Glebjack/NDM-VOS_powder_hopper/ref/IMG_20230818_101742_008.jpg

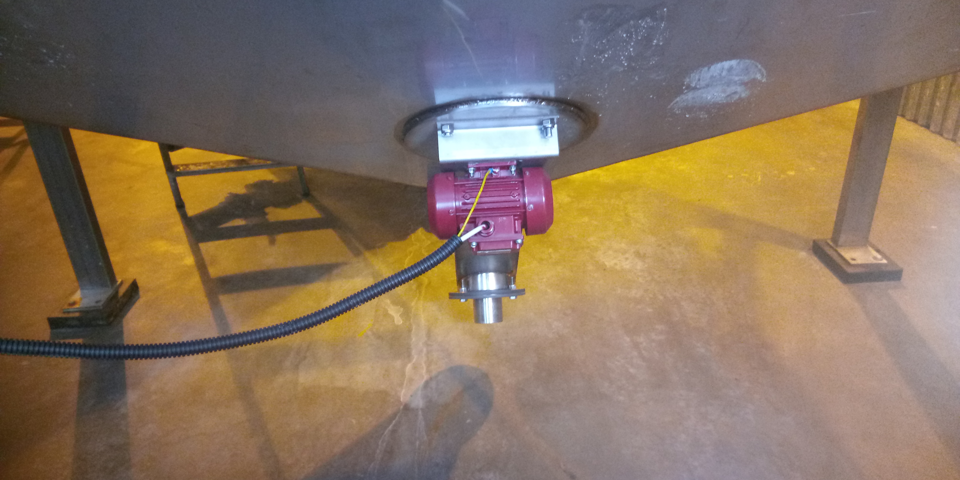
ref/IMG_20230818_101742_008.jpg
