Glebjack/NDM-VOS_powder_hopper/Доп. информация/Расчет шнекового конвейера Надым.pdf

Расчет шнекового конвейера Исходные данные
Материал - Каустическая сода
Насыпная плотность материала | ρн = 2.13 т/м³
Длина конвейера | L = 2
Угол наклона конвейера | f | 25deg =
Производительность | Q | 2 = | т/ч
Коэффициент заполнения желоба | φ = 0.25
Отношение шага винта к диаметру винта | E | 0.8 =
Частота вращения винта | n | 30 = | об/мин
Коэффициент уменьшения производительности
от наклона конвейера

Rβ = 0.5

Коэффициент абразивности | A = 45
Наибольший размер кусковматериала | amax = 0.015 | м

Определяемнеобходимый диаметр винта по формуле:
D | 0.275 | Q
En· ·φ ρн · Rβ · · | 0.275

2
0.8 30 · ·0.25·2.13·0.5 = | = | · | = 0.086 м

Проверяемчастоту вращения:

nmax

A
D

45
0.086
= | = | = 153.4 об/мин
nnmax ≤ | = 30 153.4 ≤ | = 1

Проверяемдиаметр винта:
Коэффициент для рядового груза | k | 4 =
Damax > | ·k = 0.086 0.015 4 > | · = 1
Подбираемстандартный диаметр и шаг винта из таблицы
Dст = 0.09 | м
Sст = 0.09 | м
Уточняемчастоту оборотов
nст | 0.275 | Q
EDст · | ·φ ρн · Rβ · · | 0.275

2
0.8 0.09 · | ·0.25·2.13·0.5 = | = | · | = 28.69 об/мин

Проверяемчастоту вращения

nст

A
Dст
≤ | 28.69

45
0.09
= | ≤ | = 1
Такимобразом, допустимая частота вращения винта | nст = 28.69 | об/мин

Определение мощностина валу винта Исходные данные
Горизонтальная проекция
длины конвейера
Lг1 = L cos f · () = 2 cos 25 deg · ( | ) · | = 1.81 | м
Lг | Lг1 = | = 1.81 | м
Высота подъема | H1 = L sin f · () = 2 sin 25 deg · ( | ) · | = 0.845 | м
H | H1 = | = 0.85 | м

Коэффициент сопротивления
перемещению груза

ω = 2.5

Коэффициент, учитывающий характер перемещения винта

R = 0.2

Погонная масса вращающихся частей конвейера

gk | 100 Dст = | · | = 100 0.09 · | = 9 | кг/м

Коэффициент сопротивления
движению вращающихся частей конвейера

ωв = 0.16

Осевая скорость движения груза | υ

Sст nст ·

60

0.09 28.69 ·
60 = | = | = 0.043 | м/с

Мощность на валу винта:

N0

Q
367
Lг ·( | ) ·ω + H | 0.02 R· gk · Lг · ωв + | · | 2
367 = | = | ·( | ) 1.81 2.5 · | + 0.85 + 0.02 0.2 · ·9·1.81·0.16 = 0.04 *
кВт

Определение мощностидвигателя для привода шнекового конвейера

Исходные данные
Коэффициент запаса мощности для
приводов шнеков

K = 1.25

КПДпривода | η = 0.85

Мощность двигателя:

N

KN0 ·

η

1.25 0.04 ·
0.85 = | = | = 0.059 | кВт
