Glebjack/NDM-VOS_powder_hopper/РАЗГРУЗЧИК 2.377.06.00.00 (2)/2.377.06.00.10_Бункер — копия.PDF

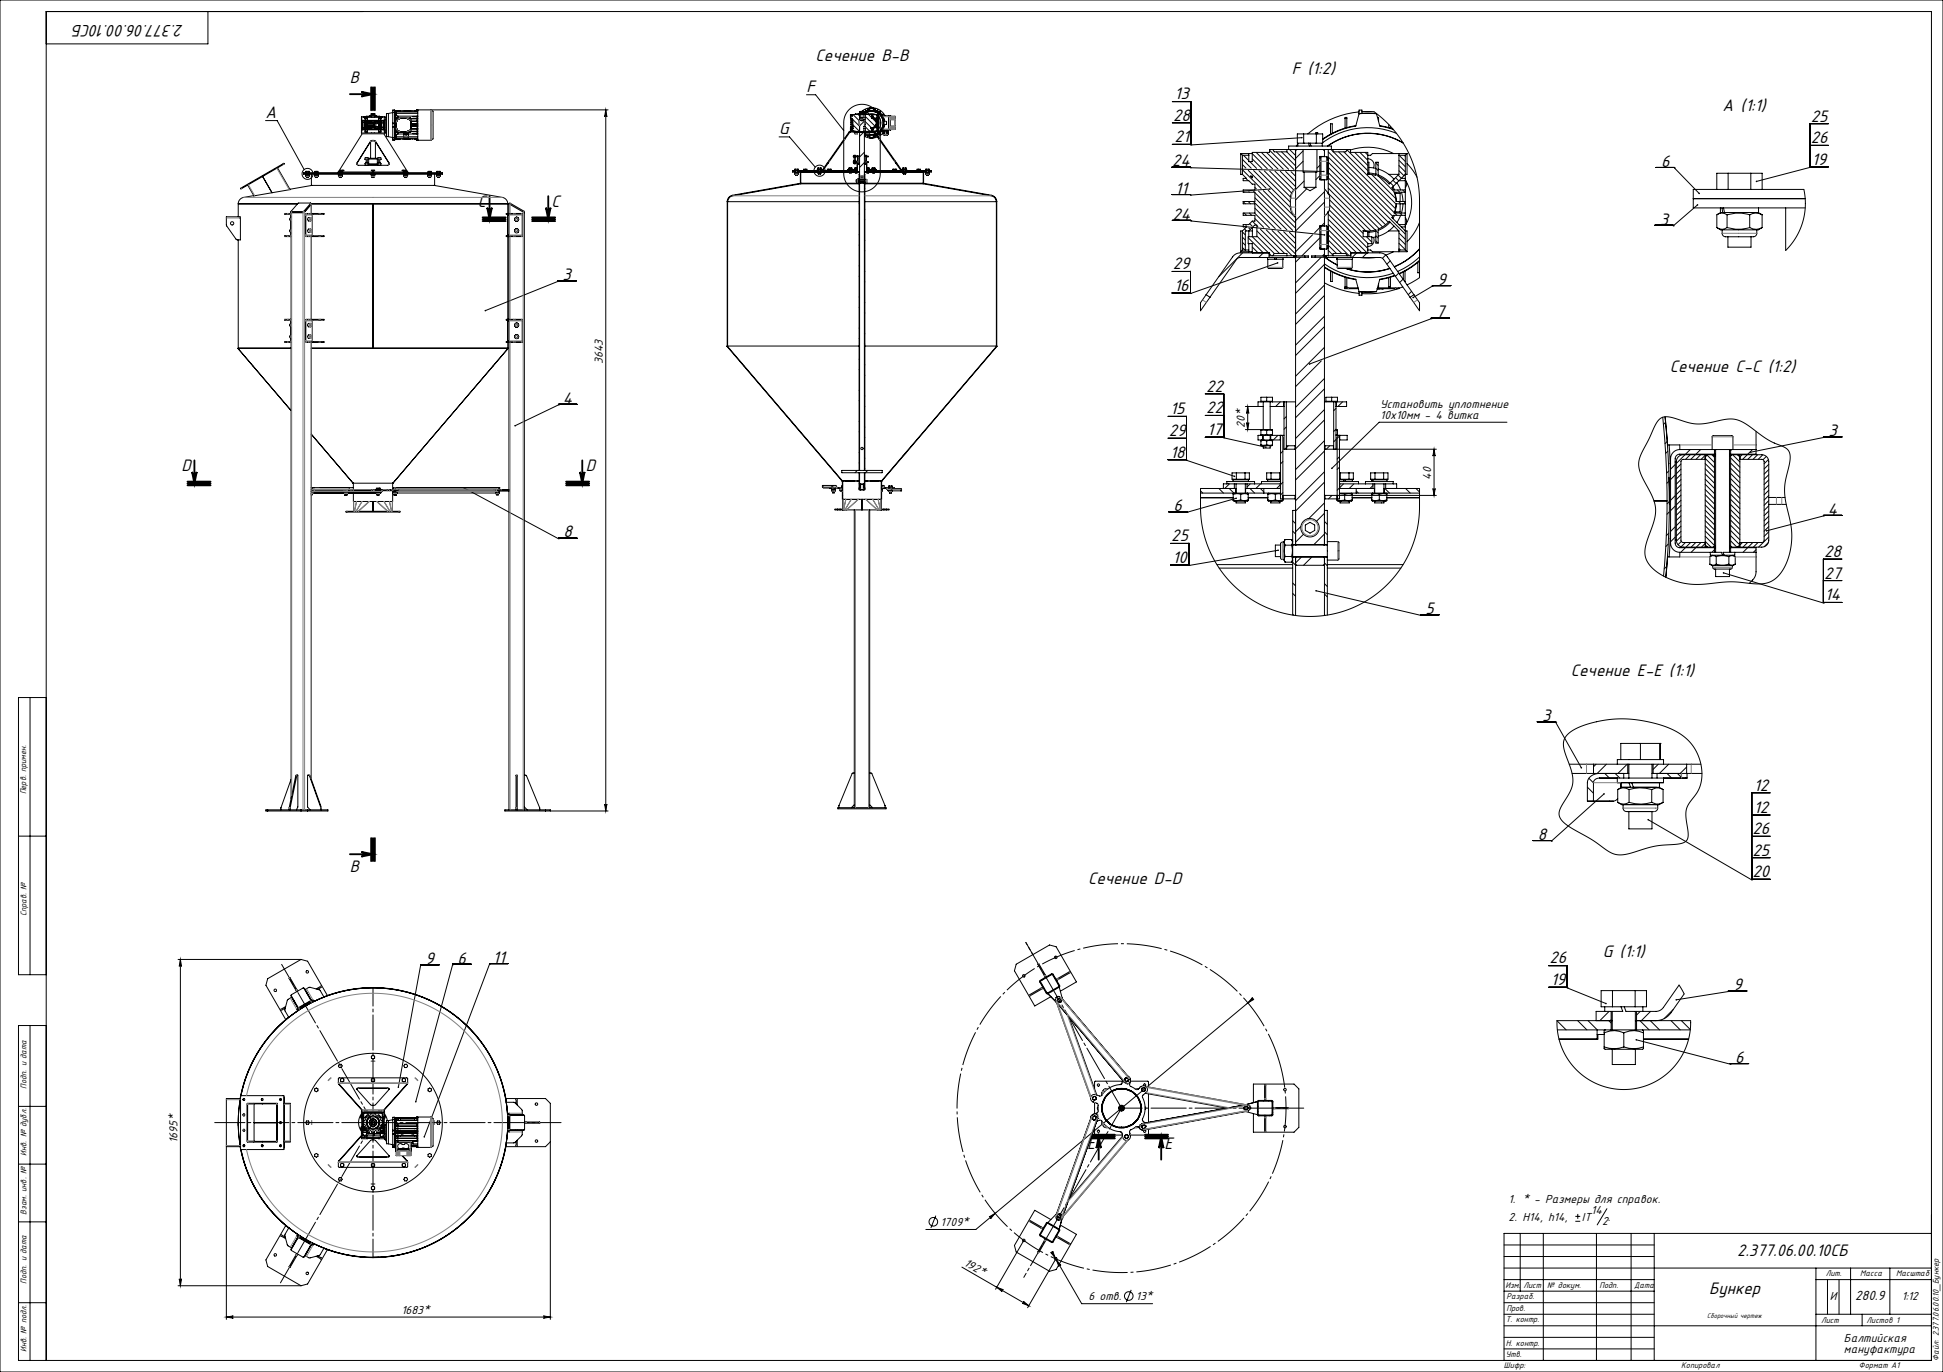
[picture p3: page 1]
Сечение B-B; Сечение C-C (1:2); 6 отв. 13*; Сечение D-D; Сечение E-E (1:1); Установить уплотнение 10х10мм - 4 витка; Инв. № подл.; Формат A1; Файл: 2.377.06.00.10_Бункер; Шифр:; Версия 3

Подп. и дата Взам. инв. № Инв. № дубл. Подп. и дата Перв. примен. Справ. №

1. * - Размеры для справок.

Бункер Сборочный чертеж | Лит. | Масса | Масштаб

Изм. Лист № докум. | Подп. | Дата | | | И | | 280.9 | 1:12
Разраб.
Пров.
Т. контр. | | | Лист | Листов 1

Балтийская мануфактура

Н. контр.
Утв.

Документация

A1 | 2.377.06.00.10СБ | Сборочный чертеж
| | Сборочные единицы
A4 | 1 | 2.377.05.03.20 | Толкатель | 1
A4 | 2 | 2.377.05.04.20 | Кронштейн | 1
A4 | 3 | 2.377.06.02.00 | Емкость | 1
A4 | 4 | 2.377.06.03.00 | Стойка | 3
A4 | 5 | 2.377.06.05.00 | Рыхлитель | 1
A4 | 6 | 2.377.06.07.00 | Крышка | 1

Детали

A3 | 7 | 2.377.06.00.03 | Вал | 1
A4 | 8 | 2.377.06.00.08 | Связь | 6
A3 | 9 | 2.377.06.00.09 | Кронштейн | 1

Стандартные изделия

10 | Болт М10х45 DIN 912 12.9 ОКС | 2
11 | Мотор-редуктор NMRV050 | 1
12 | Шайба 10 DIN125 | 18
13 | Шайба кузовная 12 DIN9021 | 1
14 | Болт М12х110 DIN 912 12.9 ОКС | 12
15 | Шайба кузовная 8 DIN9021 | 6
16 | Болт М8х16 DIN 912 | 4
| | 2.377.06.00.10

Инв. № подл. Подп. и дата Взам. инв. № Инв. № дубл. Подп. и дата Перв. примен. Справ. №

Формат А4

Копировал

Изм. Лист | № докум. | Подп. | Дата
| Разраб. | | | Бункер | Лит. | Лист | Листов
Пров. | | | | И | | 1 | 2

Н. контр.
Утв.

Файл: 2.377.06.00.10_Бункер

Формат
Зона
Поз.
Обозначение | Наименование

Кол.

Приме-чание

Инв. № подл. Подп. и дата Взам. инв. № Инв. № дубл. Подп. и дата

Лист
2
Копировал | Формат А4

2.377.06.00.10
Изм. Лист | № докум. | Подп. | Дата

Файл: 2.377.06.00.10_Бункер

| Наименование | | Приме-чание Обозначение
17 | Болт М6х40 DIN 933 | 3
18 | Болт М8х20 DIN 933 | 6
19 | Болт М10х25 DIN 933 | 18
20 | Болт М10х30 DIN 933 | 9
21 | Болт М12х25 DIN 933 | 1
22 | Гайка М6 DIN 934 | 6
23 | Стоп. кольцо 25 DIN 471 | 1
24 | Шпонка 8х7х20 DIN 6885 | 2
25 | Гайка М10 DIN985 | 23
26 | Шайба гр. М10 DIN127 | 27
27 | Гайка М12 DIN985 | 12
28 | Шайба гр. М12 DIN127 | 13
29 | Шайба гр. М8 DIN127 | 10

Кол.

Зона
Поз.

Формат
