Glebjack/NDM-VOS_powder_hopper/РАЗГРУЗЧИК 2.377.06.00.00 (2)/2.377.06.01.00_Транспортер — копия.PDF

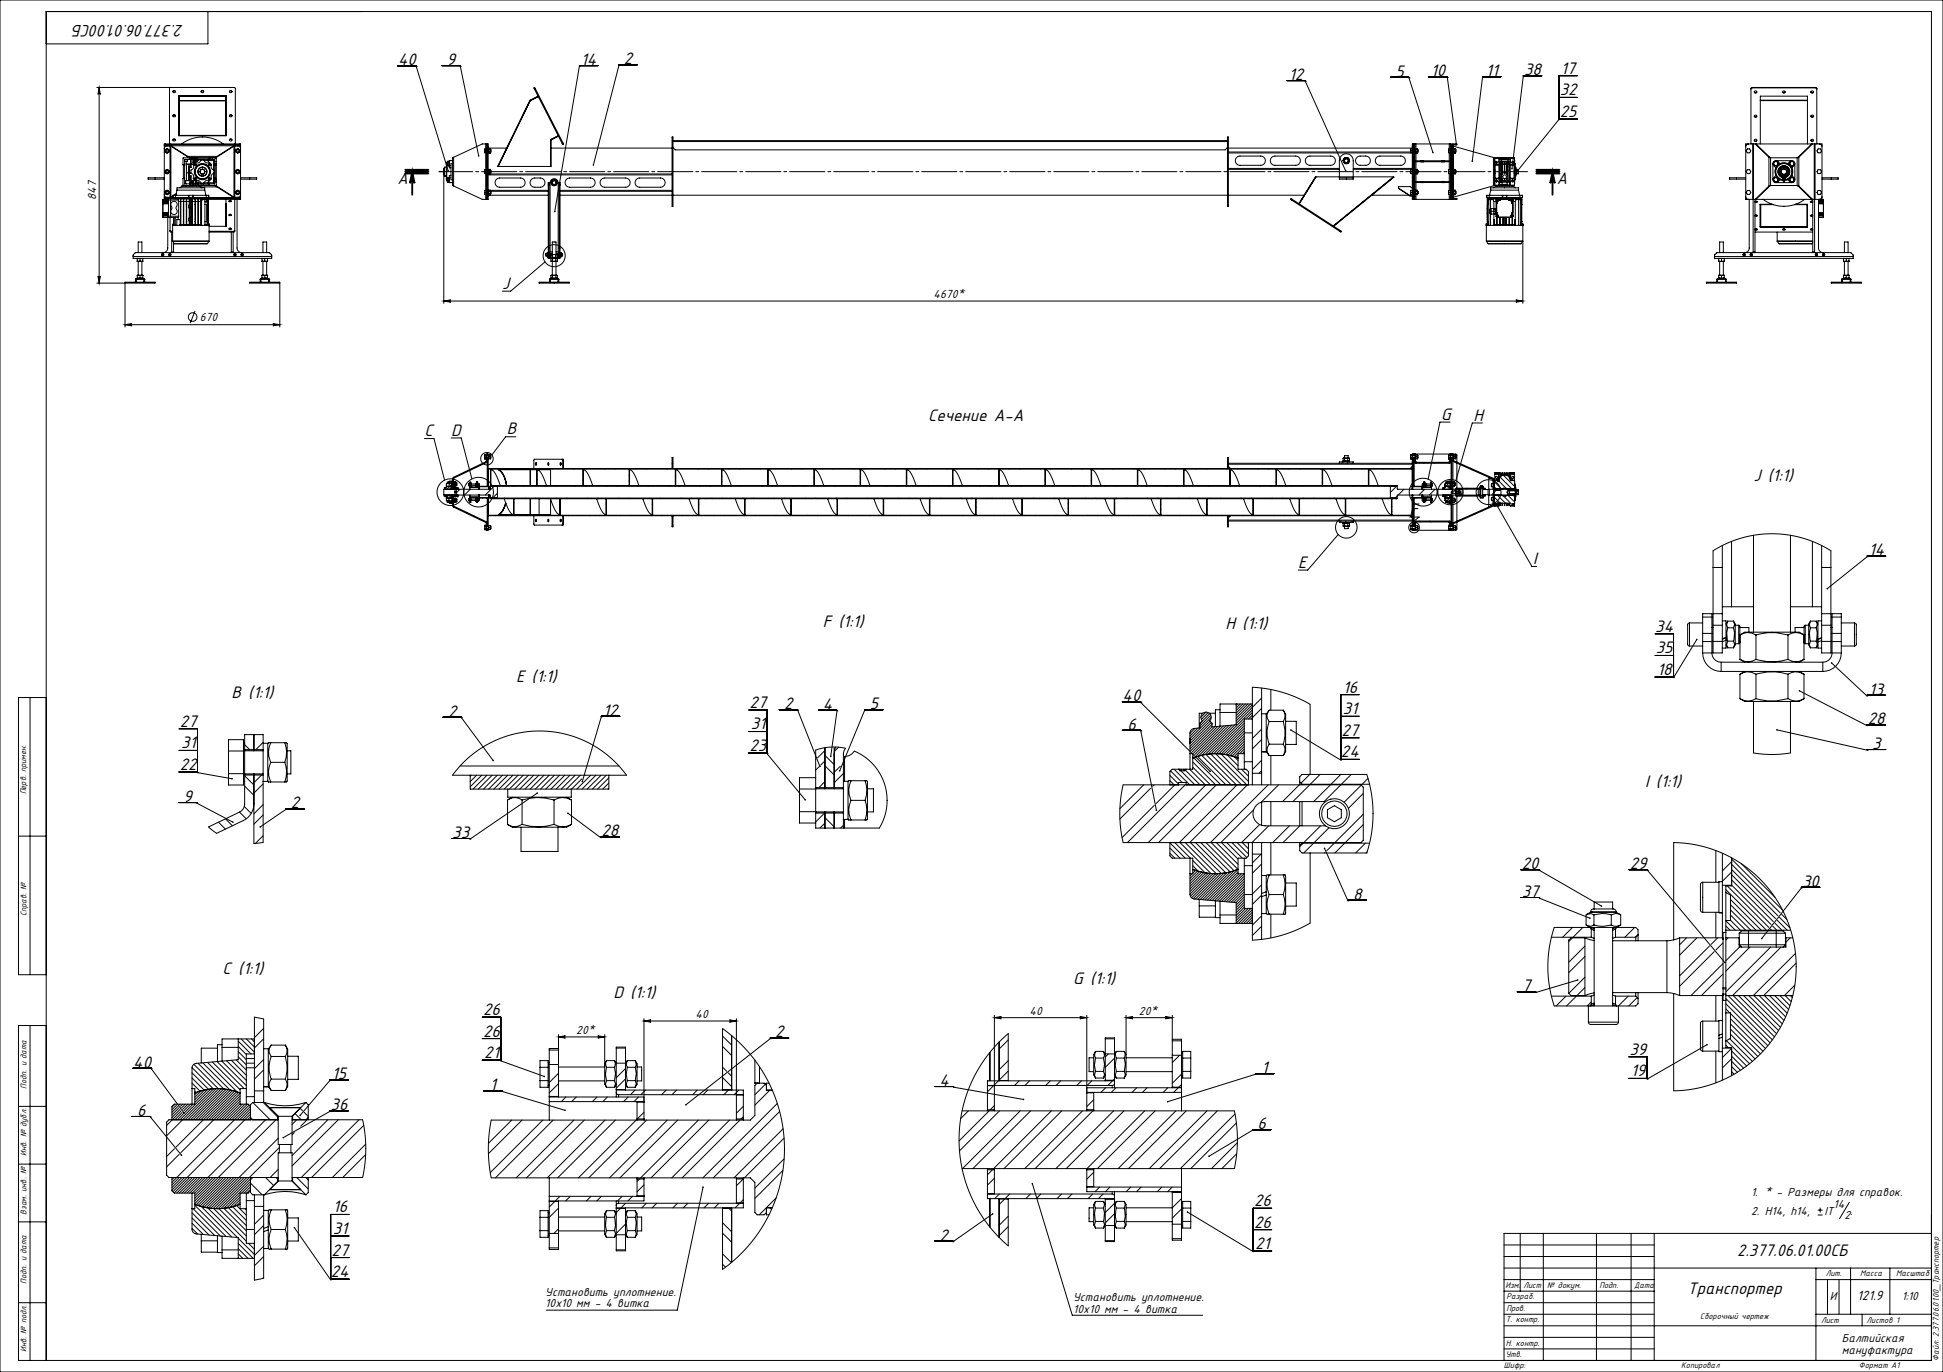
[picture p4: page 1]
Сечение A-A; Установить уплотнение. 10х10 мм - 4 витка; Инв. № подл.; Формат A1; Файл: 2.377.06.01.00_Транспортер; Шифр:; Версия 3

Подп. и дата Взам. инв. № Инв. № дубл. Подп. и дата Перв. примен. Справ. №

1. * - Размеры для справок.

Транспортер Сборочный чертеж | Лит. | Масса | Масштаб

Изм. Лист № докум. | Подп. | Дата | | | И | | 121.9 | 1:10
Разраб.
Пров.
Т. контр. | | | Лист | Листов 1

Балтийская мануфактура

Н. контр.
Утв.

Документация

A1 | 2.377.06.01.00СБ | Сборочный чертеж
| | Сборочные единицы
A4 | 1 | 2.377.05.03.20 | Толкатель | 2
A4 | 2 | 2.377.06.01.10 | Корпус | 1
A4 | 3 | 2.377.06.01.20 | Опора | 2
A4 | 4 | 2.377.06.01.30 | Фланец | 1
A4 | 5 | 2.377.06.01.40 | Проставка | 2
A4 | 6 | 2.377.06.04.00 | Шнек | 1

Детали

A3 | 7 | 2.377.06.00.01 | Вал | 1
A3 | 8 | 2.377.06.00.02 | Втулка | 1
A3 | 9 | 2.377.06.01.03 | Кронштейн | 1
A3 | 10 2.377.06.01.14 | | Пластина | 1
A3 | 11 2.377.06.01.15 | | Кронштейн | 1
A4 | 12 2.377.06.01.21 | | Уолок | 2
A3 | 13 2.377.06.01.24 | | Профиль | 1
A4 | 14 2.377.06.01.25 | | Профиль | 2
A4 | 15 2.377.06.04.03 | | Втулка | 1

Стандартные изделия

16 | Шайба 10 DIN125 | 8
| | 2.377.06.01.00

Инв. № подл. Подп. и дата Взам. инв. № Инв. № дубл. Подп. и дата Перв. примен. Справ. №

Формат А4

Копировал

Изм. Лист | № докум. | Подп. | Дата
| Разраб. | | | Транспортер | Лит. | Лист | Листов
Пров. | | | | И | | 1 | 2

Н. контр.
Утв.

Файл: 2.377.06.01.00_Транспортер

Формат
Зона
Поз.
Обозначение | Наименование

Кол.

Приме-чание

Инв. № подл. Подп. и дата Взам. инв. № Инв. № дубл. Подп. и дата

Лист
2
Копировал | Формат А4

2.377.06.01.00
Изм. Лист | № докум. | Подп. | Дата

Файл: 2.377.06.01.00_Транспортер

| Наименование | | Приме-чание Обозначение
17 | Шайба кузовная 12 DIN9021 | 1
18 | Болт М6х20 DIN 912 | 8
19 | Болт М8х16 DIN 912 | 4
20 | Болт М8х45 12.9 ОКС DIN 912 | 2
21 | Болт М6х40 DIN 933 | 6
22 | Болт М10х20 DIN 933 | 6
23 | Болт М10х25 DIN 933 | 12
24 | Болт М10х35 DIN 933 | 8
25 | Болт М12х30 DIN 933 | 1
26 | Гайка М6 DIN 934 | 12
27 | Гайка М10 DIN 934 | 26
28 | Гайка М16 DIN 934 | 8
29 | Стоп. кольцо 25 DIN 471 | 1
30 | Шпонка 8х7х20 DIN 6885 | 2
31 | Шайба гр. М10 DIN127 | 26
32 | Шайба гр. М12 DIN127 | 1
33 | Шайба гр. М16 DIN127 | 4
34 | Гайка М6 DIN985 | 8
35 | Шайба гр. М6 DIN127 | 8
36 | Винт М6х16 DIN7991 | 2
37 | Гайка М8 DIN985 | 2
38 | Мотор-редуктор NMRV050 | 1
39 | Шайба гр. М8 DIN127 | 4
40 | Подшипниковый узел UCF205 | 2

Кол.

Зона
Поз.

Формат
