Glebjack/NDM-VOS_powder_hopper/3d party/motovario-nmrv_075-1.snapshot.1/NMRV-075/NMRV_075.png

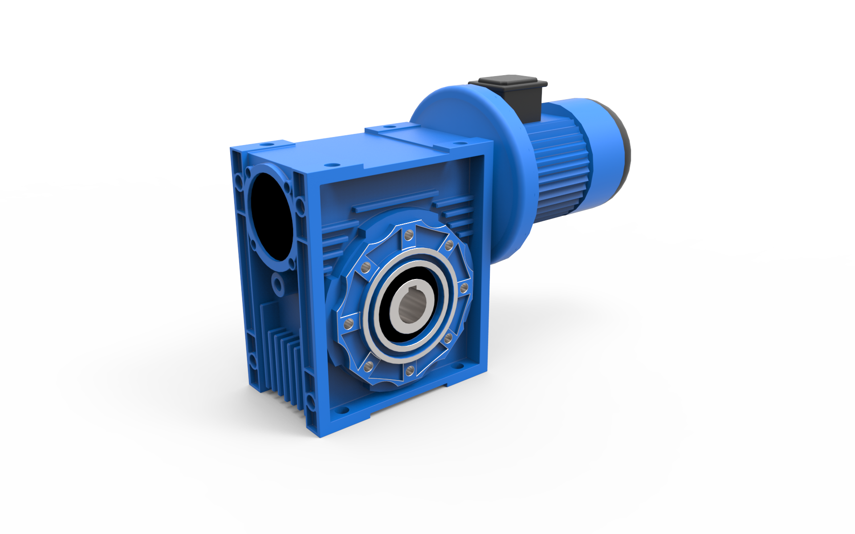
3d party/motovario-nmrv_075-1.snapshot.1/NMRV-075/NMRV_075.png
