Glebjack/NDM-VOS_powder_hopper/5IAM1zdPl06lRufuzuJ0.jpg

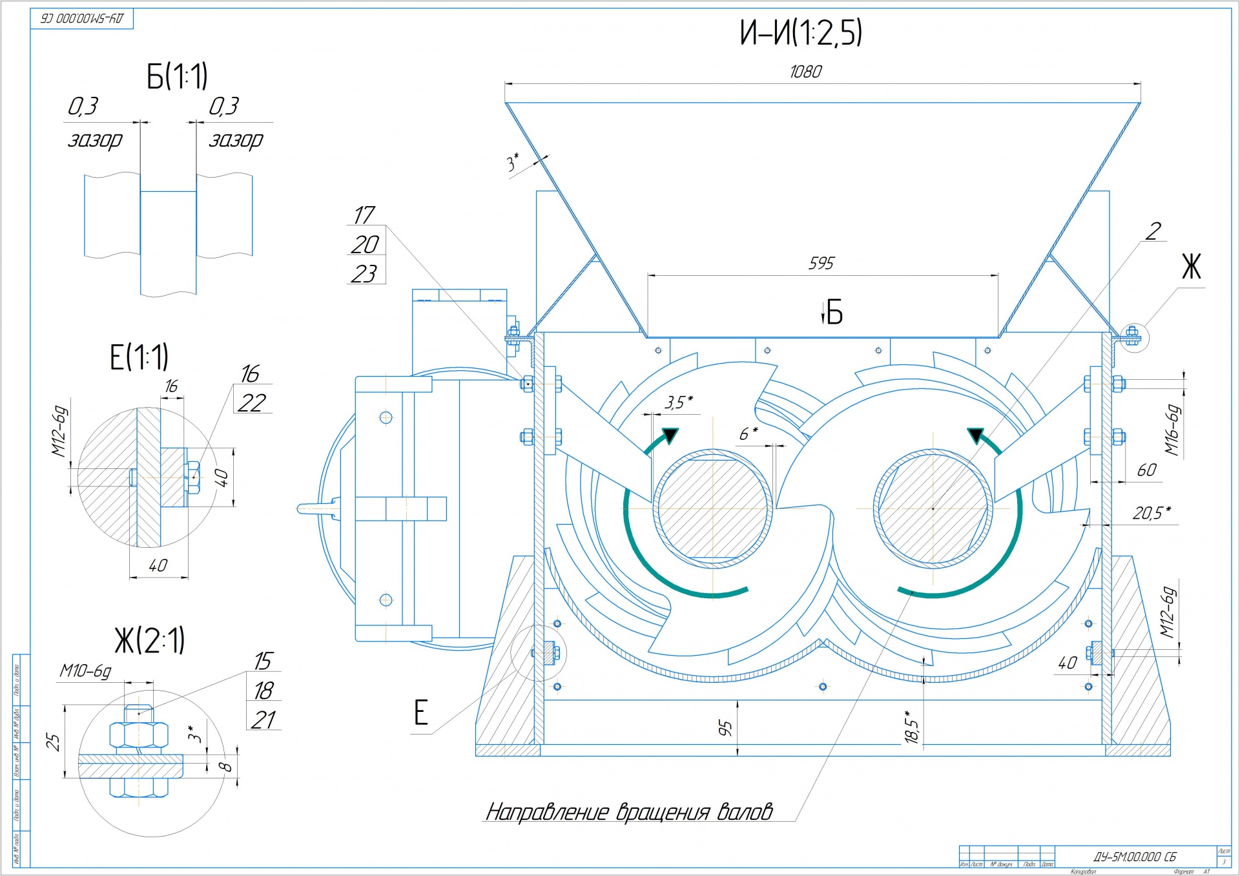
5IAM1zdPl06lRufuzuJ0.jpg
