Glebjack/NDM-VOS_powder_hopper/7G91Iu5bxzjjIsCC4TpQ.jpg

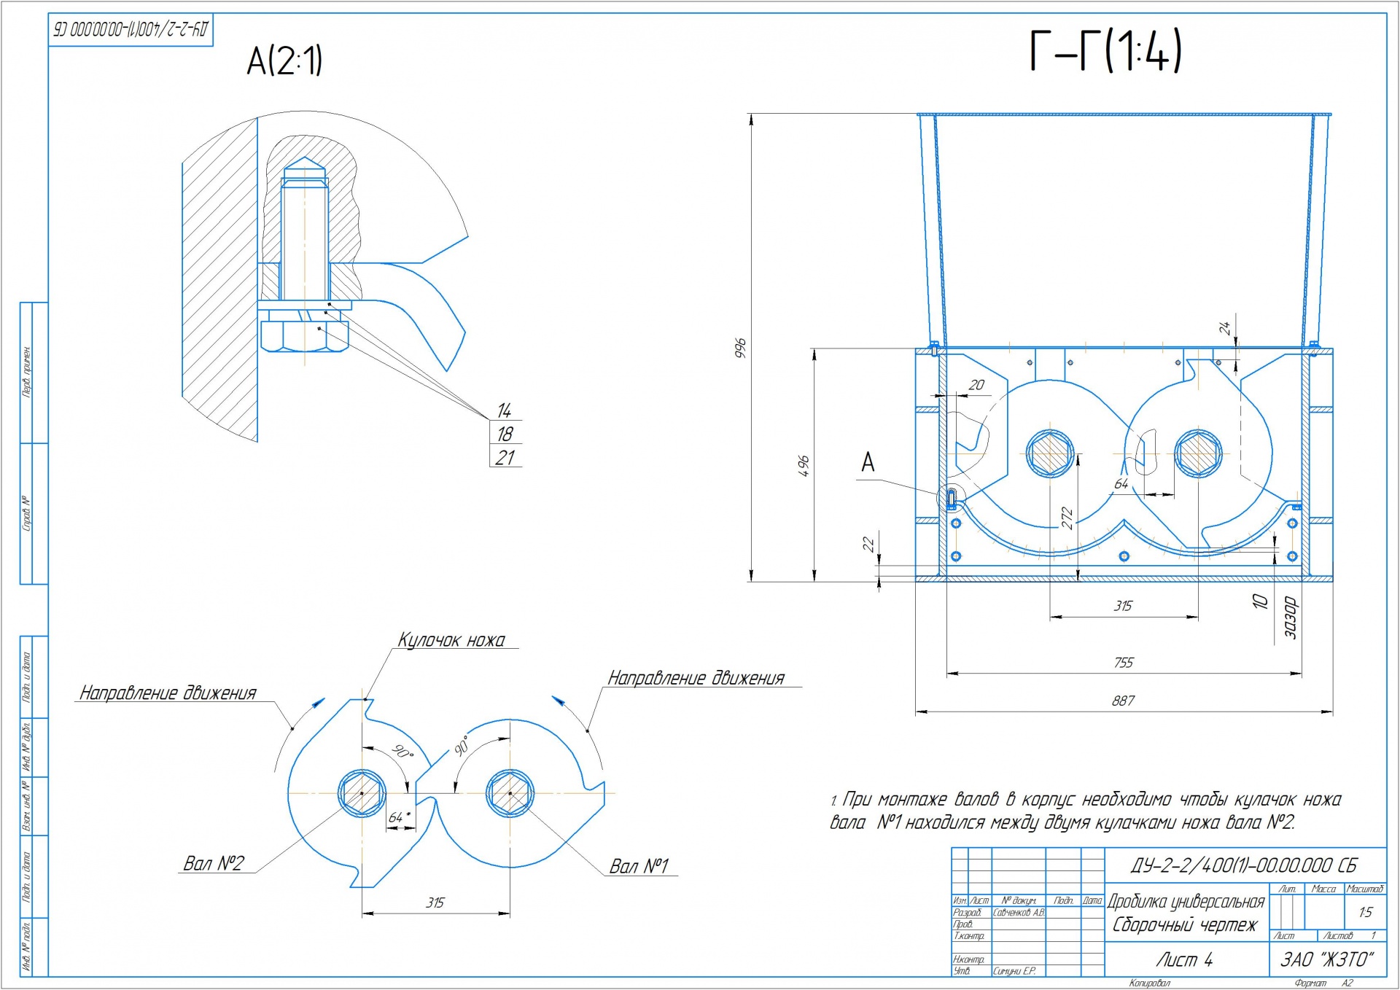
7G91Iu5bxzjjIsCC4TpQ.jpg
