Glebjack/NDM-VOS_powder_hopper/9t0ppVm1Xn2M7Ownl6md.jpg

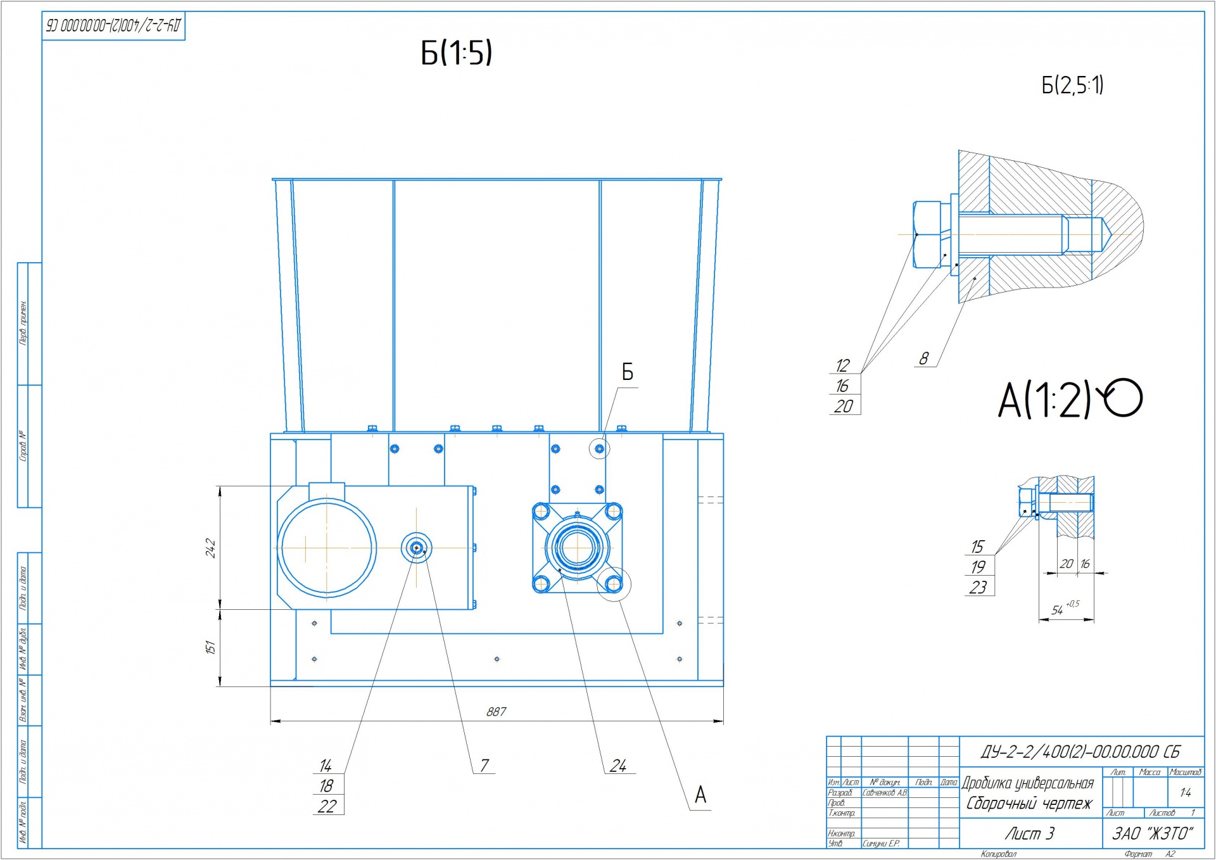
9t0ppVm1Xn2M7Ownl6md.jpg
