Glebjack/NDM-VOS_powder_hopper/15NcvYM45P90KHXVa7Lz.jpg

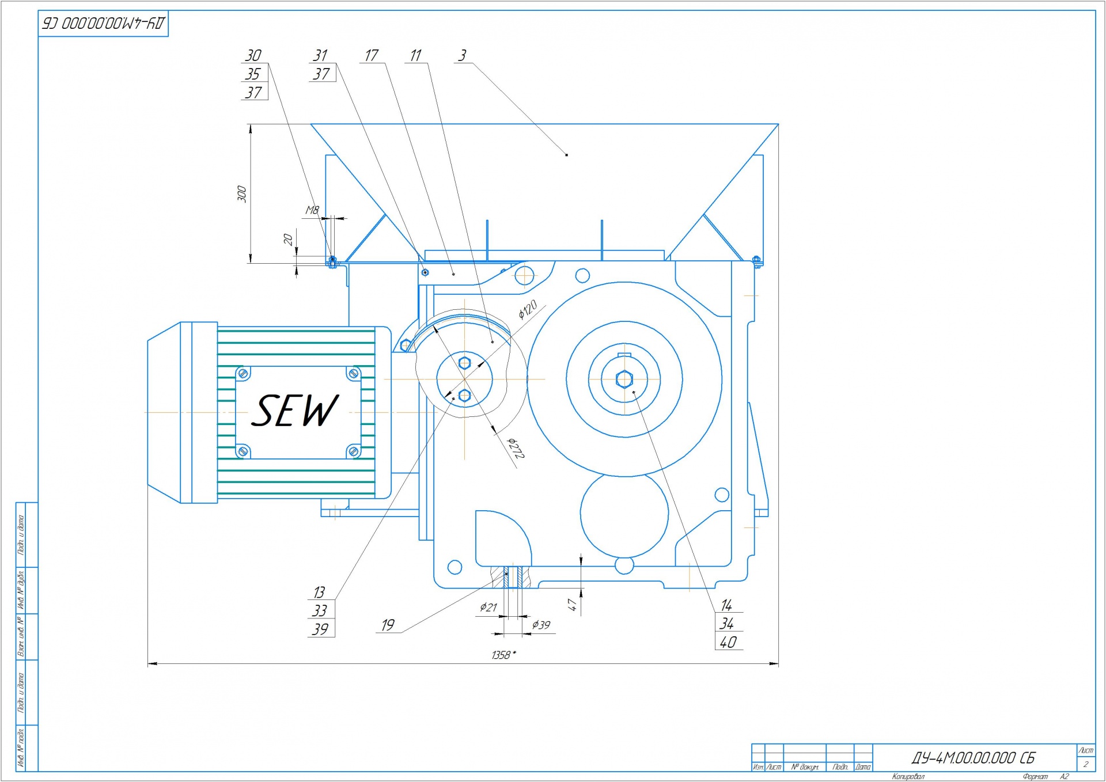
15NcvYM45P90KHXVa7Lz.jpg
