Glebjack/NDM-VOS_powder_hopper/6488771651.jpg

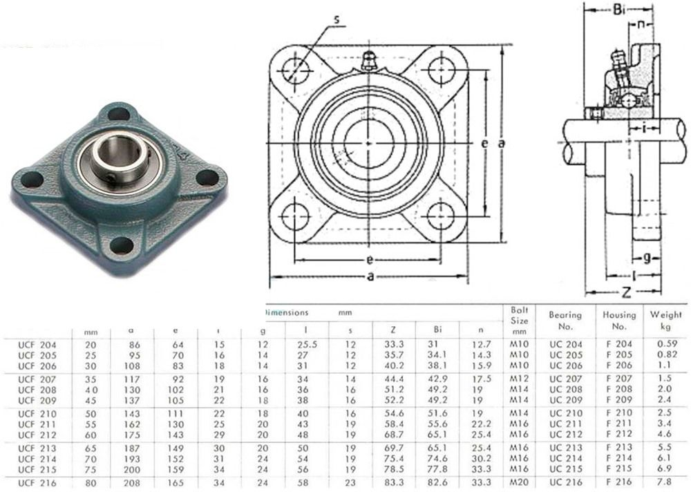
6488771651.jpg
