Glebjack/NDM-VOS_powder_hopper/BA31ilasgLpZYKsGnrt2.jpg

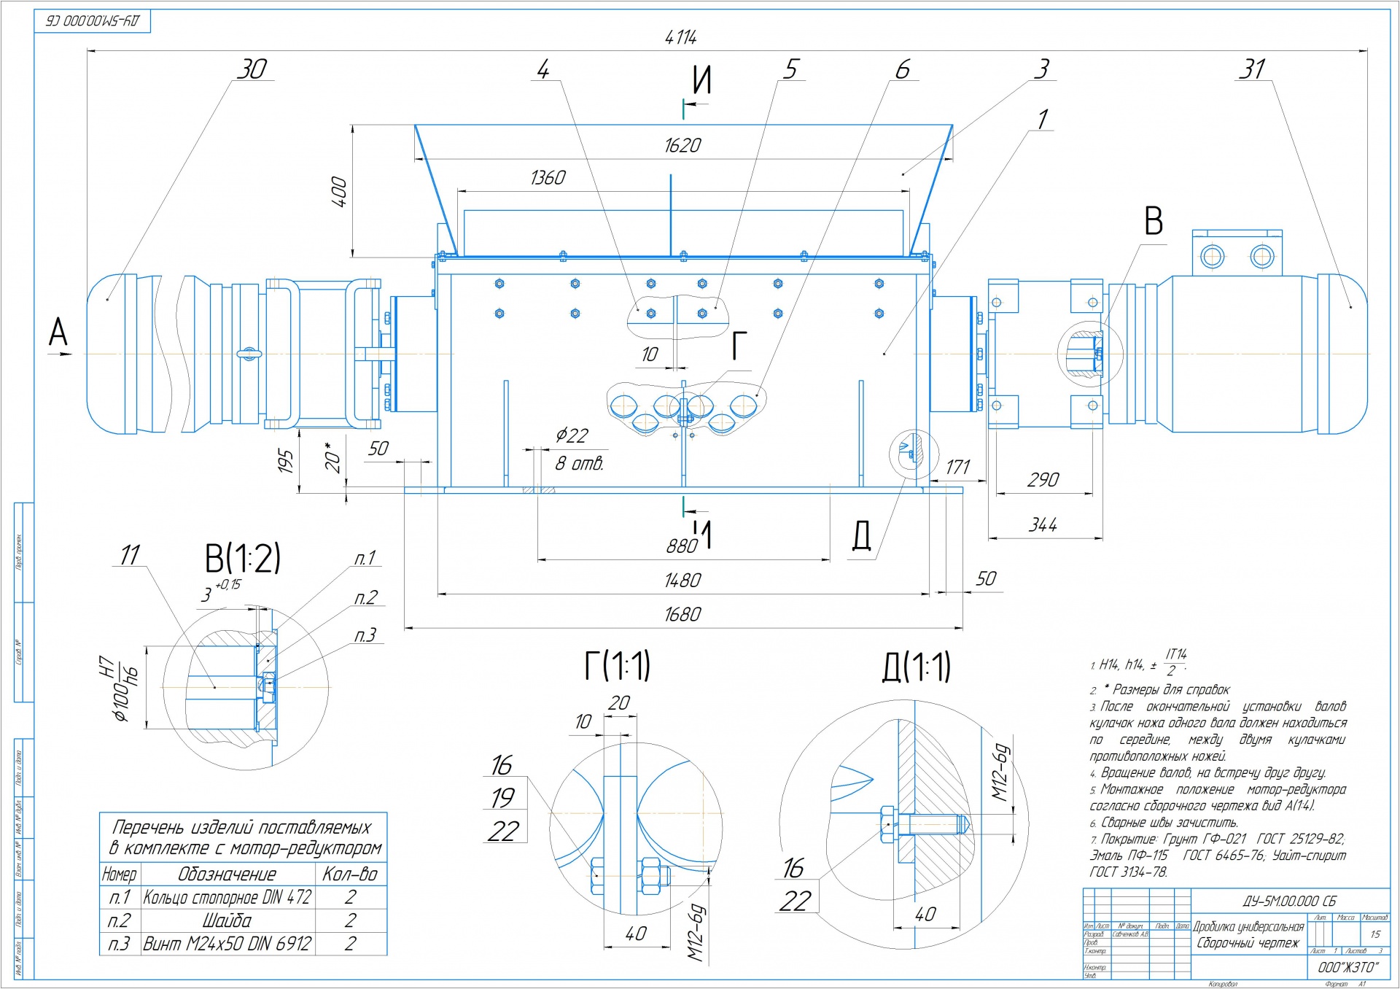
BA31ilasgLpZYKsGnrt2.jpg
