Glebjack/NDM-VOS_powder_hopper/duftldGrA66suCxcDFOZ.jpg

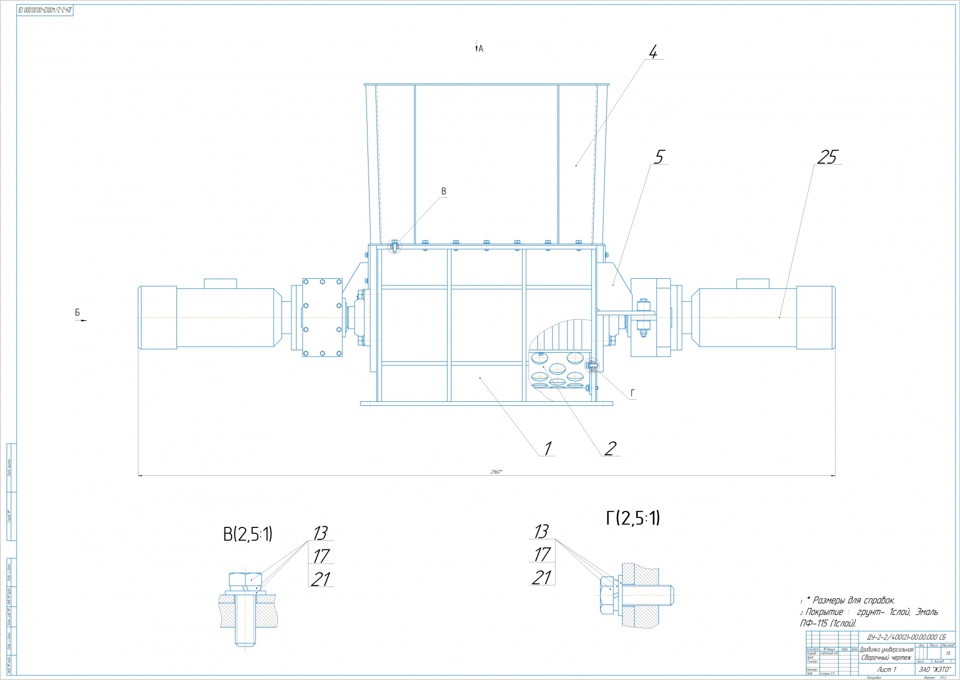
duftldGrA66suCxcDFOZ.jpg
