Glebjack/NDM-VOS_powder_hopper/LHYEUoByCzxDFlodkPbd.jpg

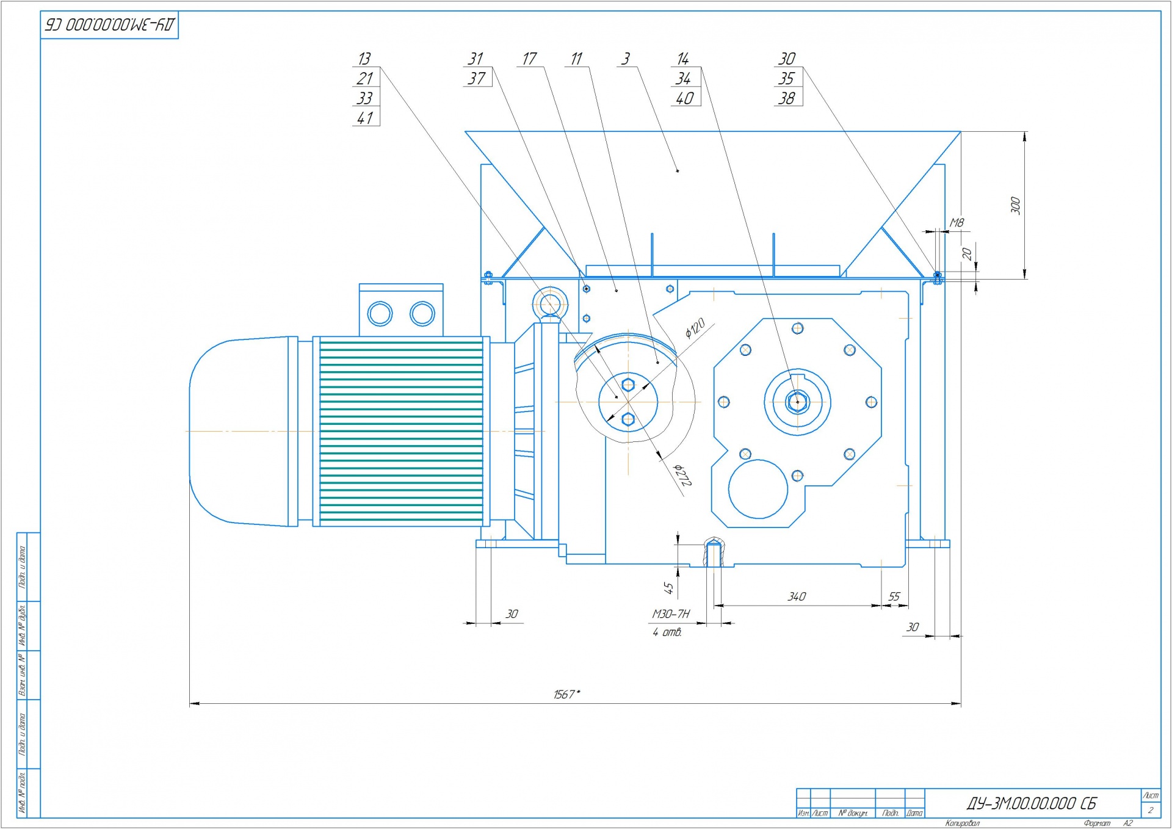
LHYEUoByCzxDFlodkPbd.jpg
