Glebjack/NDM-VOS_powder_hopper/QHXcVnzzSGTzGM04AitN.jpg

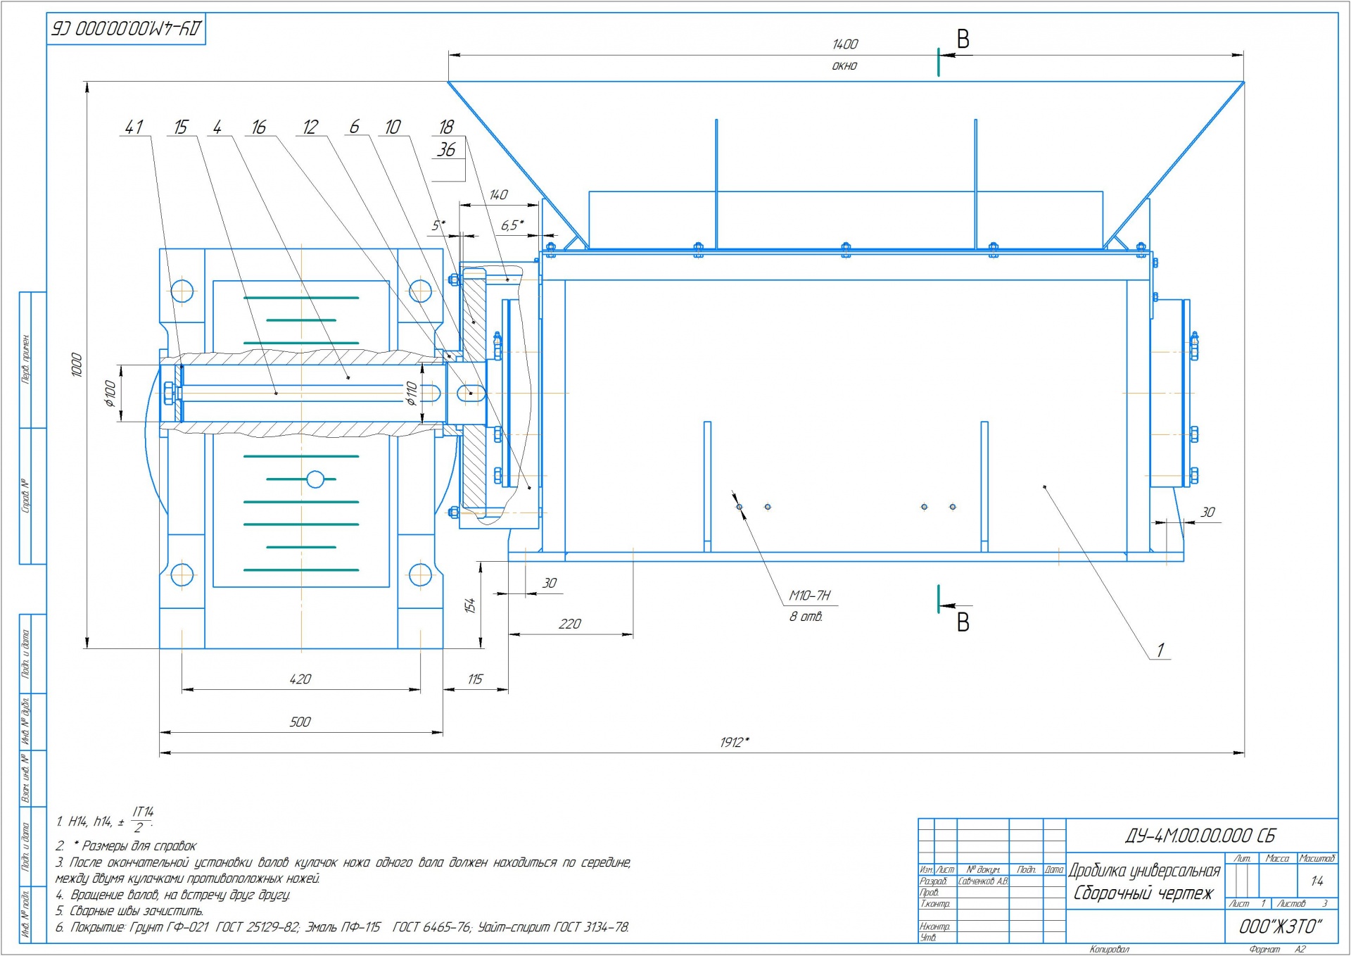
QHXcVnzzSGTzGM04AitN.jpg
