Glebjack/NDM-VOS_powder_hopper/ref/IMG_20230818_101705_347.jpg

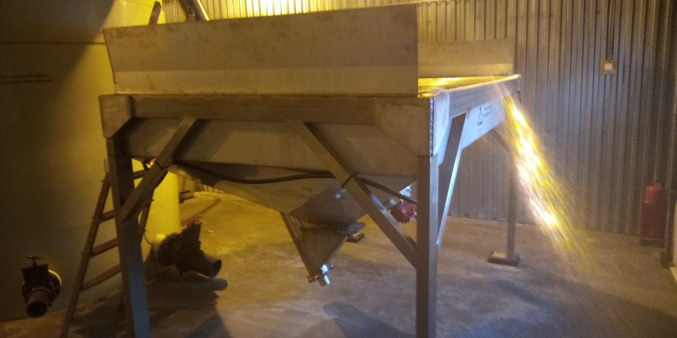
ref/IMG_20230818_101705_347.jpg
