Glebjack/NDM-VOS_powder_hopper/ref/IMG_20230818_101731_674.jpg

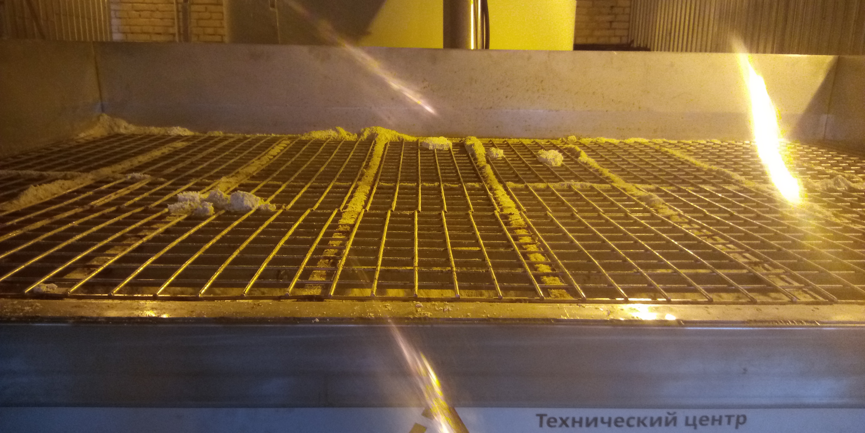
ref/IMG_20230818_101731_674.jpg
