Glebjack/NDM-VOS_powder_hopper/ref/IMG_20230818_101757_844.jpg

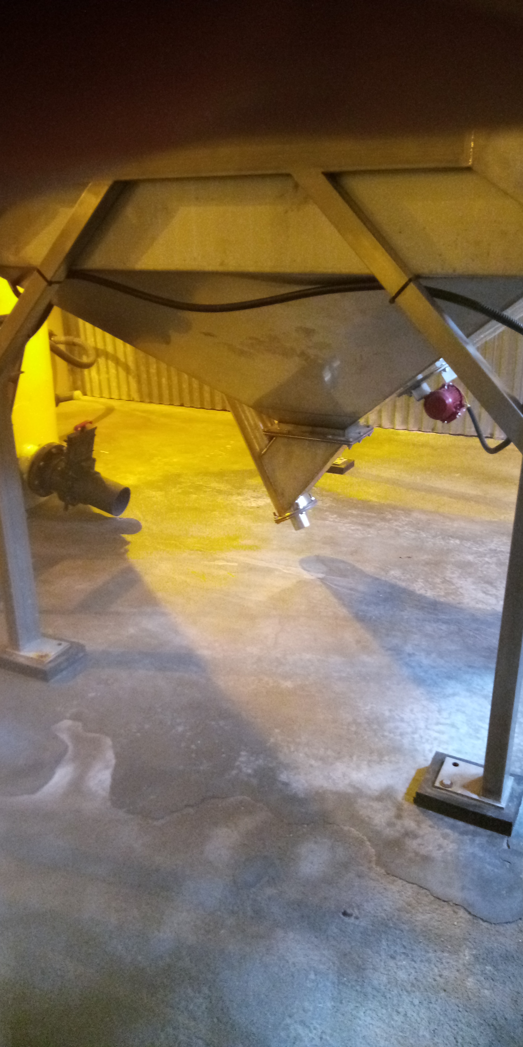
ref/IMG_20230818_101757_844.jpg
