Glebjack/NDM-VOS_powder_hopper/ref/IMG_20230818_101904_786.jpg

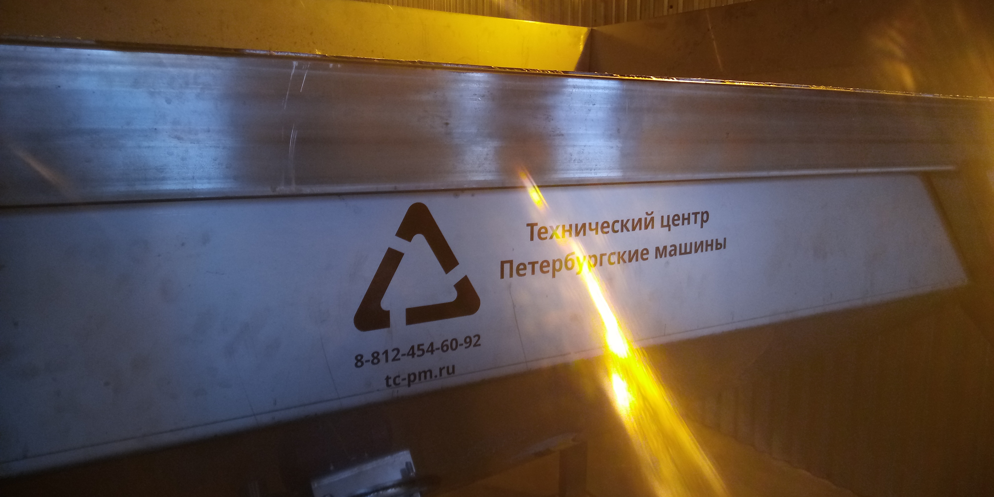
ref/IMG_20230818_101904_786.jpg
