Glebjack/NDM-VOS_powder_hopper/ref/IMG_20230818_101927_983.jpg

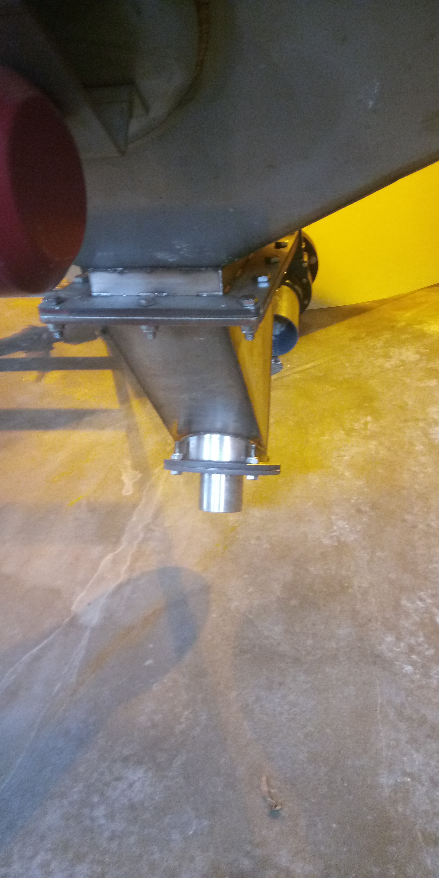
ref/IMG_20230818_101927_983.jpg
