Glebjack/NDM-VOS_powder_hopper/ref/IMG_20230818_102113_298.jpg

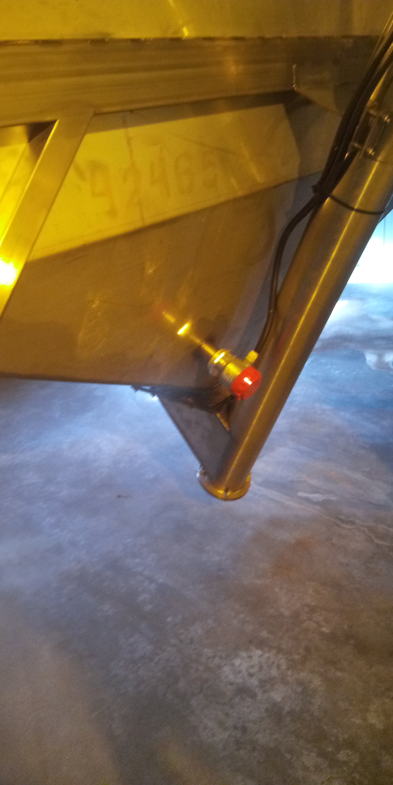
ref/IMG_20230818_102113_298.jpg
