Glebjack/NDM-VOS_powder_hopper/ref/IMG_20230818_102136_022.jpg

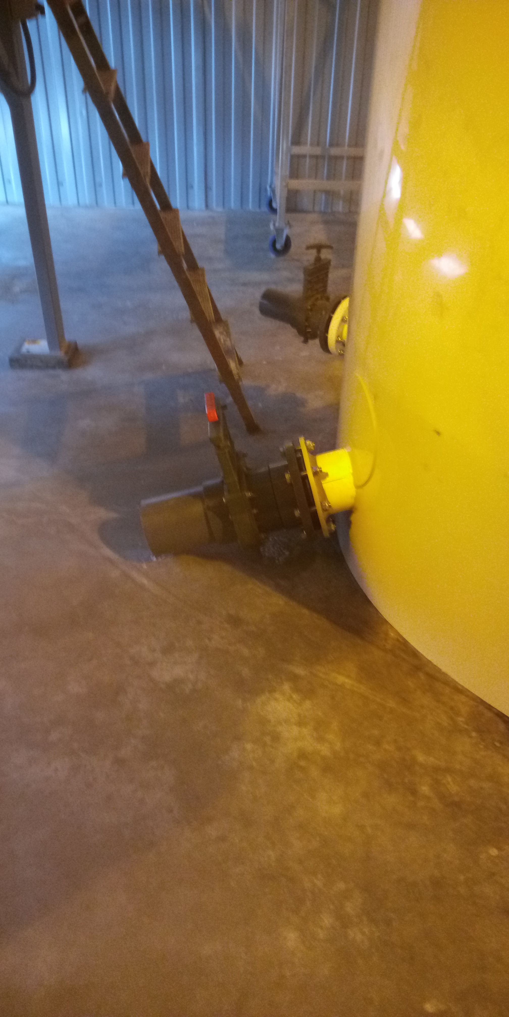
ref/IMG_20230818_102136_022.jpg
