Glebjack/NDM-VOS_powder_hopper/ref/IMG_20230818_102154_722.jpg

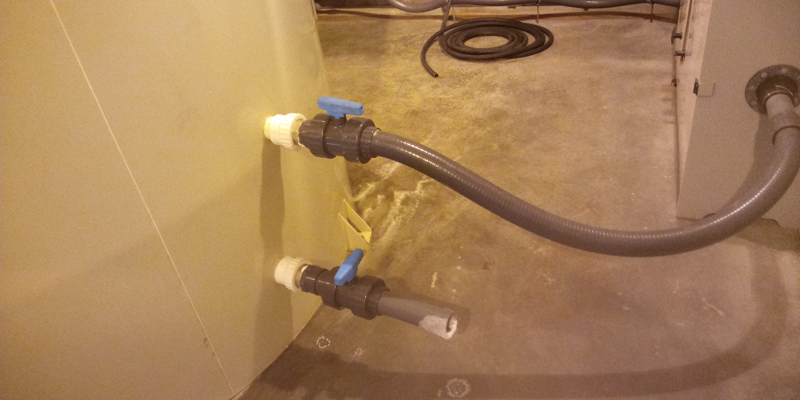
ref/IMG_20230818_102154_722.jpg
