Glebjack/NDM-VOS_powder_hopper/ref/IMG_20230818_102958_261.jpg

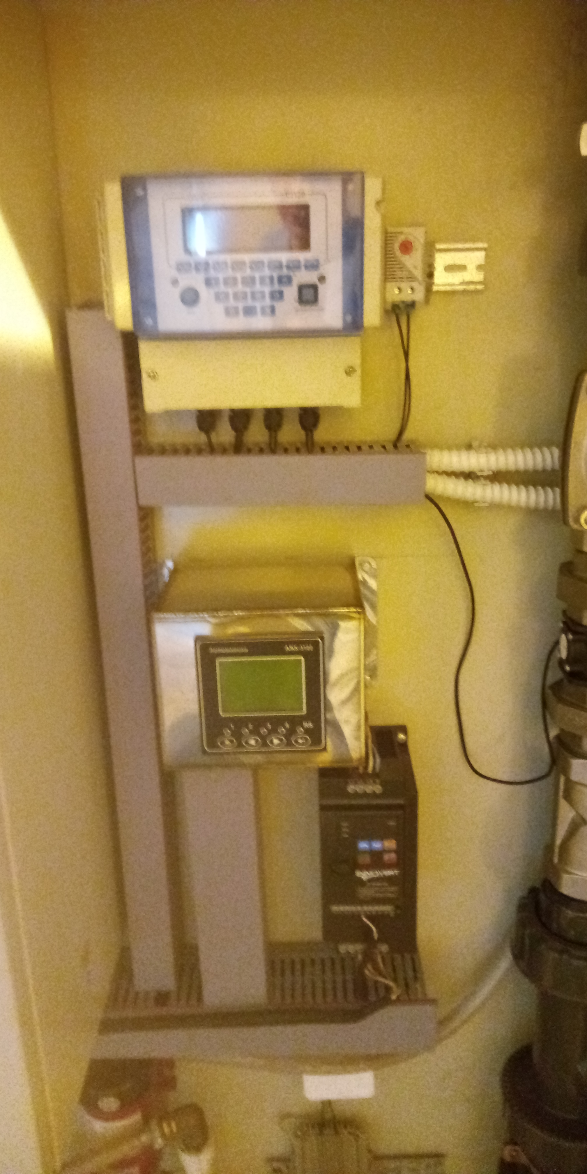
ref/IMG_20230818_102958_261.jpg
