Glebjack/NDM-VOS_powder_hopper/ref/IMG_20230818_103001_816.jpg

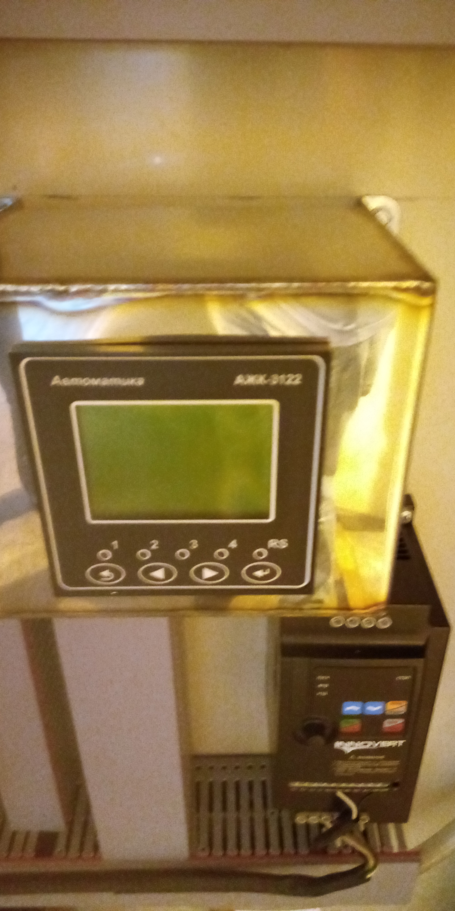
ref/IMG_20230818_103001_816.jpg
