Glebjack/NDM-VOS_powder_hopper/ref/IMG_20230818_103009_851.jpg

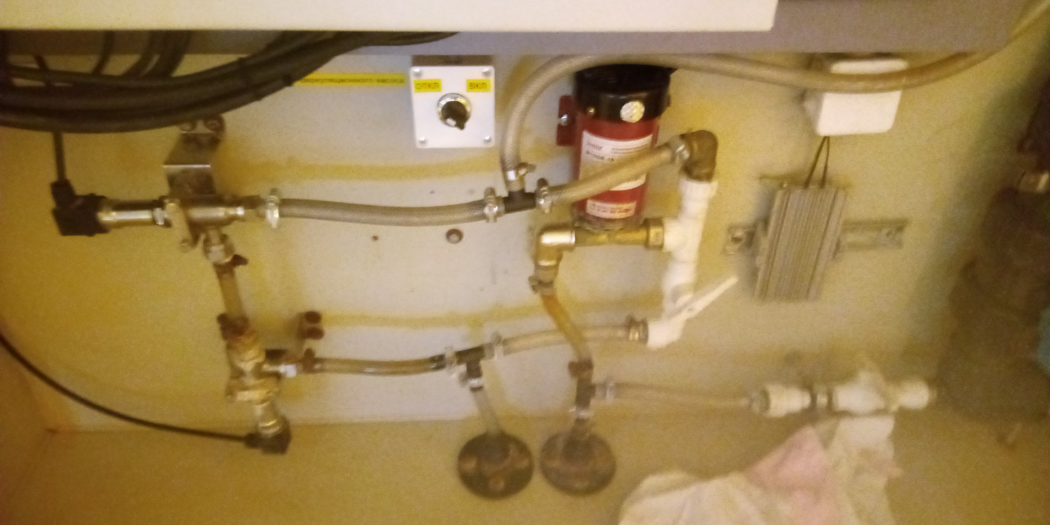
ref/IMG_20230818_103009_851.jpg
