Glebjack/NDM-VOS_powder_hopper/ref/IMG_20230818_103041_582.jpg

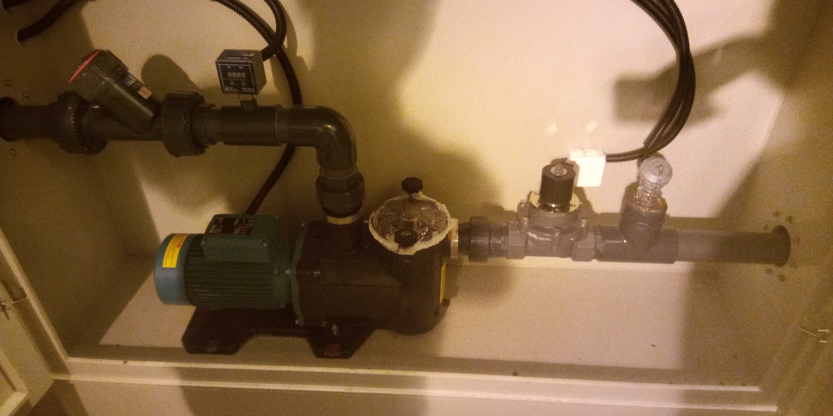
ref/IMG_20230818_103041_582.jpg
