Glebjack/NDM-VOS_powder_hopper/RhiVaKFIQ6GbwMQ6zLSp.jpg

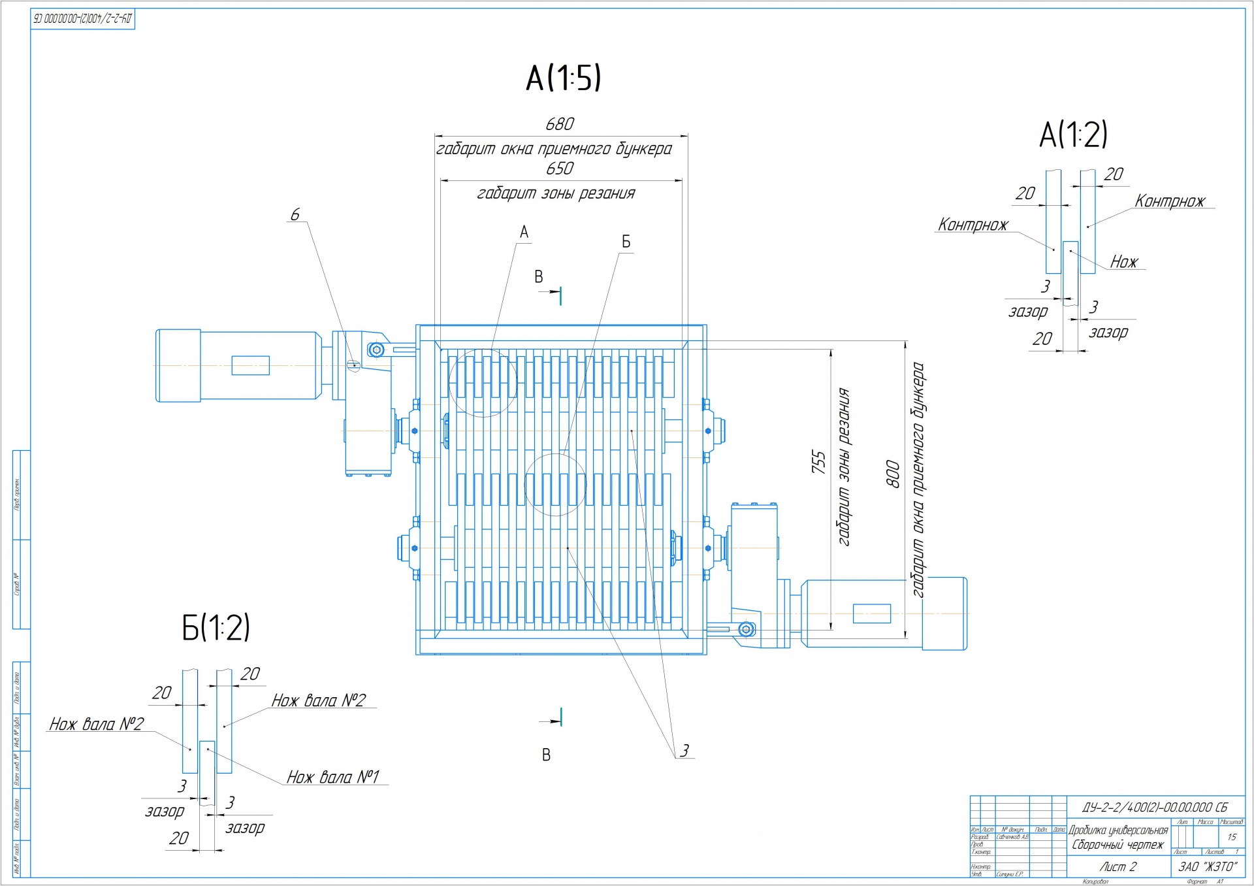
RhiVaKFIQ6GbwMQ6zLSp.jpg
