Glebjack/NDM-VOS_powder_hopper/TTQlbUlX4y6TXQCip1eD.jpg

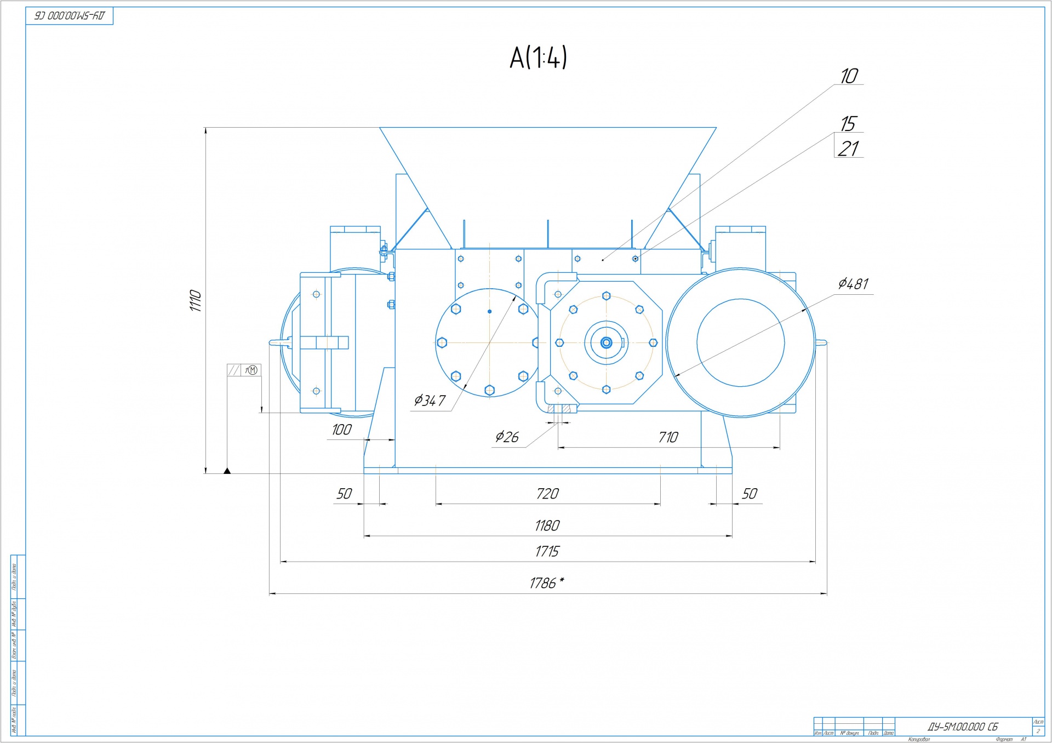
TTQlbUlX4y6TXQCip1eD.jpg
