Glebjack/NDM-VOS_powder_hopper/w9HW6cPyv9YsLJ49e3dh.jpg

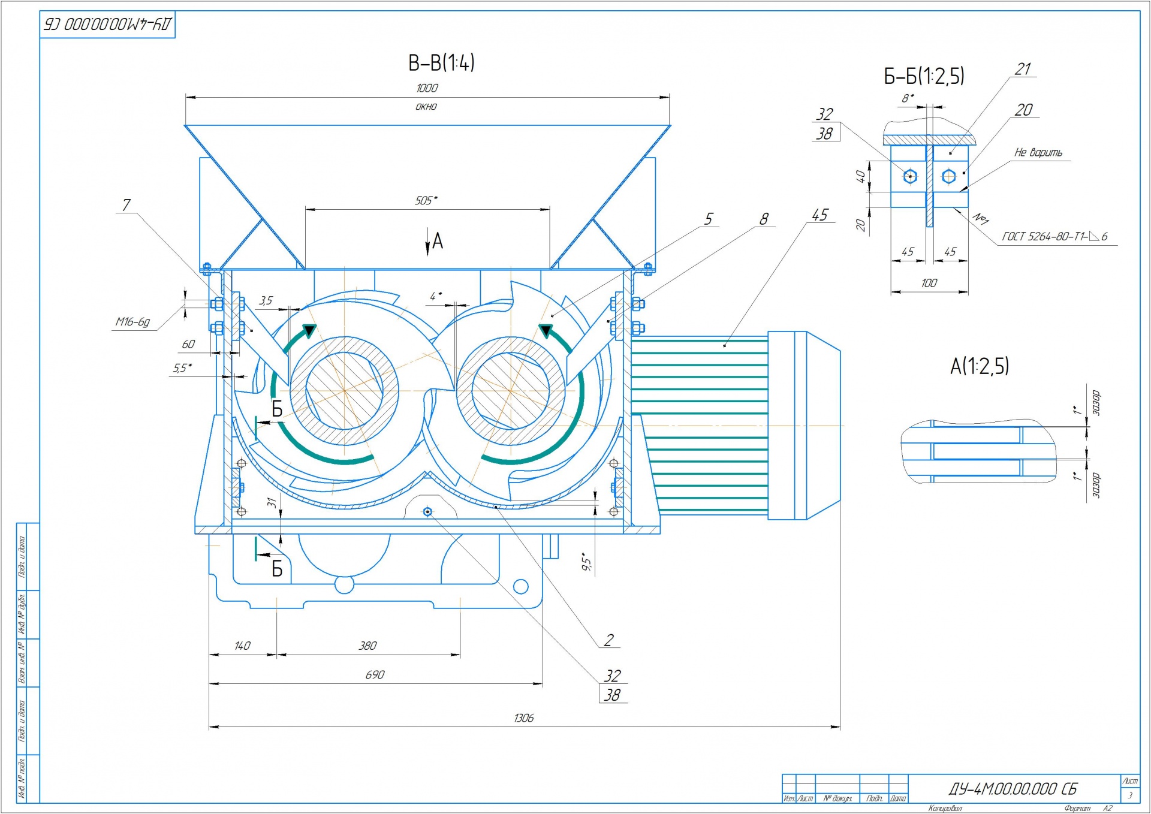
w9HW6cPyv9YsLJ49e3dh.jpg
