Glebjack/NDM-VOS_powder_hopper/Wf6CLpXgVynzGVkt4TXY.jpg

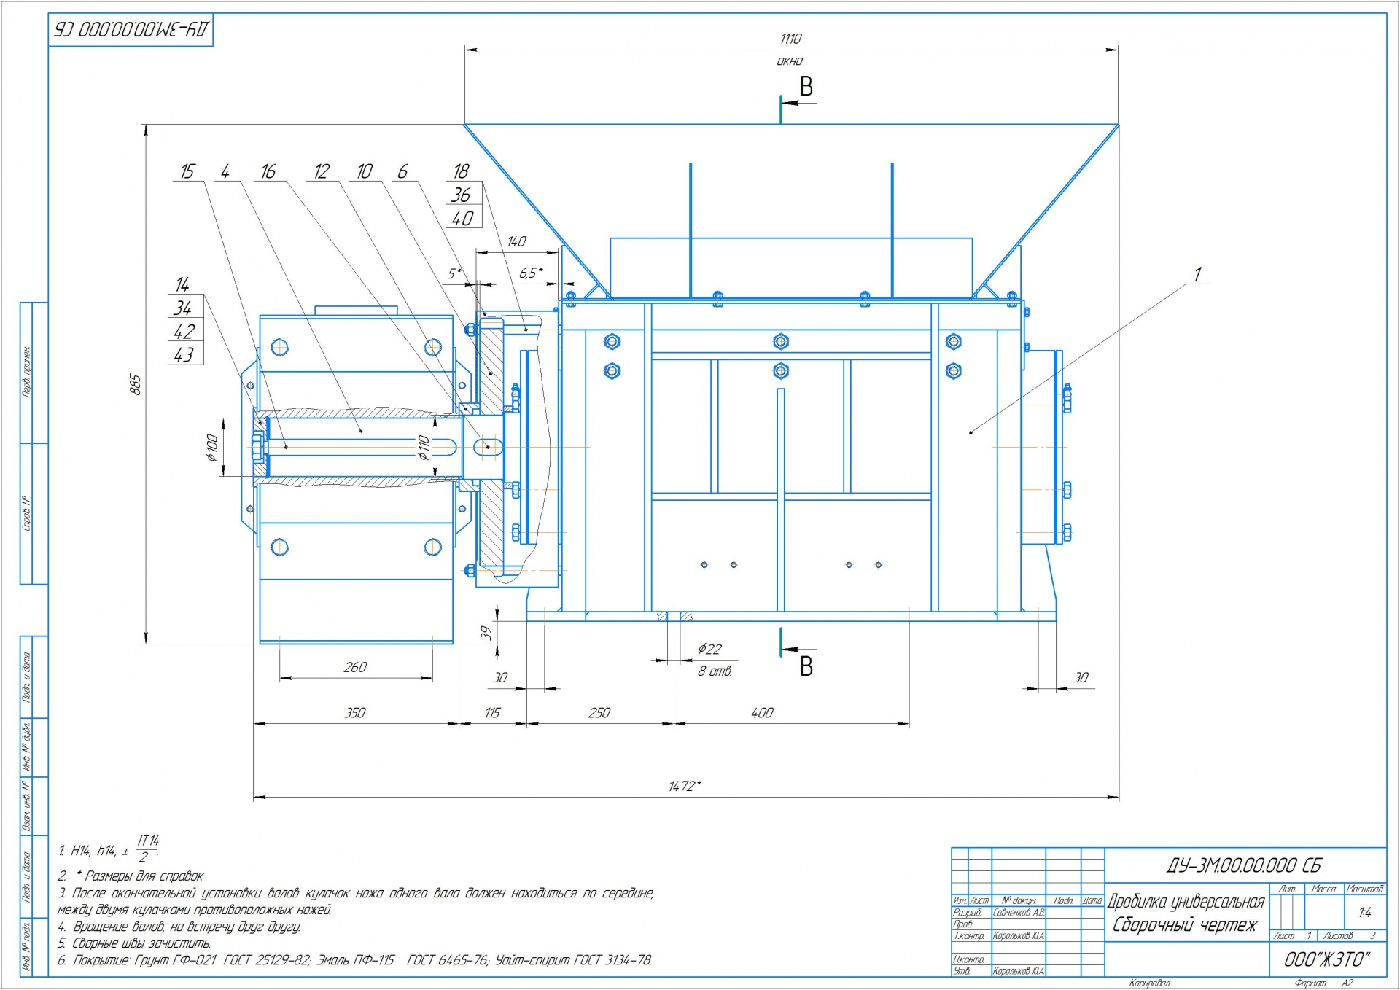
Wf6CLpXgVynzGVkt4TXY.jpg
