Glebjack/NDM-VOS_powder_hopper/РАЗГРУЗЧИК 2.377.06.00.00 (2)/ВЕДОМОСТЬ 2.377.06.00.00 РАЗГРУЗЧИК Лазер+Гибка.xlsx

№ п/п | Имя файла | Наименование | Материал | Толщина | Кол-во | Маршрут | ТИПОРАЗМЕР
1 | 2.377.06.04.05 | Спираль | AISI 304 | 2 | 1 | Навивка
2 | 2.377.06.01.21 | Уолок | 09Г2С ГОСТ 19281-2014 | 6 | 4 | Лазер+Гибка
3 | 2.377.06.01.15 | Кронштейн | AISI 304 | 4 | 1 | Лазер+Гибка+Сварка
4 | 2.377.06.01.14 | Пластина | AISI 304 | 4 | 1 | Лазер+Гибка
5 | 2.377.06.01.13 | Ребро | AISI 304 | 4 | 4 | Лазер
6 | 2.377.06.01.03 | Кронштейн | AISI 304 | 4 | 1 | Лазер+Гибка
7 | 2.377.06.01.12 | Профиль | AISI 304 | 4 | 2 | Лазер+Гибка
8 | 2.377.06.01.23 | Короб | AISI 304 | 2 | 2 | Лазер+Гибка
9 | 2.377.06.01.22 | Круг | AISI 304 | 4 | 2 | Лазер
10 | 2.377.06.01.24 | Профиль | AISI 304 | 4 | 1 | Лазер+Гибка
11 | 2.377.06.01.25 | Профиль | AISI 304 | 4 | 2 | Лазер+Гибка
12 | 2.377.06.01.26 | Косынка | AISI 304 | 2 | 2 | Лазер
13 | 2.377.06.01.27 | Фланец | AISI 304 | 4 | 1 | Лазер
14 | 2.377.06.01.08-01 | Профиль | AISI 304 | 2 | 2 | Лазер+Гибка
15 | 2.377.06.01.16 | Стенка | AISI 304 | 2 | 2 | Лазер
16 | 2.377.06.01.17 | Стенка | AISI 304 | 2 | 1 | Лазер
17 | 2.377.06.01.18 | Стенка | AISI 304 | 2 | 1 | Лазер
18 | 2.377.06.01.19 | Фланец | AISI 304 | 4 | 1 | Лазер
19 | 2.377.06.01.09 | Профиль | AISI 304 | 2 | 1 | Лазер+Гибка
20 | 2.377.06.01.11 | Кольцо | AISI 304 | 4 | 2 | Лазер
21 | 2.377.06.01.08 | Профиль | AISI 304 | 2 | 2 | Лазер+Гибка
22 | 2.377.06.01.07 | Фланец | AISI 304 | 4 | 1 | Лазер
23 | 2.377.06.01.05 | Стенка | AISI 304 | 2 | 1 | Лазер+Гибка
24 | 2.377.06.01.06 | Стенка | AISI 304 | 2 | 1 | Лазер+Гибка
25 | 2.377.05.03.05 | Фланец | AISI 304 | 4 | 3 | Лазер
26 | 2.377.05.03.06 | Кольцо | AISI 304 | 3 | 3 | Лазер
27 | 2.377.05.03.07 | Кольцо | AISI 304 | 3 | 3 | Лазер
28 | 2.377.05.03.09 | Фланец | AISI 304 | 4 | 3 | Лазер
29 | 2.377.05.04.02 | Фланец | AISI 304 | 4 | 1 | Лазер
30 | 2.377.06.01.02 | Фланец | AISI 304 | 4 | 2 | Лазер
31 | 2.377.06.01.04 | Стенка | AISI 304 | 2 | 2 | Лазер
32 | 2.377.06.07.01 | Крышка | AISI 304 | 4 | 1 | Лазер
33 | 2.377.06.00.08 | Связь | AISI 304 | 2 | 6 | Лазер+Гибка
34 | 2.377.06.03.02 | Заглушка | 09Г2С ГОСТ 19281-2014 | 6 | 3 | Лазер
35 | 2.377.06.03.03 | Пластина | 09Г2С ГОСТ 19281-2014 | 6 | 3 | Лазер
36 | 2.377.06.03.04 | Косынка | 09Г2С ГОСТ 19281-2014 | 6 | 9 | Лазер
37 | 2.377.06.03.05 | Ухо | 09Г2С ГОСТ 19281-2014 | 6 | 3 | Лазер
38 | 2.377.06.00.09 | Кронштейн | AISI 304 | 4 | 1 | Лазер+Гибка+Сварка
39 | 2.377.06.02.14 | Кронштейн | AISI 304 | 4 | 6 | Лазер+Гибка
40 | 2.377.06.02.15 | Кронштейн | AISI 304 | 2 | 1 | Лазер+Гибка
41 | 2.377.06.02.13 | Фланец | AISI 304 | 4 | 1 | Лазер
42 | 2.377.06.02.12 | Отвод | AISI 304 | 2 | 4 | Лазер+Гибка
43 | 2.377.06.02.11 | Корнштейн | AISI 304 | 4 | 1 | Лазер
44 | 2.377.06.02.07 | Обечайка | AISI 304 | 2 | 2 | Лазер+Вальцовка
45 | 2.377.06.02.08 | Обечайка | AISI 304 | 2 | 2 | Лазер+Вальцовка
46 | 2.377.06.02.06 | Фланец | AISI 304 | 4 | 1 | Лазер
47 | 2.377.06.02.02 | Профиль | AISI 304 | 2 | 1 | Лазер+Гибка
48 | 2.377.06.02.03 | Профиль | AISI 304 | 2 | 1 | Лазер+Гибка
49 | 2.377.06.02.04 | Крышка | AISI 304 | 2 | 1 | Лазер+Вальцовка
50 | 2.377.06.02.05 | Обечайка | AISI 304 | 2 | 1 | Лазер+Вальцовка
51 | 2.377.06.02.01 | Фланец | AISI 304 | 4 | 1 | Лазер
