Glebjack/NDM-VOS_powder_hopper/РАЗГРУЗЧИК 2.377.06.00.00 (2)/ВЕДОМОСТЬ 2.377.06.00.00 РАЗГРУЗЧИК.xlsx

№ п/п | Имя файла | Наименование | Материал | Толщина | Кол-во | Маршрут | ТИПОРАЗМЕР | Длина
1 | 2.377.06.00.01 | Вал | AISI 304 |  | 1 | Токарка+Фрезеровка | Круг 25мм h9 | L=180
2 | 2.377.06.00.02 | Втулка | AISI 304 |  | 1 | Токарка+Фрезеровка | Круг 40мм h9 | L=120
3 | 2.377.06.04.01 | Полуось | AISI 304 |  | 1 | Токарка+Фрезеровка | Круг 60мм | L=240
4 | 2.377.06.04.03 | Втулка | AISI 304 |  | 1 | Токарка+Фрезеровка | Круг 40мм h9 | L=50
5 | 2.377.06.04.04 | Полуось | AISI 304 |  | 1 | Токарка+Фрезеровка | Круг 60мм | L=320
6 | 2.377.06.05.02 | Втулка | AISI 304 |  | 1 | Токарка | Круг 40мм h9 | L=50
7 | 2.377.06.00.03 | Вал | AISI 304 |  | 1 | Токарка+Фрезеровка | Круг 25мм h9 | L=410
8 | 2.377.06.03.06 | Втулка | Ст3 ГОСТ 380-2005 |  | 12 | Токарка | Круг 30мм | L=100
9 | 2.377.05.03.04 | Труба | AISI 304 |  | 3 | Слесарка | Труба 51x2 | L=60
10 | 2.377.05.03.08 | Труба | AISI 304 |  | 3 | Слесарка | Труба 45x2 | L=50
11 | 2.377.06.01.01 | Труба | AISI 304 |  | 1 | Слесарка | Труба 204х2 | L=4000
12 | 2.377.06.02.09 | Труба | AISI 304 |  | 1 | Слесарка | Труба 204х2 | L=120
13 | 2.377.06.03.01 | Труба | Ст3 ГОСТ 380-2005 |  | 3 | Слесарка | Труба 80х80х4 | L=3200
14 | 2.377.06.04.02 | Труба | AISI 304 |  | 1 | Слесарка | Труба б/ш 57х3 | L=3950
15 | 2.377.06.05.01 | Труба | AISI 304 |  | 1 | Слесарка | Труба б/ш 30х2,5 | L=1600
16 | 2.377.06.05.03 | Штырь | AISI 304 |  | 1 | Слесарка | Круг 12мм 9 | L=400
17 | 2.377.06.05.04 | Штырь | AISI 304 |  | 1 | Слесарка | Круг 12мм 9 | L=210
18 | 2.377.06.04.05 | Спираль | AISI 304 | 2 | 1 | Навивка
19 | 2.377.06.01.21 | Уолок | 09Г2С ГОСТ 19281-2014 | 6 | 4 | Лазер+Гибка
20 | 2.377.06.01.15 | Кронштейн | AISI 304 | 4 | 1 | Лазер+Гибка+Сварка
21 | 2.377.06.01.14 | Пластина | AISI 304 | 4 | 1 | Лазер+Гибка
22 | 2.377.06.01.13 | Ребро | AISI 304 | 4 | 4 | Лазер
23 | 2.377.06.01.03 | Кронштейн | AISI 304 | 4 | 1 | Лазер+Гибка
24 | 2.377.06.01.12 | Профиль | AISI 304 | 4 | 2 | Лазер+Гибка
25 | 2.377.06.01.23 | Короб | AISI 304 | 2 | 2 | Лазер+Гибка
26 | 2.377.06.01.22 | Круг | AISI 304 | 4 | 2 | Лазер
27 | 2.377.06.01.24 | Профиль | AISI 304 | 4 | 1 | Лазер+Гибка
28 | 2.377.06.01.25 | Профиль | AISI 304 | 4 | 2 | Лазер+Гибка
29 | 2.377.06.01.26 | Косынка | AISI 304 | 2 | 2 | Лазер
30 | 2.377.06.01.27 | Фланец | AISI 304 | 4 | 1 | Лазер
31 | 2.377.06.01.08-01 | Профиль | AISI 304 | 2 | 2 | Лазер+Гибка
32 | 2.377.06.01.16 | Стенка | AISI 304 | 2 | 2 | Лазер
33 | 2.377.06.01.17 | Стенка | AISI 304 | 2 | 1 | Лазер
34 | 2.377.06.01.18 | Стенка | AISI 304 | 2 | 1 | Лазер
35 | 2.377.06.01.19 | Фланец | AISI 304 | 4 | 1 | Лазер
36 | 2.377.06.01.09 | Профиль | AISI 304 | 2 | 1 | Лазер+Гибка
37 | 2.377.06.01.11 | Кольцо | AISI 304 | 4 | 2 | Лазер
38 | 2.377.06.01.08 | Профиль | AISI 304 | 2 | 2 | Лазер+Гибка
39 | 2.377.06.01.07 | Фланец | AISI 304 | 4 | 1 | Лазер
40 | 2.377.06.01.05 | Стенка | AISI 304 | 2 | 1 | Лазер+Гибка
41 | 2.377.06.01.06 | Стенка | AISI 304 | 2 | 1 | Лазер+Гибка
42 | 2.377.05.03.05 | Фланец | AISI 304 | 4 | 3 | Лазер
43 | 2.377.05.03.06 | Кольцо | AISI 304 | 3 | 3 | Лазер
44 | 2.377.05.03.07 | Кольцо | AISI 304 | 3 | 3 | Лазер
45 | 2.377.05.03.09 | Фланец | AISI 304 | 4 | 3 | Лазер
46 | 2.377.05.04.02 | Фланец | AISI 304 | 4 | 1 | Лазер
47 | 2.377.06.01.02 | Фланец | AISI 304 | 4 | 2 | Лазер
48 | 2.377.06.01.04 | Стенка | AISI 304 | 2 | 2 | Лазер
49 | 2.377.06.07.01 | Крышка | AISI 304 | 4 | 1 | Лазер
50 | 2.377.06.00.08 | Связь | AISI 304 | 2 | 6 | Лазер+Гибка
51 | 2.377.06.03.02 | Заглушка | 09Г2С ГОСТ 19281-2014 | 6 | 3 | Лазер
52 | 2.377.06.03.03 | Пластина | 09Г2С ГОСТ 19281-2014 | 6 | 3 | Лазер
53 | 2.377.06.03.04 | Косынка | 09Г2С ГОСТ 19281-2014 | 6 | 9 | Лазер
54 | 2.377.06.03.05 | Ухо | 09Г2С ГОСТ 19281-2014 | 6 | 3 | Лазер
55 | 2.377.06.00.09 | Кронштейн | AISI 304 | 4 | 1 | Лазер+Гибка+Сварка
56 | 2.377.06.02.14 | Кронштейн | AISI 304 | 4 | 6 | Лазер+Гибка
57 | 2.377.06.02.15 | Кронштейн | AISI 304 | 2 | 1 | Лазер+Гибка
58 | 2.377.06.02.13 | Фланец | AISI 304 | 4 | 1 | Лазер
59 | 2.377.06.02.12 | Отвод | AISI 304 | 2 | 4 | Лазер+Гибка
60 | 2.377.06.02.11 | Корнштейн | AISI 304 | 4 | 1 | Лазер
61 | 2.377.06.02.07 | Обечайка | AISI 304 | 2 | 2 | Лазер+Вальцовка
62 | 2.377.06.02.08 | Обечайка | AISI 304 | 2 | 2 | Лазер+Вальцовка
63 | 2.377.06.02.06 | Фланец | AISI 304 | 4 | 1 | Лазер
64 | 2.377.06.02.02 | Профиль | AISI 304 | 2 | 1 | Лазер+Гибка
65 | 2.377.06.02.03 | Профиль | AISI 304 | 2 | 1 | Лазер+Гибка
66 | 2.377.06.02.04 | Крышка | AISI 304 | 2 | 1 | Лазер+Вальцовка
67 | 2.377.06.02.05 | Обечайка | AISI 304 | 2 | 1 | Лазер+Вальцовка
68 | 2.377.06.02.01 | Фланец | AISI 304 | 4 | 1 | Лазер
69 |  | Подшипниковый узел UCF205 |  |  | 2
70 |  | Болт М6х20 DIN 912 |  |  | 8
71 |  | Болт М6х40 DIN 933 |  |  | 9
72 |  | Болт М8х16 DIN 912 |  |  | 8
73 |  | Болт М8х20 DIN 933 |  |  | 6
74 |  | Болт М8х45 12.9 ОКС DIN 912 |  |  | 2
75 |  | Болт М10х20 DIN 933 |  |  | 6
76 |  | Болт М10х25 DIN 933 |  |  | 39
77 |  | Болт М10х30 DIN 933 |  |  | 9
78 |  | Болт М10х35 DIN 933 |  |  | 8
79 |  | Болт М10х45 DIN 912 12.9 ОКС |  |  | 2
80 |  | Болт М12х25 DIN 933 |  |  | 1
81 |  | Болт М12х30 DIN 933 |  |  | 1
82 |  | Болт М12х110 DIN 912 12.9 ОКС |  |  | 12
83 |  | Болт М16х35 DIN 933 |  |  | 1
84 |  | Болт М16х35 DIN 933 НЕРЖ |  |  | 4
85 |  | Болт М16х160 DIN 933 |  |  | 2
86 |  | Винт М6х16 DIN7991 |  |  | 2
87 |  | Гайка М6 DIN 934 |  |  | 18
88 |  | Гайка М6 DIN985 |  |  | 8
89 |  | Гайка М8 DIN 934 НЕРЖ |  |  | 6
90 |  | Гайка М8 DIN985 |  |  | 2
91 |  | Гайка М10 DIN 934 |  |  | 35
92 |  | Гайка М10 DIN 934 НЕРЖ |  |  | 6
93 |  | Гайка М10 DIN985 |  |  | 23
94 |  | Гайка М12 DIN985 |  |  | 12
95 |  | Гайка М16 DIN 934 |  |  | 20
96 |  | Мотор-редуктор NMRV050 |  |  | 2
97 |  | Стоп. кольцо 25 DIN 471 |  |  | 2
98 |  | Шайба 10 DIN125 |  |  | 26
99 |  | Шайба гр. М6 DIN127 |  |  | 8
100 |  | Шайба гр. М8 DIN127 |  |  | 14
101 |  | Шайба гр. М10 DIN127 |  |  | 62
102 |  | Шайба гр. М12 DIN127 |  |  | 14
103 |  | Шайба гр. М16 DIN127 |  |  | 13
104 |  | Шайба кузовная 8 DIN9021 |  |  | 6
105 |  | Шайба кузовная 12 DIN9021 |  |  | 2
106 |  | Шпонка 8х7х20 DIN 6885 |  |  | 4
107 |  | Штанга М16х400 DIN975 |  |  | 2
