Glebjack/NDM-VOS_powder_hopper/3d party/motovario-nmrv_075-1.snapshot.1/NMRV-075/MNRV-075.SLDASM

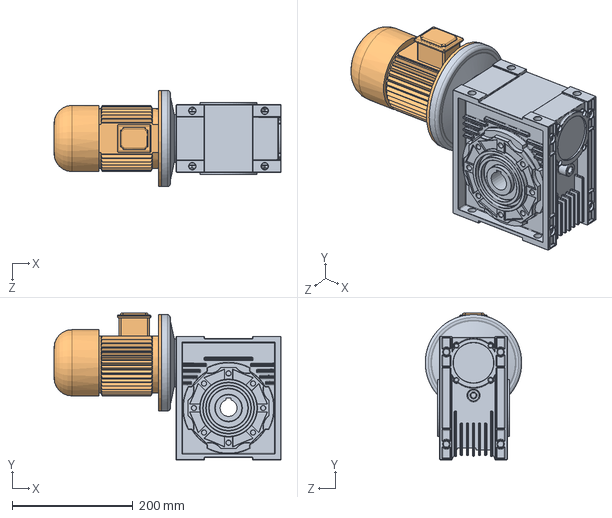
[picture p31: CAD file, 2024-12-05]
3d party/motovario-nmrv_075-1.snapshot.1/NMRV-075/MNRV-075.SLDASM
376.5 x 243.4 x 160.0 mm
NMRV075
Двигатель на NMRV-075
