Glebjack/NDM-VOS_powder_hopper/фрезер/mm=10_ NVPH-305 main flange__x2.dxf

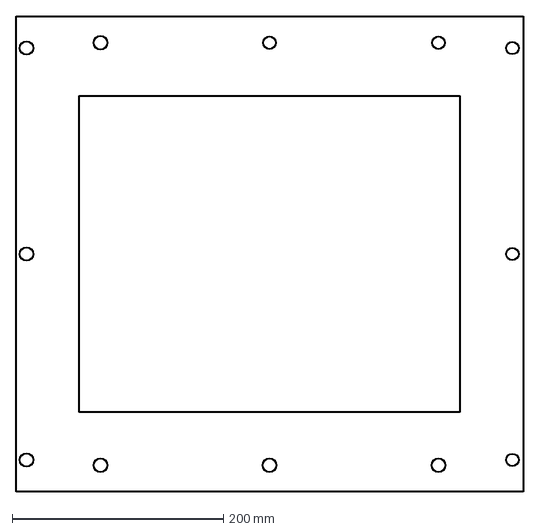
[picture p32: CAD file, 2025-01-17]
фрезер/mm=10_ NVPH-305 main flange__x2.dxf
480.0 x 450.0 mm
