Glebjack/NDM-VOS_powder_hopper/РАЗГРУЗЧИК 2.377.06.00.00 (2)/2.377.06.01.40_Проставка.SLDASM

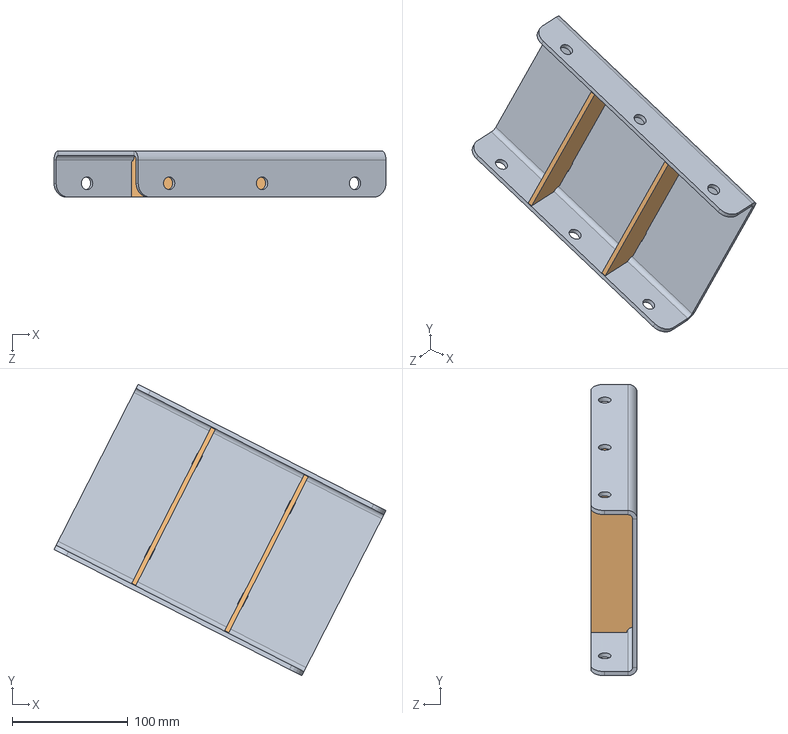
[picture p33: CAD file, 2024-10-05]
РАЗГРУЗЧИК 2.377.06.00.00 (2)/2.377.06.01.40_Проставка.SLDASM
286.5 x 251.5 x 40.0 mm
2.377.06.01.12_Профиль
2.377.06.01.13_Ребро x 2
