Glebjack/NDM-VOS_powder_hopper/РАЗГРУЗЧИК 2.377.06.00.00 (2)/ВСПФ/Собираемость ШН+ЕМК ЗАГР.SLDASM

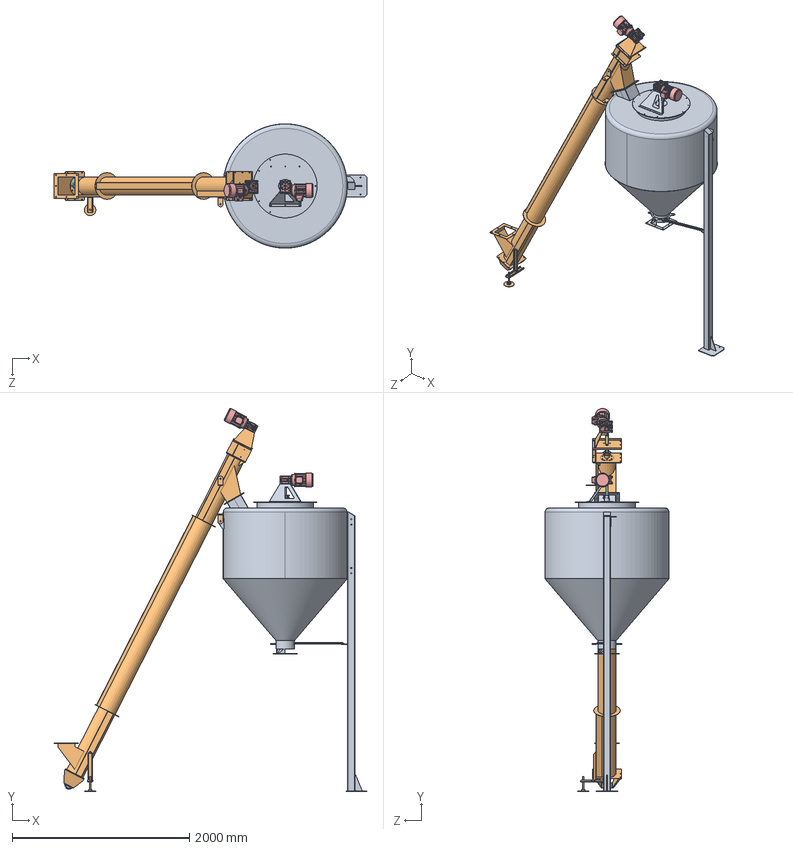
[picture p34: CAD file, 2024-10-05]
РАЗГРУЗЧИК 2.377.06.00.00 (2)/ВСПФ/Собираемость ШН+ЕМК ЗАГР.SLDASM
3530.0 x 4325.5 x 1403.0 mm
Емкость Разгр СВД
Шнек Шнек РАЗГ СВД
UCF205
Спираль РАЗГ СВД
Редуктор x 2
2.377.06.00.01_Вал
2.377.06.00.02_Втулка
2.377.06.00.03_Вал
Сальник ДЕТ
2.377.06.00.04_Труба
2.377.06.00.05_Втулка
2.377.06.00.06_Штырь
2.377.06.00.07_Штырь
Винт М6х16 DIN7991
