Glebjack/NDM-VOS_powder_hopper/РАЗГРУЗЧИК 2.377.06.00.00 (2)/2.377.06.01.00_Транспортер.SLDASM

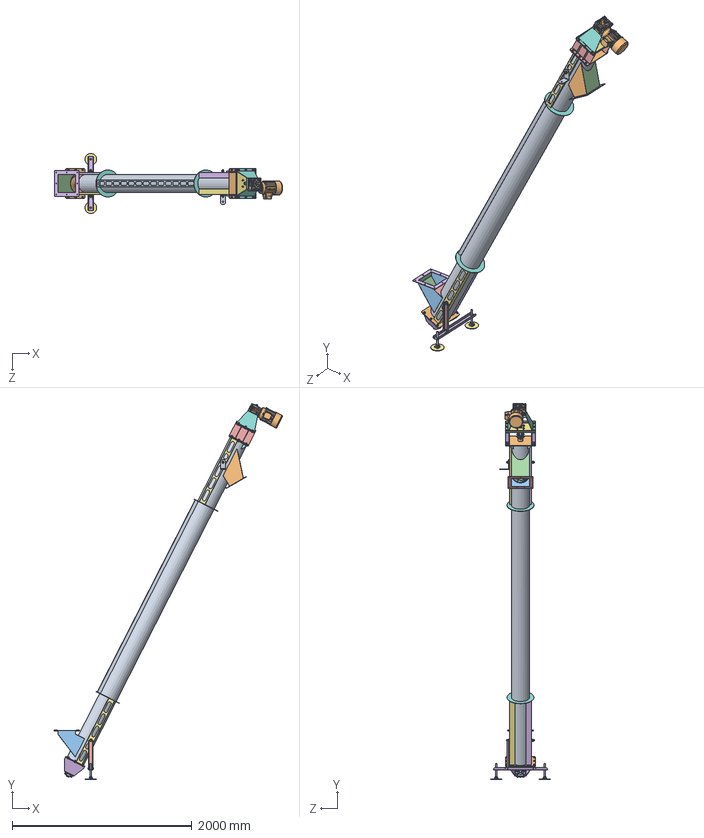
[picture p36: CAD file, 2024-10-05]
РАЗГРУЗЧИК 2.377.06.00.00 (2)/2.377.06.01.00_Транспортер.SLDASM
2541.1 x 4187.2 x 670.0 mm
2.377.06.01.01_Труба
2.377.06.01.02_Фланец x 2
2.377.06.01.04_Стенка x 2
2.377.06.01.05_Стенка
2.377.06.01.06_Стенка
2.377.06.01.07_Фланец
2.377.06.01.08_Профиль x 2
2.377.06.01.11_Кольцо x 2
2.377.06.01.09_Профиль
2.377.06.01.16_Стенка x 2
2.377.06.01.17_Стенка
2.377.06.01.18_Стенка
2.377.06.01.19_Фланец
2.377.06.01.08-01_Профиль x 2
Болт М16х35 DIN 933 НЕРЖ x 4
2.377.06.01.26_Косынка x 2
2.377.06.01.27_Фланец
2.377.05.03.04_Труба x 2
2.377.05.03.05_Фланец x 2
2.377.05.03.06_Кольцо x 2
2.377.06.01.25_Профиль x 2
2.377.06.01.24_Профиль
2.377.06.01.22_Круг x 2
2.377.06.01.23_Короб x 2
Болт М16х160 DIN 933 x 2
Гайка М16 DIN 934 x 10
2.377.05.03.07_Кольцо x 2
2.377.05.03.08_Труба x 2
2.377.05.03.09_Фланец x 2
2.377.06.01.03_Кронштейн
2.377.06.04.01_Полуось
2.377.06.04.02_Труба
2.377.06.04.04_Полуось
2.377.06.04.05_Спираль
2.377.06.04.03_Втулка
UCF205 x 2
2.377.06.01.12_Профиль x 2
2.377.06.01.13_Ребро x 4
2.377.06.01.14_Пластина
2.377.06.01.15_Кронштейн
2.377.06.00.01_Вал
2.377.06.00.02_Втулка
Винт М6х16 DIN7991 x 2
Шайба гр. М10 DIN127 x 26
Гайка М10 DIN 934 x 26
Шайба 10 DIN125 x 8
Болт М10х35 DIN 933 x 8
Болт М6х40 DIN 933 x 6
Гайка М6 DIN 934 x 12
Болт М10х20 DIN 933 x 6
Шайба гр. М6 DIN127 x 8
Гайка М6 DIN985 x 8
Болт М6х20 DIN 912 x 8
Шайба гр. М16 DIN127 x 4
Болт М10х25 DIN 933 x 12
Болт М8х45 12.9 ОКС DIN 912 x 2
Гайка М8 DIN985 x 2
Шайба гр. М8 DIN127 x 4
Болт М8х16 DIN 912 x 4
Стоп. кольцо 25 DIN 471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
