Glebjack/NDM-VOS_powder_hopper/РАЗГРУЗЧИК 2.377.06.00.00 (2)/2.377.06.02.00_Емкость.SLDASM

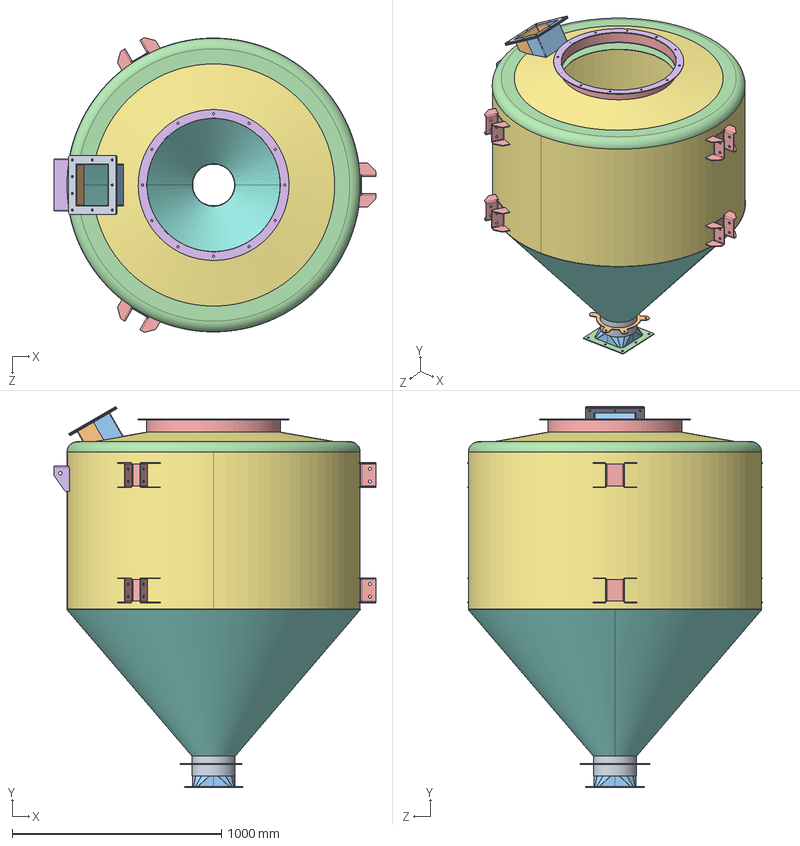
[picture p37: CAD file, 2024-10-05]
РАЗГРУЗЧИК 2.377.06.00.00 (2)/2.377.06.02.00_Емкость.SLDASM
1536.7 x 1819.0 x 1406.3 mm
2.377.06.02.05_Обечайка
2.377.06.02.06_Фланец
2.377.06.02.07_Обечайка x 2
2.377.06.02.08_Обечайка x 2
2.377.06.02.09_Труба
2.377.06.02.11_Корнштейн
2.377.06.02.12_Отвод x 4
2.377.06.02.13_Фланец
2.377.06.02.14_Кронштейн x 6
2.377.06.02.15_Кронштейн
2.377.06.02.04-1_Крышка
2.377.06.02.01_Фланец
2.377.06.02.03_Профиль
2.377.06.02.02_Профиль
