Glebjack/NDM-VOS_powder_hopper/РАЗГРУЗЧИК 2.377.06.00.00 (2)/2.377.06.07.00_Крышка.SLDASM

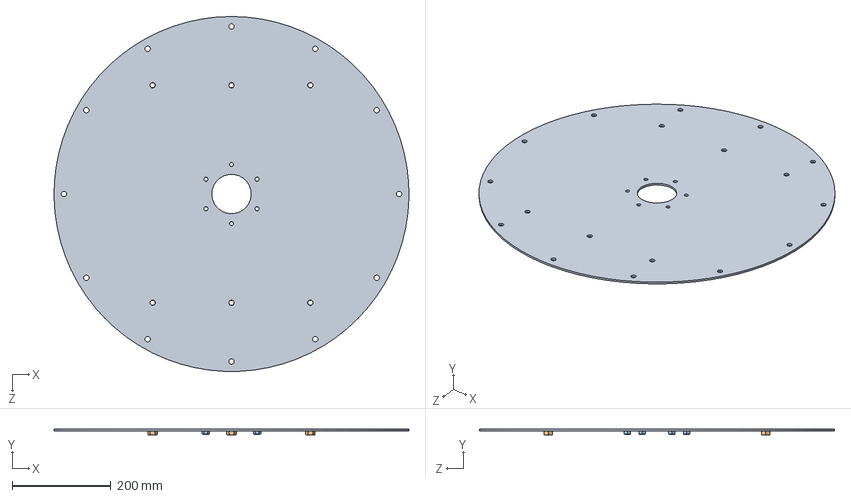
[picture p38: CAD file, 2024-10-05]
РАЗГРУЗЧИК 2.377.06.00.00 (2)/2.377.06.07.00_Крышка.SLDASM
719.8 x 12.4 x 720.0 mm
2.377.06.07.01_Крышка
Гайка М10 DIN 934 НЕРЖ x 6
Гайка М8 DIN 934 НЕРЖ x 6
