Glebjack/NDM-VOS_powder_hopper/РАЗГРУЗЧИК 2.377.06.00.00 (2)/2.377.06.01.30_Фланец.SLDASM

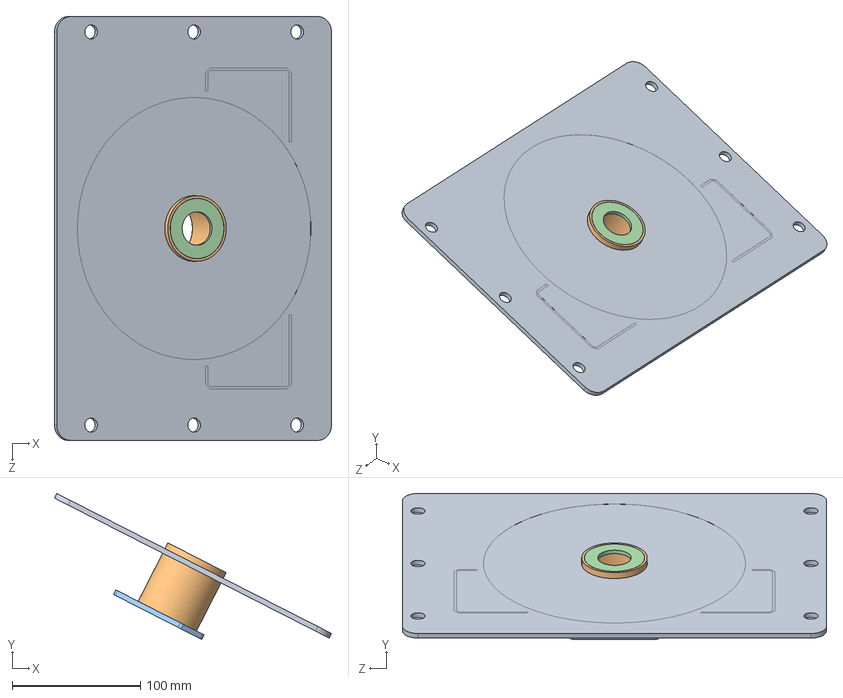
[picture p39: CAD file, 2024-10-05]
РАЗГРУЗЧИК 2.377.06.00.00 (2)/2.377.06.01.30_Фланец.SLDASM
215.7 x 113.6 x 330.0 mm
2.377.06.01.02_Фланец
2.377.05.03.04_Труба
2.377.05.03.05_Фланец
2.377.05.03.06_Кольцо
