Glebjack/NDM-VOS_powder_hopper/РАЗГРУЗЧИК 2.377.06.00.00 (2)/2.377.06.05.00_Рыхлитель.SLDASM

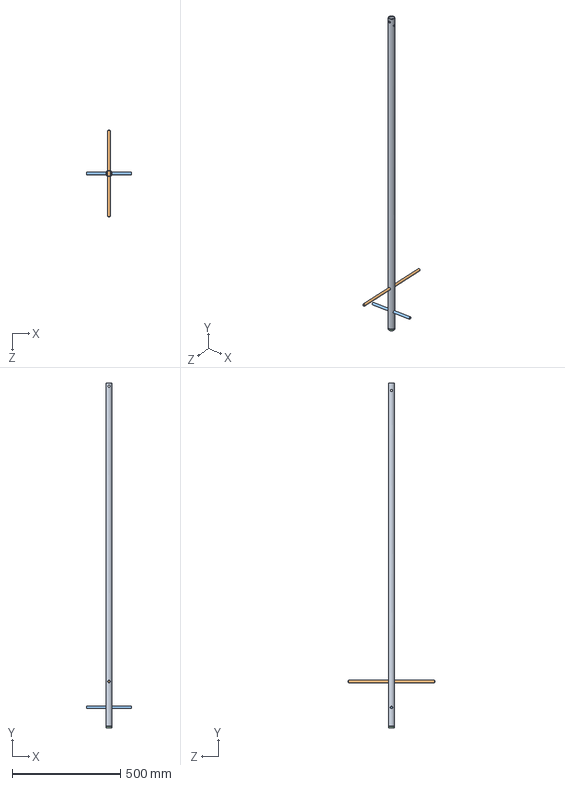
[picture p40: CAD file, 2024-10-05]
РАЗГРУЗЧИК 2.377.06.00.00 (2)/2.377.06.05.00_Рыхлитель.SLDASM
210.0 x 1595.0 x 400.0 mm
2.377.06.05.01_Труба
2.377.06.05.03_Штырь
2.377.06.05.04_Штырь
2.377.06.05.02_Втулка
