Glebjack/NDM-VOS_powder_hopper/РАЗГРУЗЧИК 2.377.06.00.00 (2)/2.377.06.01.20_Опора.SLDASM

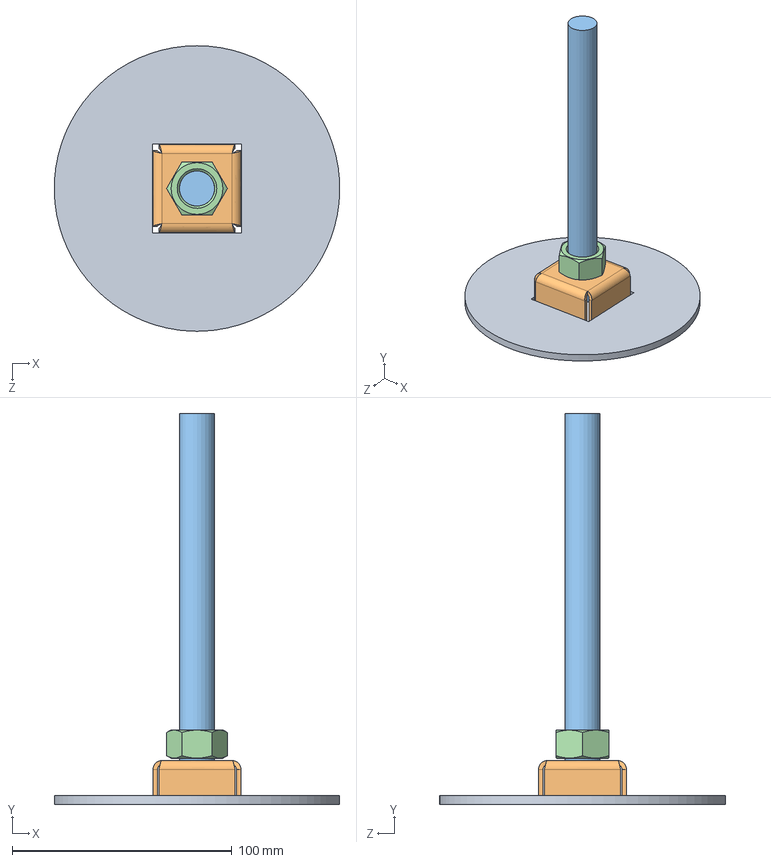
[picture p41: CAD file, 2024-10-05]
РАЗГРУЗЧИК 2.377.06.00.00 (2)/2.377.06.01.20_Опора.SLDASM
130.0 x 178.0 x 130.0 mm
2.377.06.01.22_Круг
2.377.06.01.23_Короб
Болт М16х160 DIN 933
Гайка М16 DIN 934
