Glebjack/NDM-VOS_powder_hopper/РАЗГРУЗЧИК 2.377.06.00.00 (2)/2.377.06.04.00_Шнек.SLDASM

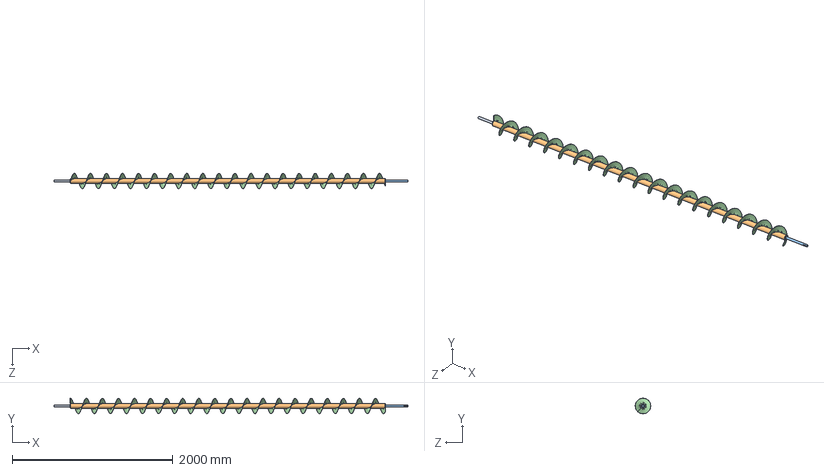
[picture p42: CAD file, 2024-10-05]
РАЗГРУЗЧИК 2.377.06.00.00 (2)/2.377.06.04.00_Шнек.SLDASM
4408.0 x 194.0 x 194.0 mm
2.377.06.04.01_Полуось
2.377.06.04.02_Труба
2.377.06.04.04_Полуось
2.377.06.04.05_Спираль
