Glebjack/NDM-VOS_powder_hopper/РАЗГРУЗЧИК 2.377.06.00.00 (2)/2.377.06.00.10_Бункер.SLDASM

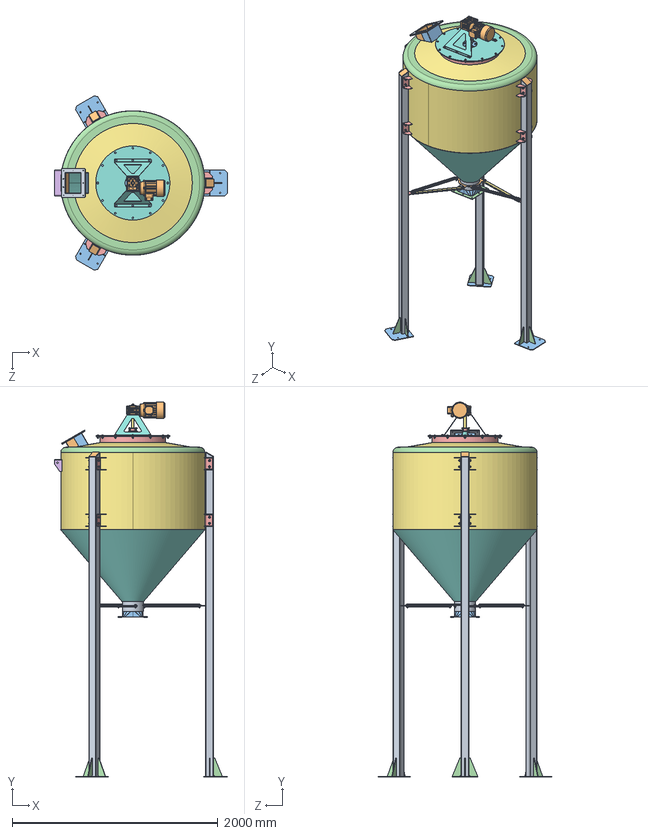
[picture p43: CAD file, 2024-10-05]
РАЗГРУЗЧИК 2.377.06.00.00 (2)/2.377.06.00.10_Бункер.SLDASM
1682.7 x 3643.7 x 1695.2 mm
2.377.06.02.05_Обечайка
2.377.06.02.06_Фланец
2.377.06.02.07_Обечайка x 2
2.377.06.02.08_Обечайка x 2
2.377.06.02.09_Труба
2.377.06.02.11_Корнштейн
2.377.06.02.12_Отвод x 4
2.377.06.02.13_Фланец
2.377.06.02.14_Кронштейн x 6
2.377.06.02.15_Кронштейн
2.377.06.02.04-1_Крышка
2.377.06.02.01_Фланец
2.377.06.02.03_Профиль
2.377.06.02.02_Профиль
2.377.06.00.09_Кронштейн
2.377.06.03.01_Труба x 3
2.377.06.03.02_Заглушка x 3
2.377.06.03.03_Пластина x 3
2.377.06.03.04_Косынка x 9
2.377.06.03.05_Ухо x 3
2.377.06.03.06_Втулка x 12
2.377.06.00.08_Связь x 6
2.377.05.03.04_Труба
2.377.05.03.05_Фланец
2.377.05.03.06_Кольцо
2.377.05.04.02_Фланец
2.377.05.03.07_Кольцо
2.377.05.03.08_Труба
2.377.05.03.09_Фланец
2.377.06.00.03_Вал
2.377.06.05.01_Труба
2.377.06.05.03_Штырь
2.377.06.05.04_Штырь
2.377.06.05.02_Втулка
Шпонка 8х7х20 DIN 6885 x 2
Стоп. кольцо 25 DIN 471
Болт М10х45 DIN 912 12.9 ОКС x 2
Гайка М10 DIN985 x 23
Шайба кузовная 12 DIN9021
Шайба гр. М12 DIN127 x 13
Болт М12х25 DIN 933
Шайба гр. М8 DIN127 x 10
Болт М8х16 DIN 912 x 4
Болт М6х40 DIN 933 x 3
Гайка М6 DIN 934 x 6
Шайба гр. М10 DIN127 x 27
2.377.06.07.01_Крышка
Гайка М10 DIN 934 НЕРЖ x 6
Гайка М8 DIN 934 НЕРЖ x 6
Болт М10х25 DIN 933 x 18
Шайба кузовная 8 DIN9021 x 6
Болт М8х20 DIN 933 x 6
Болт М12х110 DIN 912 12.9 ОКС x 12
Гайка М12 DIN985 x 12
Шайба 10 DIN125 x 18
Болт М10х30 DIN 933 x 9
Мотор-редуктор NMRV050
