Glebjack/NDM-VOS_powder_hopper/РАЗГРУЗЧИК 2.377.06.00.00 (2)/2.377.06.03.00_Стойка.SLDASM

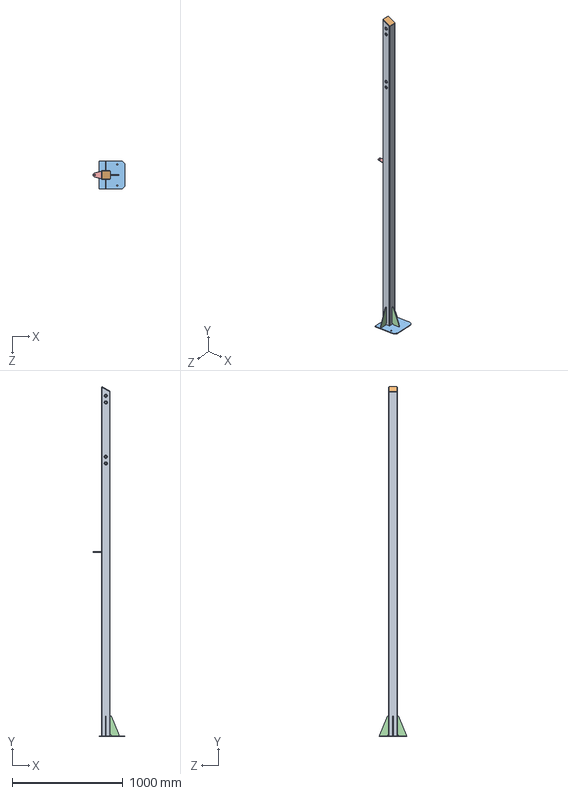
[picture p44: CAD file, 2024-10-05]
РАЗГРУЗЧИК 2.377.06.00.00 (2)/2.377.06.03.00_Стойка.SLDASM
292.5 x 3158.5 x 250.0 mm
2.377.06.03.01_Труба
2.377.06.03.02_Заглушка
2.377.06.03.03_Пластина
2.377.06.03.04_Косынка x 3
2.377.06.03.05_Ухо
2.377.06.03.06_Втулка x 4
