Glebjack/NDM-VOS_powder_hopper/РАЗГРУЗЧИК 2.377.06.00.00 (2)/2.377.06.01.10_Корпус.SLDASM

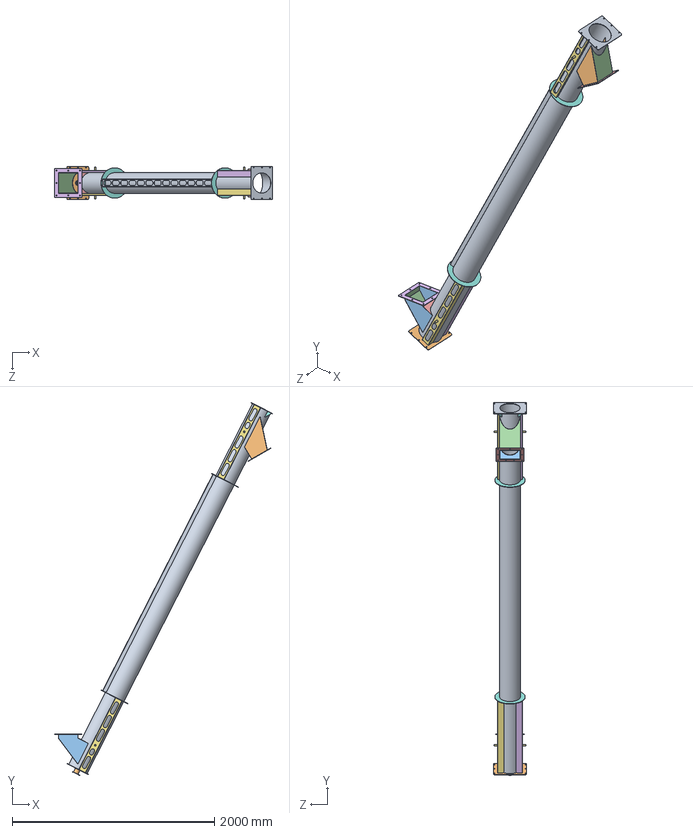
[picture p45: CAD file, 2024-10-05]
РАЗГРУЗЧИК 2.377.06.00.00 (2)/2.377.06.01.10_Корпус.SLDASM
2158.0 x 3687.0 x 330.0 mm
2.377.06.01.01_Труба
2.377.06.01.02_Фланец
2.377.06.01.04_Стенка x 2
2.377.06.01.05_Стенка
2.377.06.01.06_Стенка
2.377.06.01.07_Фланец
2.377.06.01.08_Профиль x 2
2.377.06.01.11_Кольцо x 2
2.377.06.01.09_Профиль
2.377.06.01.16_Стенка x 2
2.377.06.01.17_Стенка
2.377.06.01.18_Стенка
2.377.06.01.19_Фланец
2.377.06.01.08-01_Профиль x 2
Болт М16х35 DIN 933 НЕРЖ x 4
2.377.06.01.26_Косынка x 2
2.377.06.01.27_Фланец
2.377.05.03.04_Труба
2.377.05.03.05_Фланец
2.377.05.03.06_Кольцо
