Glebjack/NDM-VOS_powder_hopper/3d party/motovario-nmrv_075-1.snapshot.1/NMRV-075/NMRV-075.SLDPRT

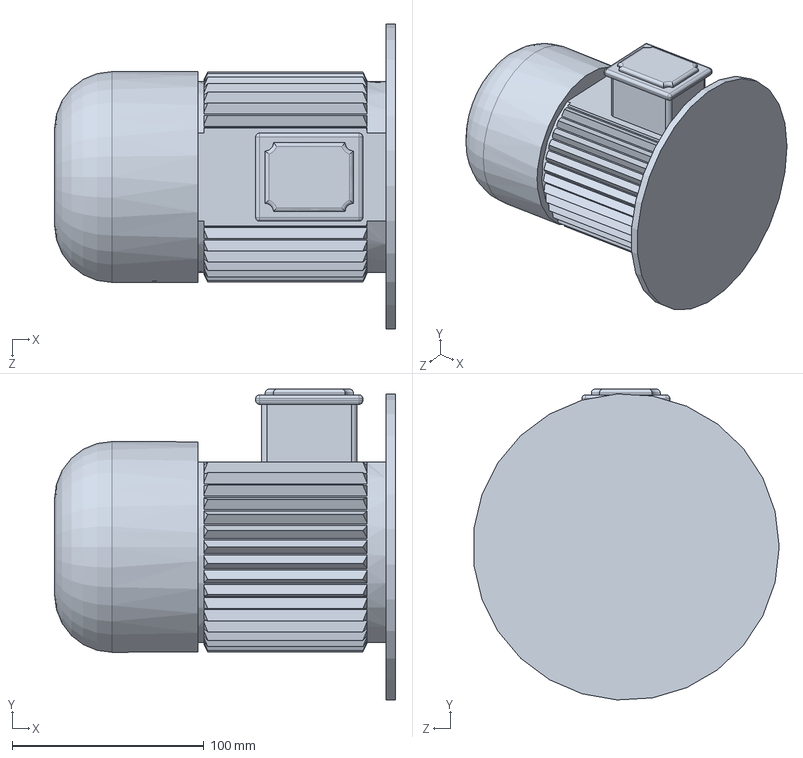
[picture p46: CAD file, 2024-12-05]
3d party/motovario-nmrv_075-1.snapshot.1/NMRV-075/NMRV-075.SLDPRT
178.0 x 162.3 x 159.5 mm
