Glebjack/NDM-VOS_powder_hopper/3d party/PCRV071-063SHFA_MS71B5.stp

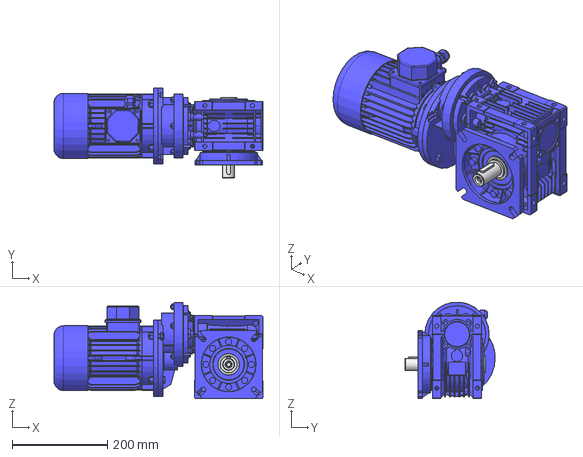
[picture p47: CAD file, 2025-01-16]
3d party/PCRV071-063SHFA_MS71B5.stp
438.0 x 189.5 x 202.1 mm
