Glebjack/NDM-VOS_powder_hopper/AQUA 3mm MSC 815 wall inner joint _x10.dxf

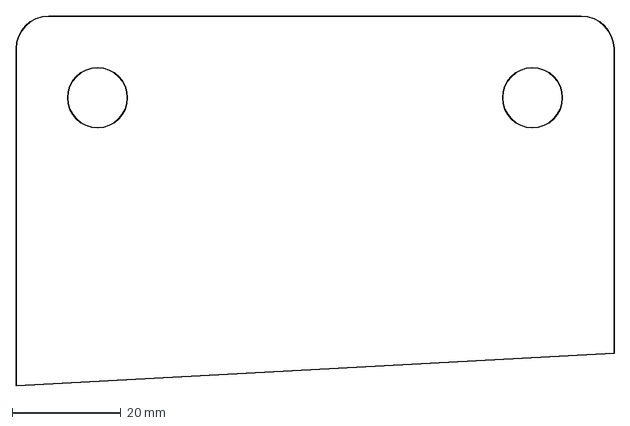
[picture p48: CAD file, 2025-01-14]
AQUA 3mm MSC 815 wall inner joint _x10.dxf
110.0 x 68.0 mm
