Glebjack/NDM-VOS_powder_hopper/LASER/Stainless Steel/3/mat-Stainless Steel_mm=3_ NDM-VOS 778 engine plate__x3.dxf

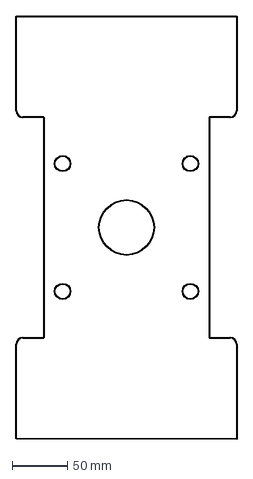
[picture p49: CAD file, 2025-01-17]
LASER/Stainless Steel/3/mat-Stainless Steel_mm=3_ NDM-VOS 778 engine plate__x3.dxf
200.0 x 383.9 mm
