Glebjack/NDM-VOS_powder_hopper/LASER/Steel/10/mat-Steel_mm=10_ NVPH-202 shredder cutter blade__x24.dxf

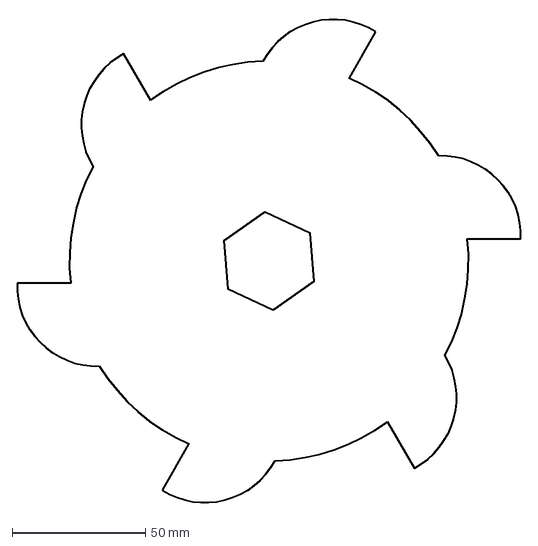
[picture p50: CAD file, 2025-01-17]
LASER/Steel/10/mat-Steel_mm=10_ NVPH-202 shredder cutter blade__x24.dxf
189.9 x 183.7 mm
