Glebjack/NDM-VOS_powder_hopper/LASER/Steel/5/mat-Steel_mm=5_ NDM-VOS 112 sredder wall 2__x6.dxf

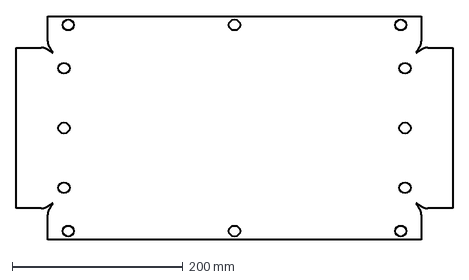
[picture p51: CAD file, 2025-01-17]
LASER/Steel/5/mat-Steel_mm=5_ NDM-VOS 112 sredder wall 2__x6.dxf
511.8 x 261.8 mm
