Glebjack/NDM-VOS_powder_hopper/РАЗГРУЗЧИК 2.377.06.00.00 (2)/2.377.06.00.02_Втулка.SLDPRT

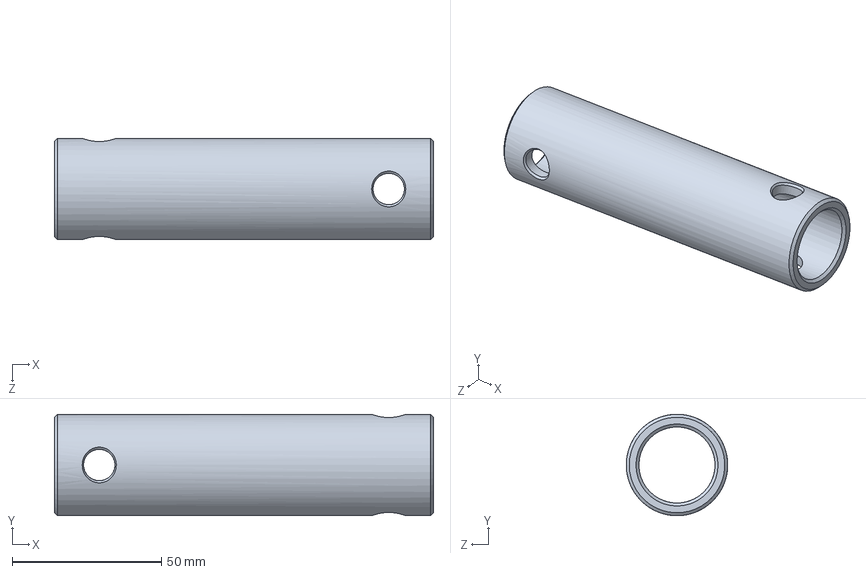
[picture p52: CAD file, 2024-10-05]
РАЗГРУЗЧИК 2.377.06.00.00 (2)/2.377.06.00.02_Втулка.SLDPRT
127.0 x 34.0 x 34.0 mm
