Glebjack/NDM-VOS_powder_hopper/РАЗГРУЗЧИК 2.377.06.00.00 (2)/ВСПФ/Сальник ДЕТ.SLDPRT

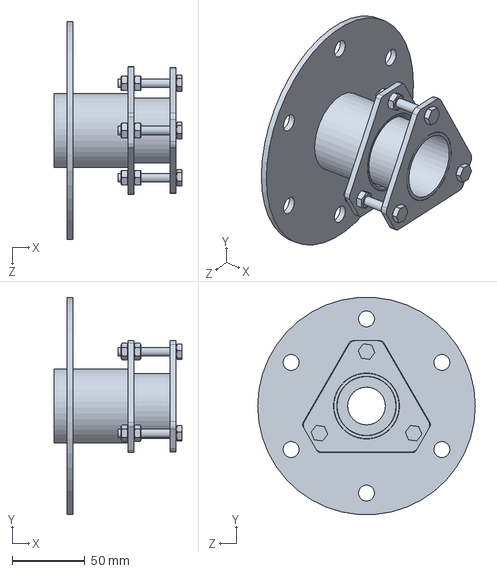
[picture p53: CAD file, 2024-10-05]
РАЗГРУЗЧИК 2.377.06.00.00 (2)/ВСПФ/Сальник ДЕТ.SLDPRT
88.0 x 149.6 x 150.0 mm
