Glebjack/NDM-VOS_powder_hopper/РАЗГРУЗЧИК 2.377.06.00.00 (2)/РАЗГРУЗЧИК DXF/2.377.06.01.15_Кронштейн.DXF

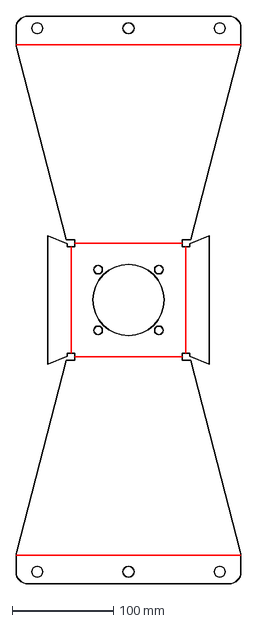
[picture p54: CAD file, 2024-10-05]
РАЗГРУЗЧИК 2.377.06.00.00 (2)/РАЗГРУЗЧИК DXF/2.377.06.01.15_Кронштейн.DXF
222.0 x 560.4 mm
