Glebjack/NDM-VOS_powder_hopper/фрезер/mm=10_ NVPH-345 feeder hose 2__x2.dxf

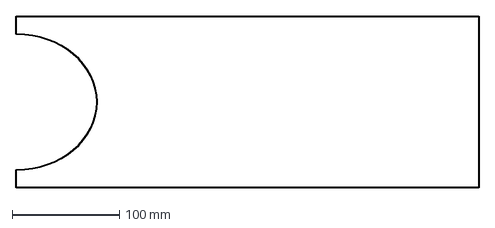
[picture p55: CAD file, 2025-01-17]
фрезер/mm=10_ NVPH-345 feeder hose 2__x2.dxf
430.0 x 160.0 mm
