Glebjack/NDM-VOS_powder_hopper/3d party/PCRV080-075SHFA_MS80B5.stp

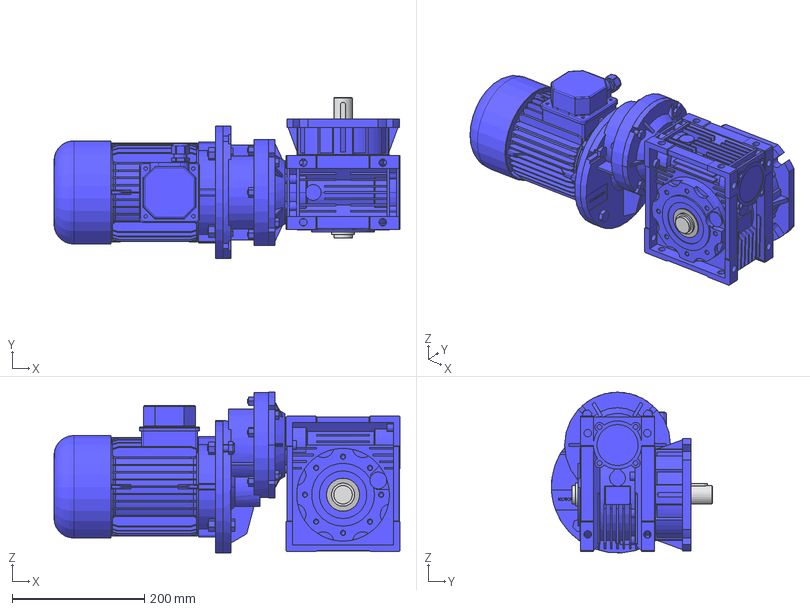
[picture p56: CAD file, 2024-12-20]
3d party/PCRV080-075SHFA_MS80B5.stp
522.5 x 243.4 x 242.9 mm
