Glebjack/NDM-VOS_powder_hopper/AQUA 3mm NVPH-413 revision steel circle _x6.dxf

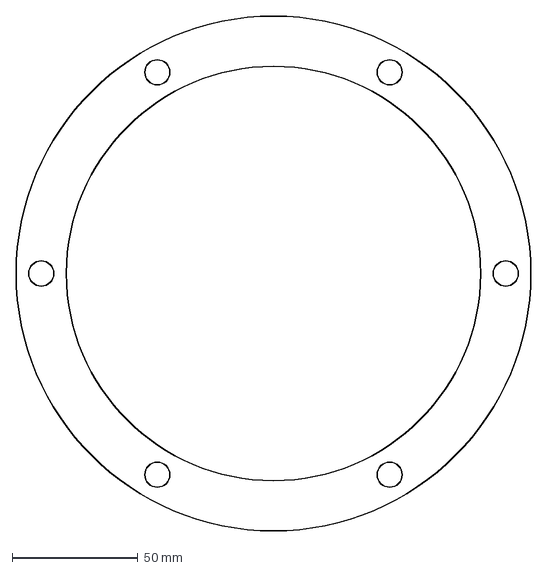
[picture p57: CAD file, 2025-01-14]
AQUA 3mm NVPH-413 revision steel circle _x6.dxf
205.0 x 205.0 mm
