Glebjack/NDM-VOS_powder_hopper/LASER/Stainless Steel/3/mat-Stainless Steel_mm=3_ MSC 115 CONE IN BOW__x6.dxf

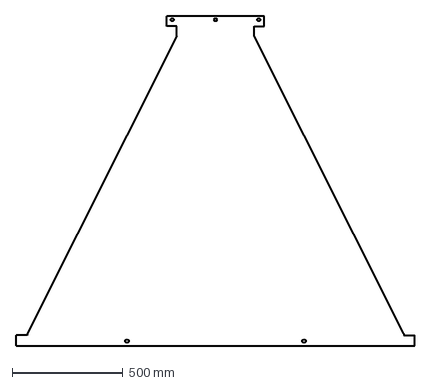
[picture p58: CAD file, 2025-01-17]
LASER/Stainless Steel/3/mat-Stainless Steel_mm=3_ MSC 115 CONE IN BOW__x6.dxf
1800.0 x 1486.7 mm
