Glebjack/NDM-VOS_powder_hopper/LASER/Steel/10/mat-Steel_mm=10_ NVPH-203 shredder cutter blade 3__x24.dxf

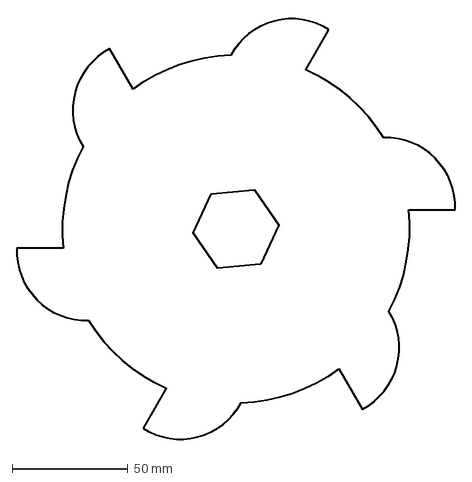
[picture p59: CAD file, 2025-01-17]
LASER/Steel/10/mat-Steel_mm=10_ NVPH-203 shredder cutter blade 3__x24.dxf
189.9 x 183.7 mm
