Glebjack/NDM-VOS_powder_hopper/LASER/Steel/5/mat-Steel_mm=5_ NDM-VOS 116 engine plate__x6.dxf

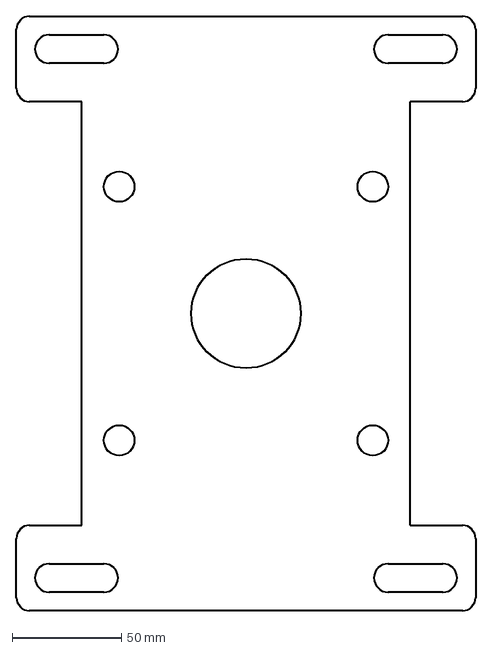
[picture p60: CAD file, 2025-01-17]
LASER/Steel/5/mat-Steel_mm=5_ NDM-VOS 116 engine plate__x6.dxf
210.0 x 271.8 mm
