Glebjack/NDM-VOS_powder_hopper/РАЗГРУЗЧИК 2.377.06.00.00 (2)/2.377.06.00.08_Связь.SLDPRT

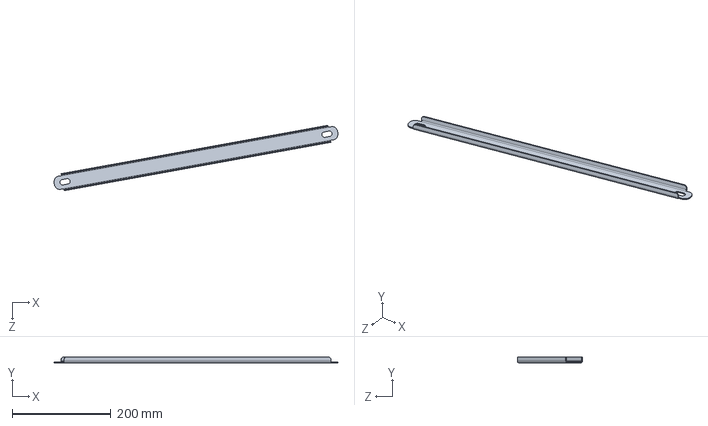
[picture p61: CAD file, 2024-10-05]
РАЗГРУЗЧИК 2.377.06.00.00 (2)/2.377.06.00.08_Связь.SLDPRT
575.9 x 12.0 x 132.6 mm
