Glebjack/NDM-VOS_powder_hopper/РАЗГРУЗЧИК 2.377.06.00.00 (2)/ВСПФ/Мотор-редуктор NMRV050.SLDPRT

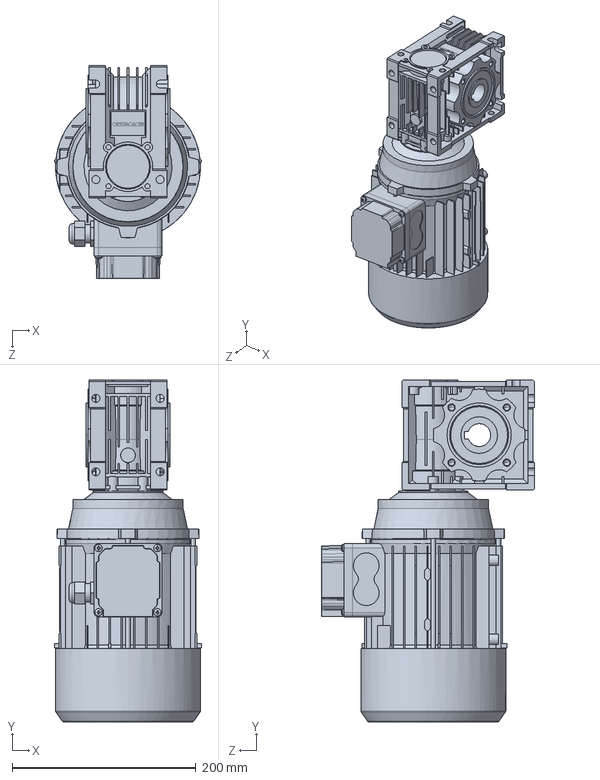
[picture p62: CAD file, 2024-10-05]
РАЗГРУЗЧИК 2.377.06.00.00 (2)/ВСПФ/Мотор-редуктор NMRV050.SLDPRT
160.3 x 372.5 x 231.5 mm
