Glebjack/NDM-VOS_powder_hopper/РАЗГРУЗЧИК 2.377.06.00.00 (2)/РАЗГРУЗЧИК DXF/2.377.06.02.05_Обечайка.DXF

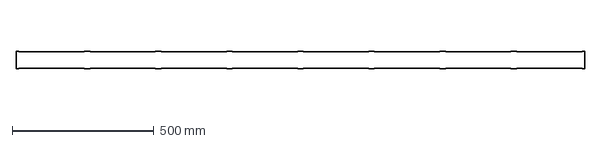
[picture p63: CAD file, 2024-10-05]
РАЗГРУЗЧИК 2.377.06.00.00 (2)/РАЗГРУЗЧИК DXF/2.377.06.02.05_Обечайка.DXF
2003.8 x 62.0 mm
