Glebjack/NDM-VOS_powder_hopper/фрезер/mm=10_  NVPH-322 joint HDPE ring__x4.dxf

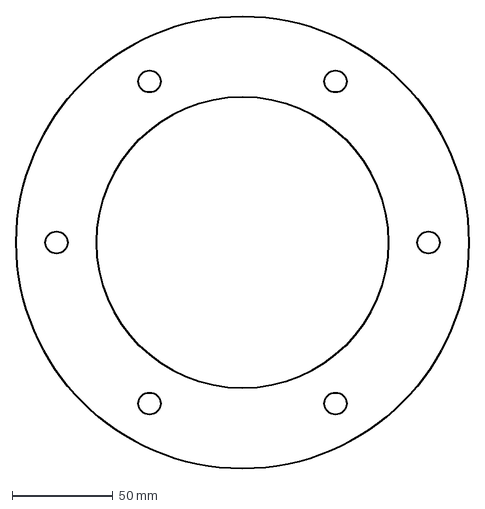
[picture p64: CAD file, 2025-01-17]
фрезер/mm=10_ NVPH-322 joint HDPE ring__x4.dxf
225.0 x 225.0 mm
