Glebjack/NDM-VOS_powder_hopper/AQUA 3mm MSC 923 step  _x.dxf

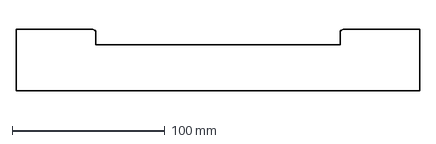
[picture p65: CAD file, 2025-01-14]
AQUA 3mm MSC 923 step _x.dxf
263.9 x 40.0 mm
