Glebjack/NDM-VOS_powder_hopper/LASER/Stainless Steel/3/mat-Stainless Steel_mm=3_ MSC 206 GRID_CPY__x6.dxf

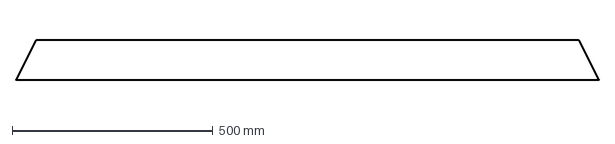
[picture p66: CAD file, 2025-01-17]
LASER/Stainless Steel/3/mat-Stainless Steel_mm=3_ MSC 206 GRID_CPY__x6.dxf
1450.7 x 100.0 mm
