Glebjack/NDM-VOS_powder_hopper/LASER/Steel/5/mat-Steel_mm=5_ NDM-VOS 111 sredder wall 1__x6.dxf

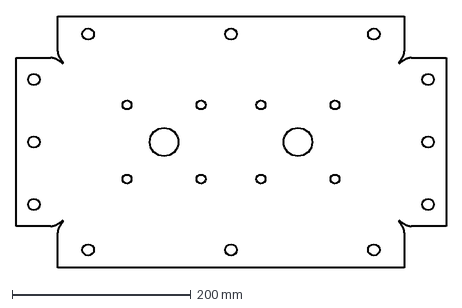
[picture p67: CAD file, 2025-01-17]
LASER/Steel/5/mat-Steel_mm=5_ NDM-VOS 111 sredder wall 1__x6.dxf
481.8 x 281.8 mm
