Glebjack/NDM-VOS_powder_hopper/РАЗГРУЗЧИК 2.377.06.00.00 (2)/2.377.06.01.08_Профиль.SLDPRT

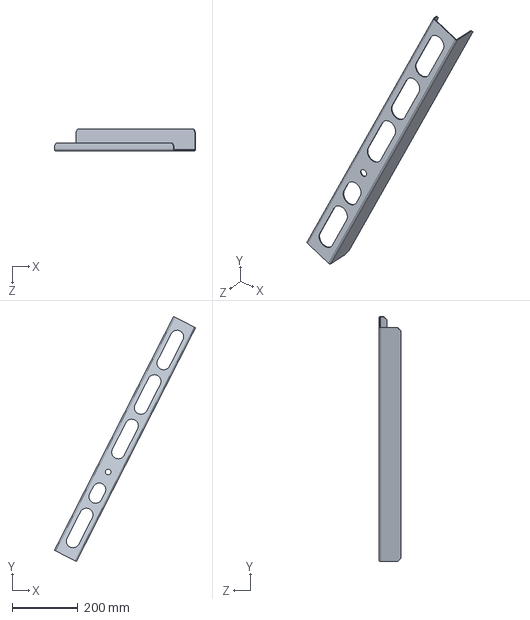
[picture p68: CAD file, 2024-10-05]
РАЗГРУЗЧИК 2.377.06.00.00 (2)/2.377.06.01.08_Профиль.SLDPRT
428.2 x 743.3 x 65.7 mm
