Glebjack/NDM-VOS_powder_hopper/РАЗГРУЗЧИК 2.377.06.00.00 (2)/ВСПФ/NMRV050.SLDPRT

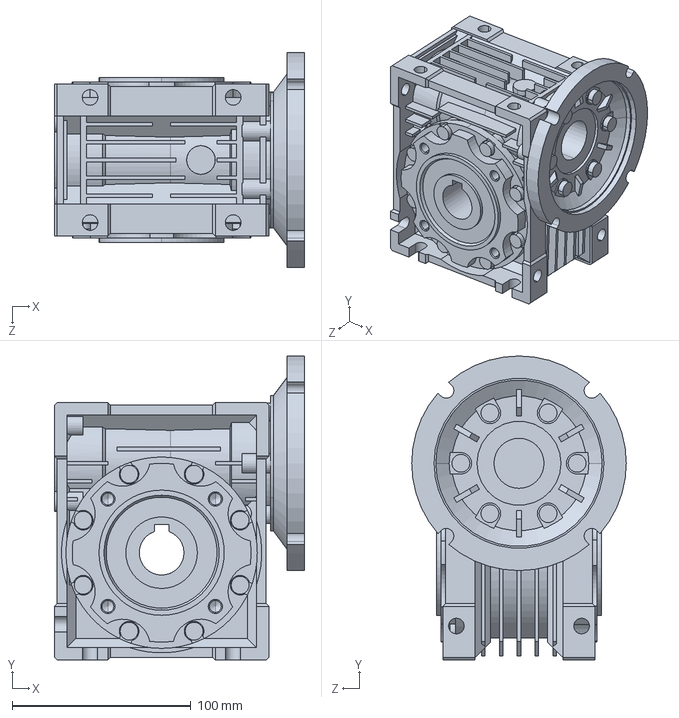
[picture p69: CAD file, 2024-10-05]
РАЗГРУЗЧИК 2.377.06.00.00 (2)/ВСПФ/NMRV050.SLDPRT
140.0 x 170.0 x 120.0 mm
