Glebjack/NDM-VOS_powder_hopper/РАЗГРУЗЧИК 2.377.06.00.00 (2)/РАЗГРУЗЧИК DXF/2.377.06.01.03_Кронштейн.DXF

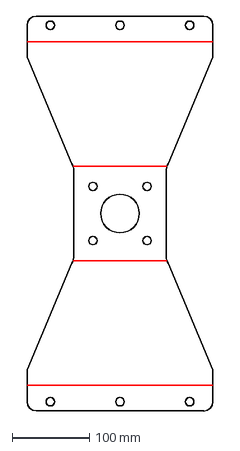
[picture p70: CAD file, 2024-10-05]
РАЗГРУЗЧИК 2.377.06.00.00 (2)/РАЗГРУЗЧИК DXF/2.377.06.01.03_Кронштейн.DXF
240.0 x 510.6 mm
