Glebjack/NDM-VOS_powder_hopper/фрезер/mm=10_ NVPH-301 back side__x2.dxf

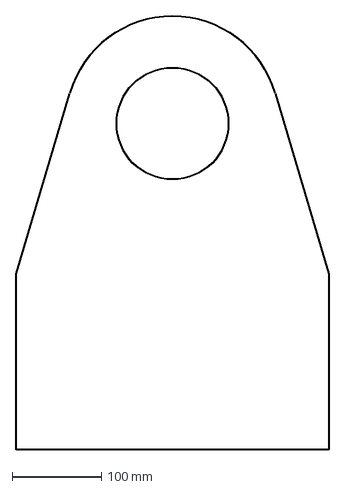
[picture p71: CAD file, 2025-01-17]
фрезер/mm=10_ NVPH-301 back side__x2.dxf
350.0 x 485.0 mm
