Glebjack/NDM-VOS_powder_hopper/LASER/Stainless Steel/3/mat-Stainless Steel_mm=3_ MSC 204 GRID__x6.dxf

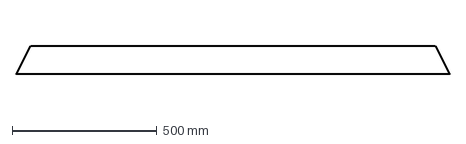
[picture p72: CAD file, 2025-01-17]
LASER/Stainless Steel/3/mat-Stainless Steel_mm=3_ MSC 204 GRID__x6.dxf
1496.7 x 100.0 mm
