Glebjack/NDM-VOS_powder_hopper/РАЗГРУЗЧИК 2.377.06.00.00 (2)/2.377.06.01.22_Круг.SLDPRT

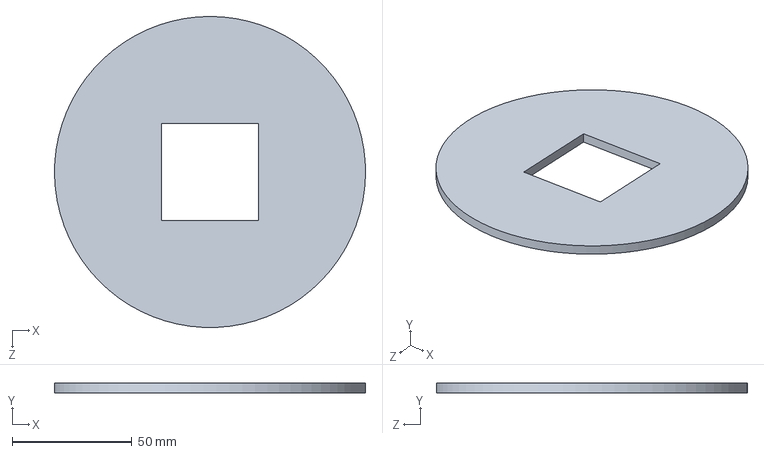
[picture p73: CAD file, 2024-10-05]
РАЗГРУЗЧИК 2.377.06.00.00 (2)/2.377.06.01.22_Круг.SLDPRT
130.0 x 4.00 x 130.0 mm
