Glebjack/NDM-VOS_powder_hopper/РАЗГРУЗЧИК 2.377.06.00.00 (2)/ВСПФ/Емкость разгр ДЕТ.SLDPRT

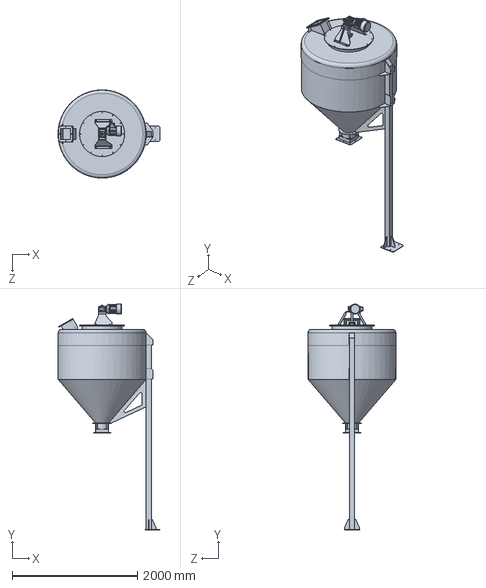
[picture p74: CAD file, 2024-10-05]
РАЗГРУЗЧИК 2.377.06.00.00 (2)/ВСПФ/Емкость разгр ДЕТ.SLDPRT
1623.6 x 3604.2 x 1408.0 mm
