Glebjack/NDM-VOS_powder_hopper/РАЗГРУЗЧИК 2.377.06.00.00 (2)/РАЗГРУЗЧИК DXF/2.377.06.01.07_Фланец.DXF

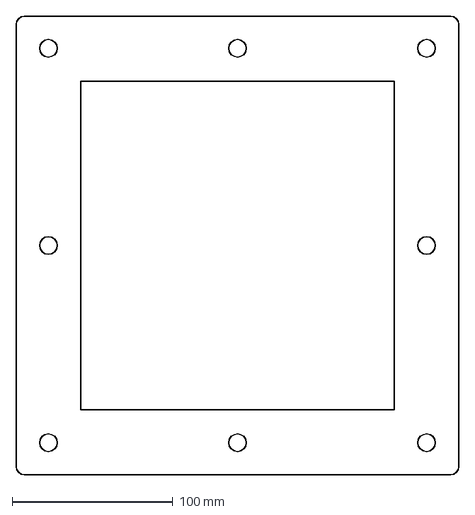
[picture p75: CAD file, 2024-10-05]
РАЗГРУЗЧИК 2.377.06.00.00 (2)/РАЗГРУЗЧИК DXF/2.377.06.01.07_Фланец.DXF
275.0 x 285.0 mm
