Glebjack/NDM-VOS_powder_hopper/LASER/Stainless Steel/3/mat-Stainless Steel_mm=3_ MSC 912 flange slipway__x92.dxf

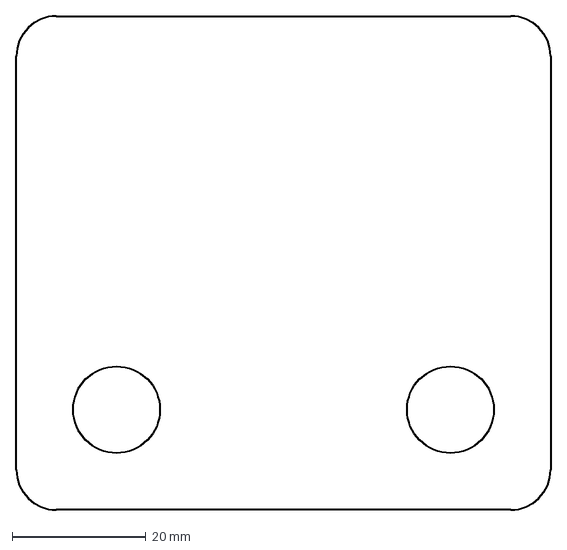
[picture p76: CAD file, 2025-01-17]
LASER/Stainless Steel/3/mat-Stainless Steel_mm=3_ MSC 912 flange slipway__x92.dxf
80.0 x 73.9 mm
