Glebjack/NDM-VOS_powder_hopper/РАЗГРУЗЧИК 2.377.06.00.00 (2)/2.377.06.04.05_Спираль.SLDPRT

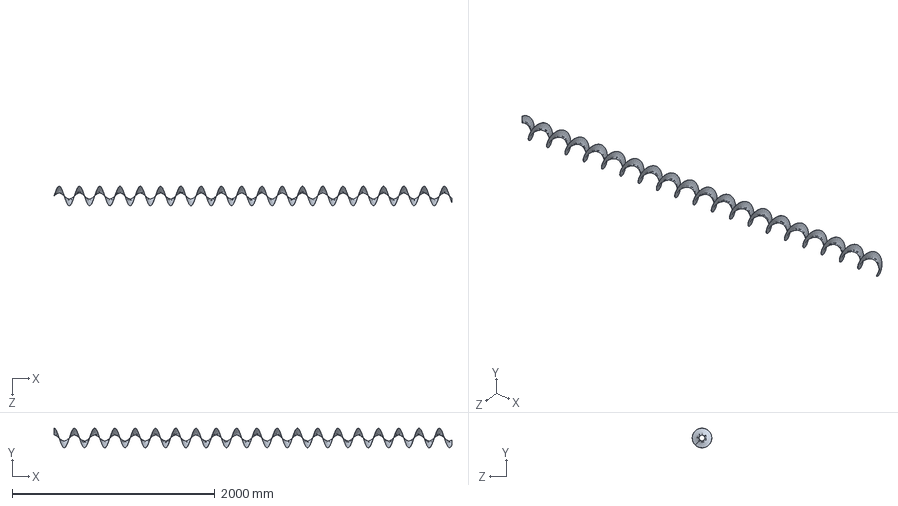
[picture p77: CAD file, 2024-10-05]
РАЗГРУЗЧИК 2.377.06.00.00 (2)/2.377.06.04.05_Спираль.SLDPRT
3926.0 x 194.0 x 194.0 mm
