Glebjack/NDM-VOS_powder_hopper/РАЗГРУЗЧИК 2.377.06.00.00 (2)/ВСПФ/Шнек РАЗГ ДЕТ.SLDPRT

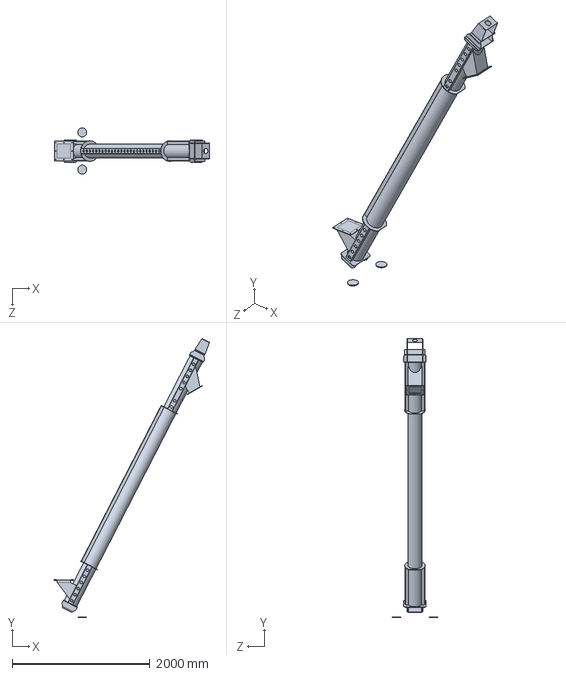
[picture p78: CAD file, 2024-10-05]
РАЗГРУЗЧИК 2.377.06.00.00 (2)/ВСПФ/Шнек РАЗГ ДЕТ.SLDPRT
2253.6 x 4055.7 x 669.6 mm
