Glebjack/NDM-VOS_powder_hopper/РАЗГРУЗЧИК 2.377.06.00.00 (2)/РАЗГРУЗЧИК DXF/2.377.06.01.14_Пластина.DXF

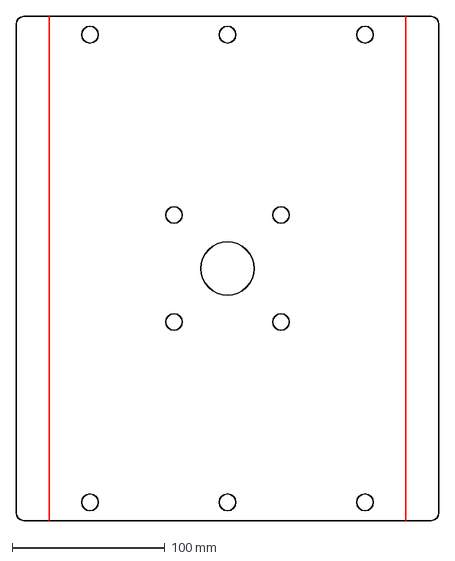
[picture p79: CAD file, 2024-10-05]
РАЗГРУЗЧИК 2.377.06.00.00 (2)/РАЗГРУЗЧИК DXF/2.377.06.01.14_Пластина.DXF
276.8 x 330.0 mm
