Glebjack/NDM-VOS_powder_hopper/фрезер/mm=10_ NVPH-343 cup head flange__x3.dxf

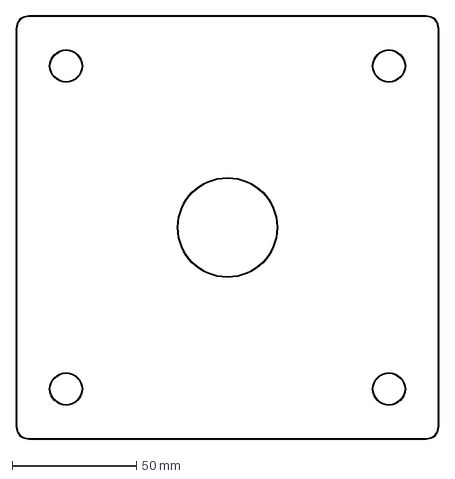
[picture p80: CAD file, 2025-01-17]
фрезер/mm=10_ NVPH-343 cup head flange__x3.dxf
170.0 x 170.0 mm
