Glebjack/NDM-VOS_powder_hopper/фрезер/mm=10_ NVPH-346 feeder hose 3__x4.dxf

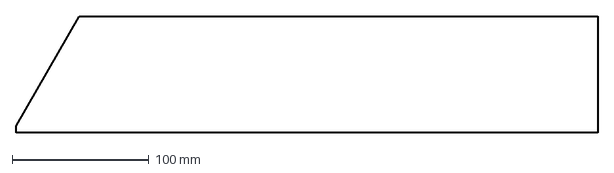
[picture p83: CAD file, 2025-01-17]
фрезер/mm=10_ NVPH-346 feeder hose 3__x4.dxf
426.0 x 85.0 mm
