Glebjack/NDM-VOS_powder_hopper/LASER/Stainless Steel/3/mat-Stainless Steel_mm=3_ MSC 114 CONE IN RIGHT BOARD__x3.dxf

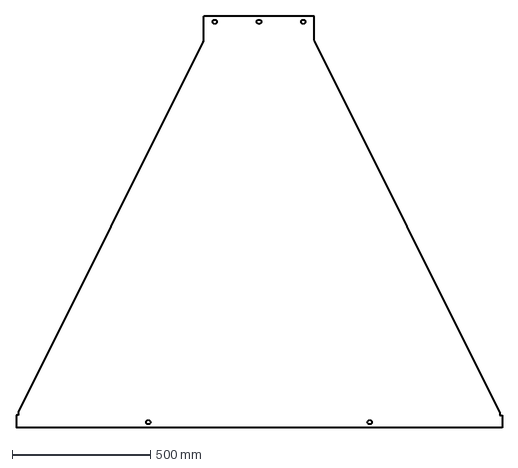
[picture p84: CAD file, 2025-01-17]
LASER/Stainless Steel/3/mat-Stainless Steel_mm=3_ MSC 114 CONE IN RIGHT BOARD__x3.dxf
1756.0 x 1486.3 mm
