Glebjack/NDM-VOS_powder_hopper/РАЗГРУЗЧИК 2.377.06.00.00 (2)/2.377.06.02.07_Обечайка.SLDPRT

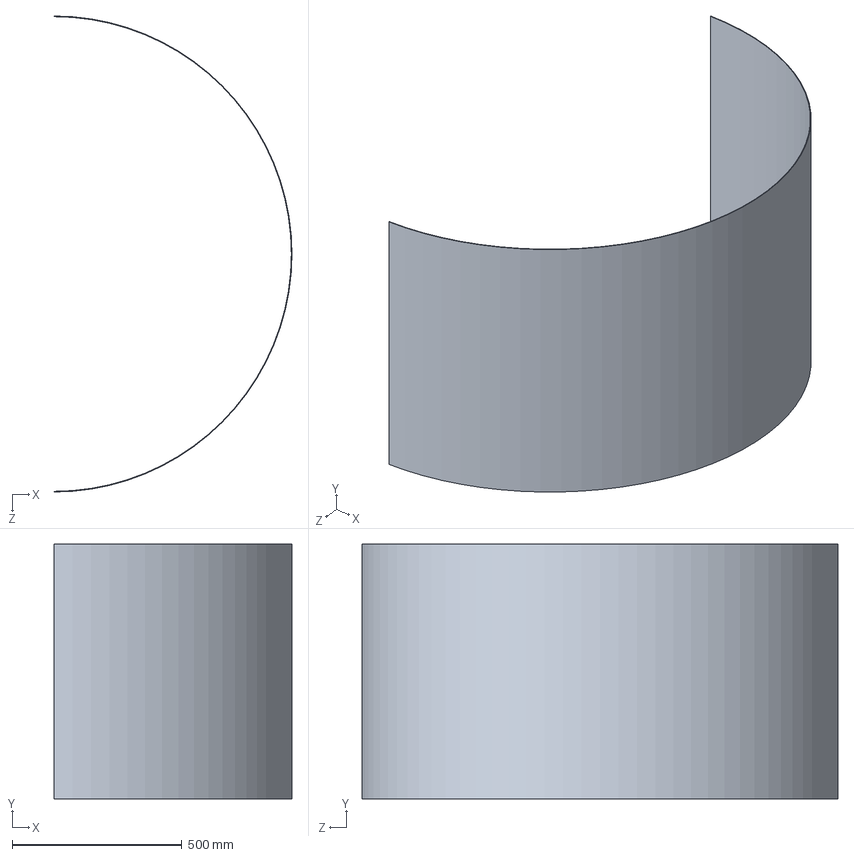
[picture p85: CAD file, 2024-10-05]
РАЗГРУЗЧИК 2.377.06.00.00 (2)/2.377.06.02.07_Обечайка.SLDPRT
700.0 x 750.0 x 1400.0 mm
