Glebjack/NDM-VOS_powder_hopper/РАЗГРУЗЧИК 2.377.06.00.00 (2)/ВСПФ/2.377.06.02.04_Крышка.SLDPRT

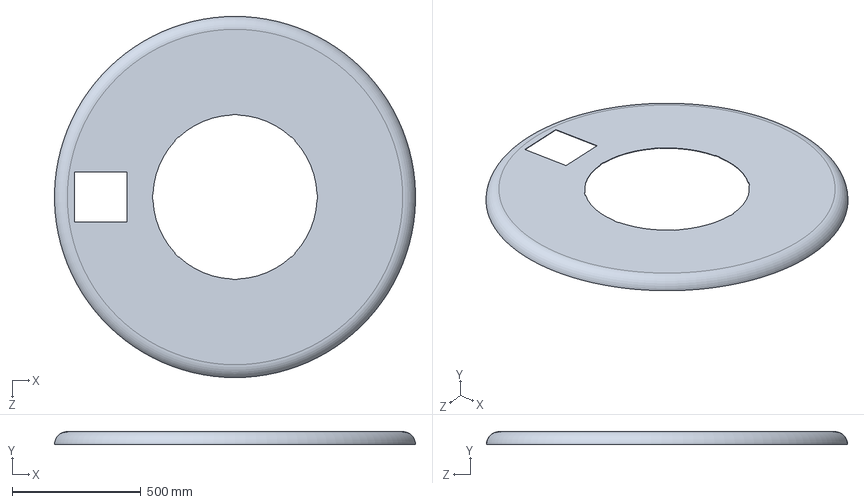
[picture p86: CAD file, 2024-10-05]
РАЗГРУЗЧИК 2.377.06.00.00 (2)/ВСПФ/2.377.06.02.04_Крышка.SLDPRT
1399.4 x 50.0 x 1400.0 mm
