Glebjack/NDM-VOS_powder_hopper/фрезер/mm=10_ NVPH-304 right side__x2.dxf

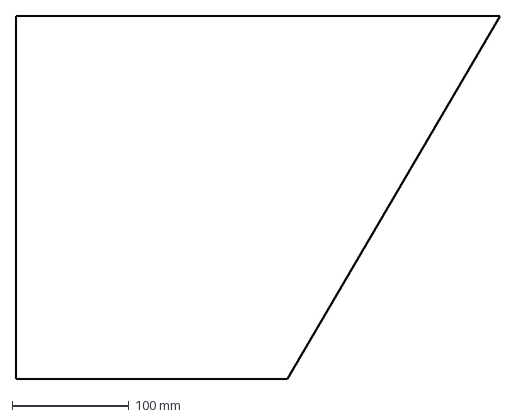
[picture p88: CAD file, 2025-01-17]
фрезер/mm=10_ NVPH-304 right side__x2.dxf
414.0 x 310.0 mm
