Glebjack/NDM-VOS_powder_hopper/LASER/Stainless Steel/3/mat-Stainless Steel_mm=3_ MSC 207 CONE BLADE__x3.dxf

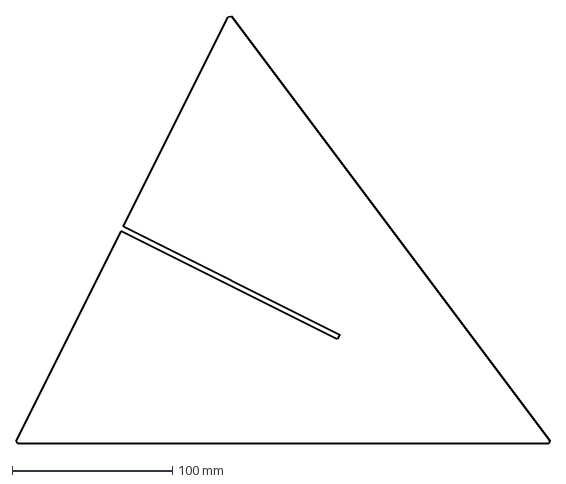
[picture p89: CAD file, 2025-01-17]
LASER/Stainless Steel/3/mat-Stainless Steel_mm=3_ MSC 207 CONE BLADE__x3.dxf
333.3 x 266.7 mm
