Glebjack/NDM-VOS_powder_hopper/РАЗГРУЗЧИК 2.377.06.00.00 (2)/2.377.06.02.08_Обечайка.SLDPRT

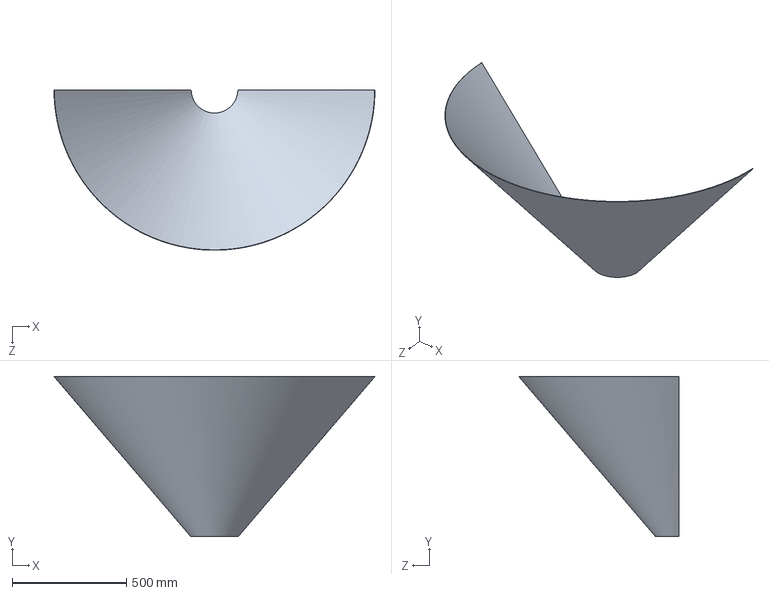
[picture p90: CAD file, 2024-10-05]
РАЗГРУЗЧИК 2.377.06.00.00 (2)/2.377.06.02.08_Обечайка.SLDPRT
1403.0 x 701.3 x 701.4 mm
