Glebjack/NDM-VOS_powder_hopper/РАЗГРУЗЧИК 2.377.06.00.00 (2)/ВСПФ/Шнек Шнек РАЗГ СВД.SLDPRT

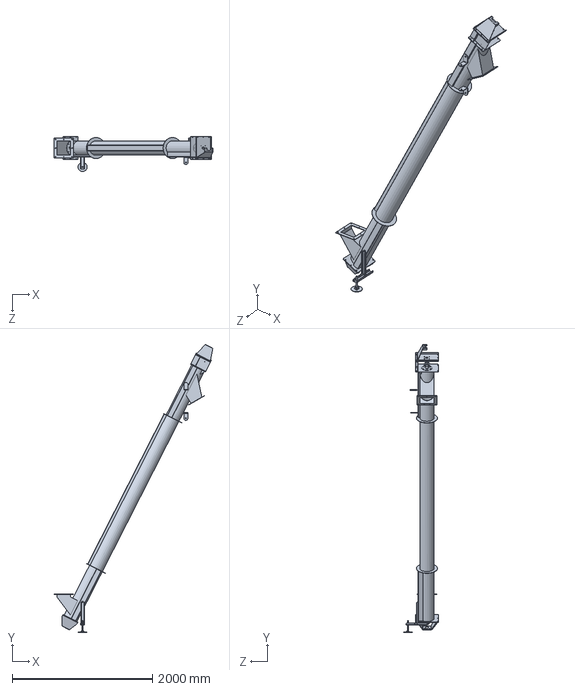
[picture p91: CAD file, 2024-10-05]
РАЗГРУЗЧИК 2.377.06.00.00 (2)/ВСПФ/Шнек Шнек РАЗГ СВД.SLDPRT
2261.6 x 4104.6 x 500.0 mm
