Glebjack/NDM-VOS_powder_hopper/фрезер/mm=10_ NVPH-302 front side__x2.dxf

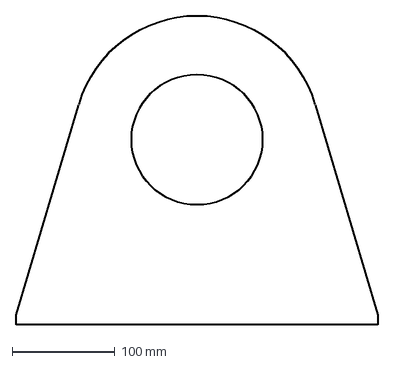
[picture p93: CAD file, 2025-01-17]
фрезер/mm=10_ NVPH-302 front side__x2.dxf
351.0 x 300.0 mm
