Glebjack/NDM-VOS_powder_hopper/LASER/Stainless Steel/3/mat-Stainless Steel_mm=3_ MSC 110 STRINGER CONE__x24.dxf

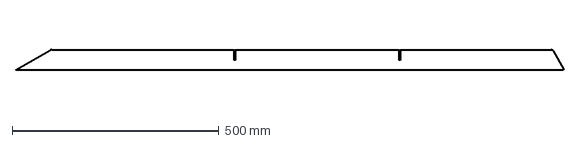
[picture p94: CAD file, 2025-01-17]
LASER/Stainless Steel/3/mat-Stainless Steel_mm=3_ MSC 110 STRINGER CONE__x24.dxf
1325.9 x 50.0 mm
