Glebjack/NDM-VOS_powder_hopper/фрезер/mm=10_ NVPH-332 tube flange 1__x6.dxf

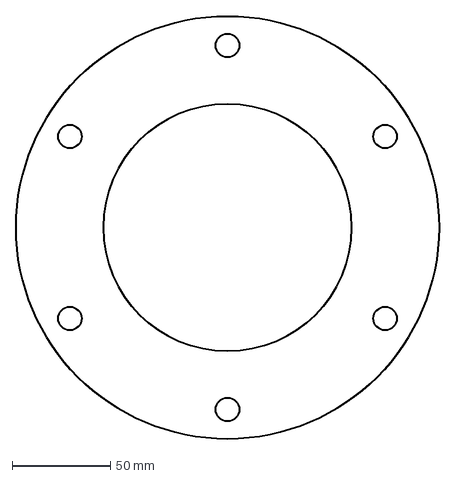
[picture p96: CAD file, 2025-01-17]
фрезер/mm=10_ NVPH-332 tube flange 1__x6.dxf
215.0 x 215.0 mm
