Glebjack/NDM-VOS_powder_hopper/фрезер/mm=10_ NVPH-344 feeder hose 1__x2.dxf

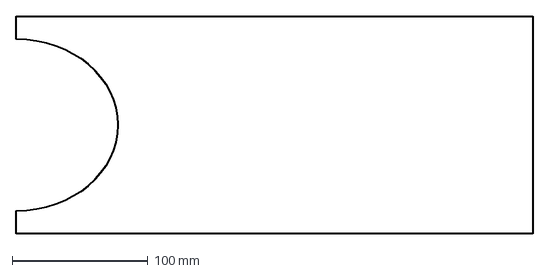
[picture p99: CAD file, 2025-01-17]
фрезер/mm=10_ NVPH-344 feeder hose 1__x2.dxf
380.0 x 160.0 mm
