Glebjack/NDM-VOS_powder_hopper/LASER/Stainless Steel/3/mat-Stainless Steel_mm=3_ FL3.6.2  Motor pillar__x3.dxf

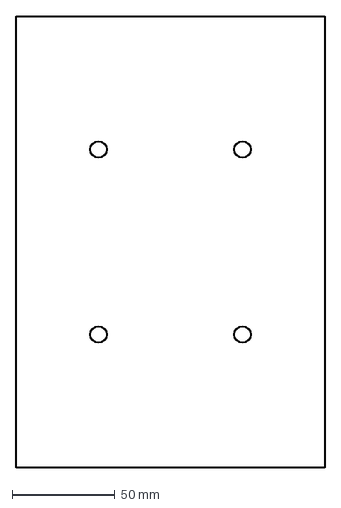
[picture p100: CAD file, 2025-01-17]
LASER/Stainless Steel/3/mat-Stainless Steel_mm=3_ FL3.6.2 Motor pillar__x3.dxf
150.0 x 219.6 mm
