Glebjack/NDM-VOS_powder_hopper/РАЗГРУЗЧИК 2.377.06.00.00 (2)/2.377.06.01.07_Фланец.SLDPRT

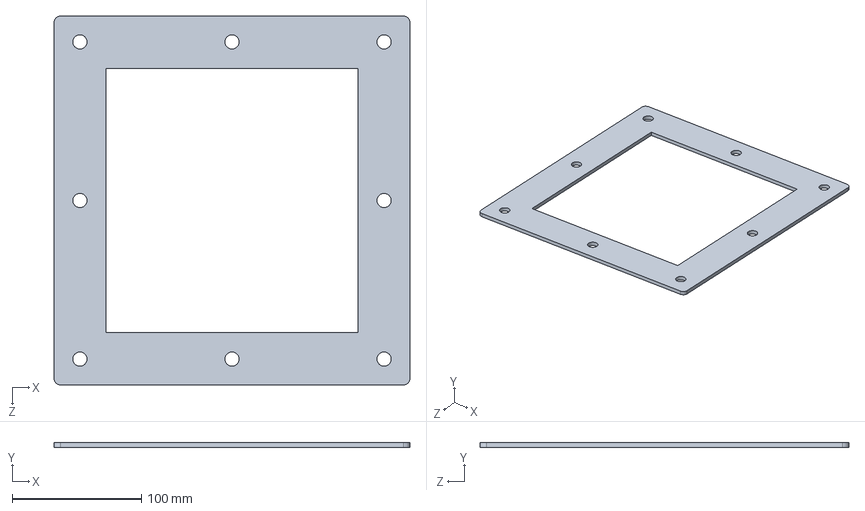
[picture p101: CAD file, 2024-10-05]
РАЗГРУЗЧИК 2.377.06.00.00 (2)/2.377.06.01.07_Фланец.SLDPRT
275.0 x 4.00 x 285.0 mm
