Glebjack/NDM-VOS_powder_hopper/фрезер/mm=10_ NVPH-306 revision cup__x2.dxf

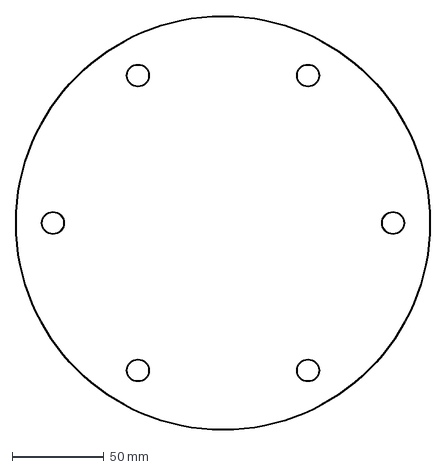
[picture p103: CAD file, 2025-01-17]
фрезер/mm=10_ NVPH-306 revision cup__x2.dxf
225.0 x 225.0 mm
