Glebjack/NDM-VOS_powder_hopper/LASER/Stainless Steel/3/mat-Stainless Steel_mm=3_ MSC 113 CONE IN LEFT BOARD__x3.dxf

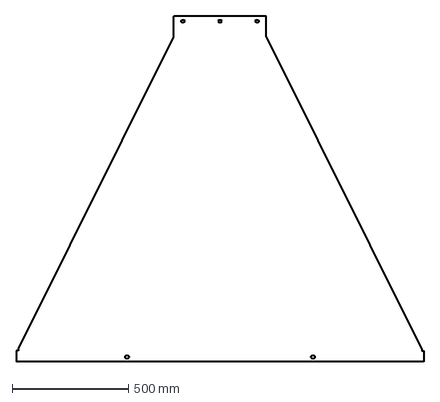
[picture p104: CAD file, 2025-01-17]
LASER/Stainless Steel/3/mat-Stainless Steel_mm=3_ MSC 113 CONE IN LEFT BOARD__x3.dxf
1756.0 x 1486.3 mm
