Glebjack/NDM-VOS_powder_hopper/РАЗГРУЗЧИК 2.377.06.00.00 (2)/2.377.06.04.02_Труба.SLDPRT

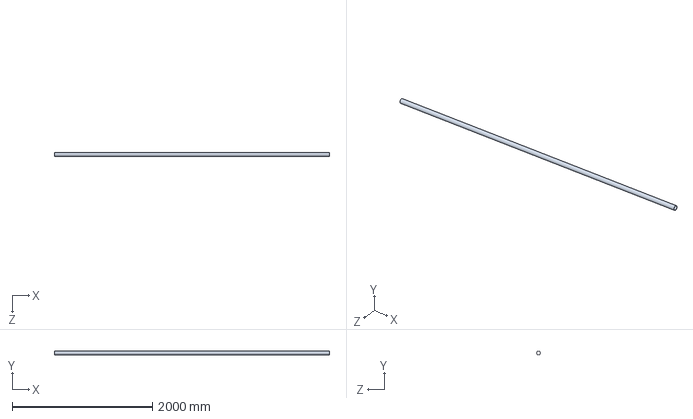
[picture p105: CAD file, 2024-10-05]
РАЗГРУЗЧИК 2.377.06.00.00 (2)/2.377.06.04.02_Труба.SLDPRT
3915.0 x 57.0 x 57.0 mm
