Glebjack/NDM-VOS_powder_hopper/LASER/Stainless Steel/3/mat-Stainless Steel_mm=3_ MSC 901 BASE PLATE__x12.dxf

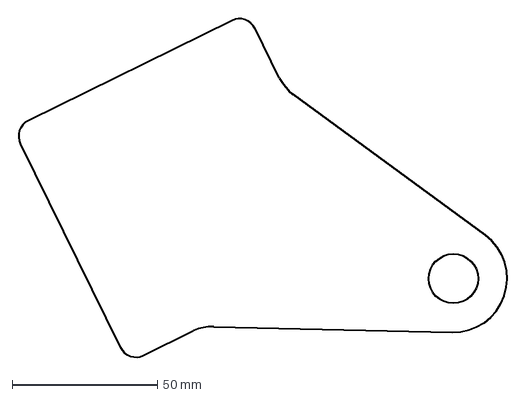
[picture p107: CAD file, 2025-01-17]
LASER/Stainless Steel/3/mat-Stainless Steel_mm=3_ MSC 901 BASE PLATE__x12.dxf
170.6 x 117.4 mm
