Glebjack/NDM-VOS_powder_hopper/РАЗГРУЗЧИК 2.377.06.00.00 (2)/2.377.06.02.01_Фланец.SLDPRT

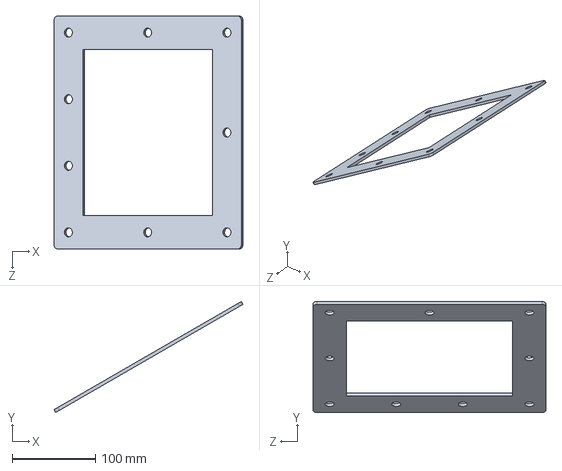
[picture p108: CAD file, 2024-10-05]
РАЗГРУЗЧИК 2.377.06.00.00 (2)/2.377.06.02.01_Фланец.SLDPRT
227.2 x 133.5 x 280.0 mm
