Glebjack/NDM-VOS_powder_hopper/РАЗГРУЗЧИК 2.377.06.00.00 (2)/2.377.06.01.01_Труба.SLDPRT

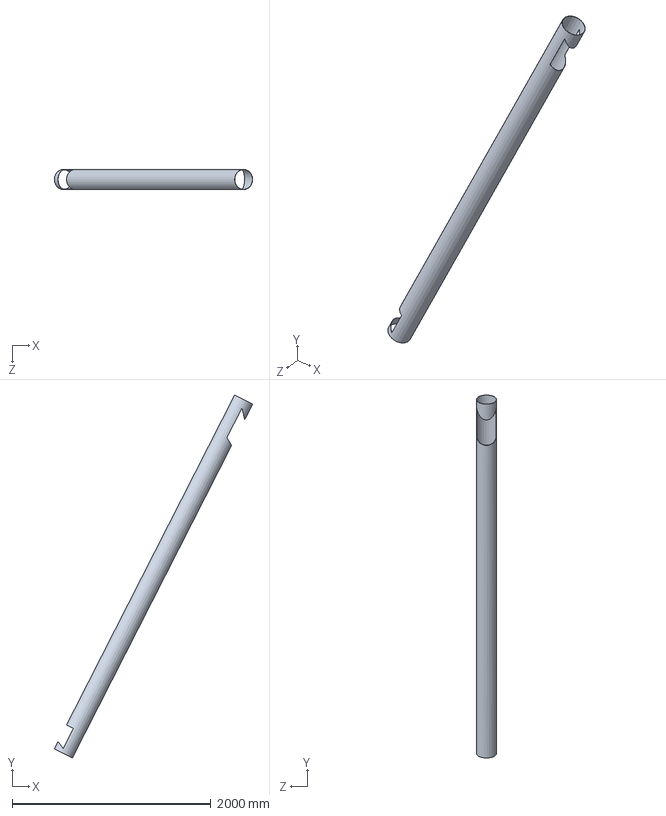
[picture p111: CAD file, 2024-10-05]
РАЗГРУЗЧИК 2.377.06.00.00 (2)/2.377.06.01.01_Труба.SLDPRT
1997.7 x 3656.6 x 204.0 mm
