Glebjack/NDM-VOS_powder_hopper/РАЗГРУЗЧИК 2.377.06.00.00 (2)/2.377.06.02.14_Кронштейн.SLDPRT

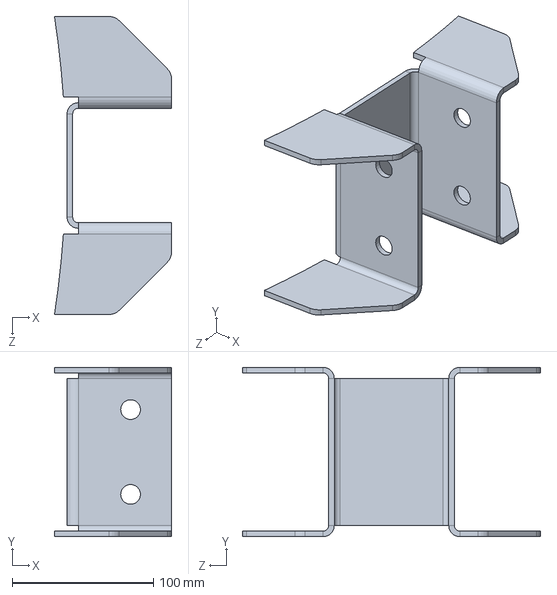
[picture p113: CAD file, 2024-10-05]
РАЗГРУЗЧИК 2.377.06.00.00 (2)/2.377.06.02.14_Кронштейн.SLDPRT
82.9 x 120.0 x 211.0 mm
