Glebjack/NDM-VOS_powder_hopper/LASER/Stainless Steel/3/mat-Stainless Steel_mm=3_ NDM-VOS 712 flange__x6.dxf

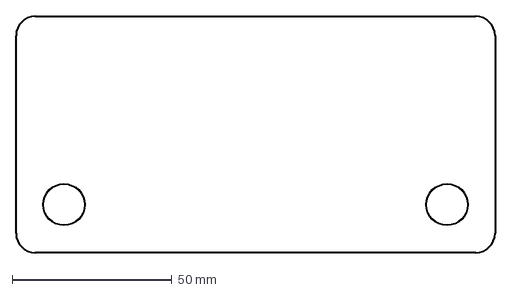
[picture p115: CAD file, 2025-01-17]
LASER/Stainless Steel/3/mat-Stainless Steel_mm=3_ NDM-VOS 712 flange__x6.dxf
150.0 x 73.9 mm
