Glebjack/NDM-VOS_powder_hopper/РАЗГРУЗЧИК 2.377.06.00.00 (2)/2.377.06.02.15_Кронштейн.SLDPRT

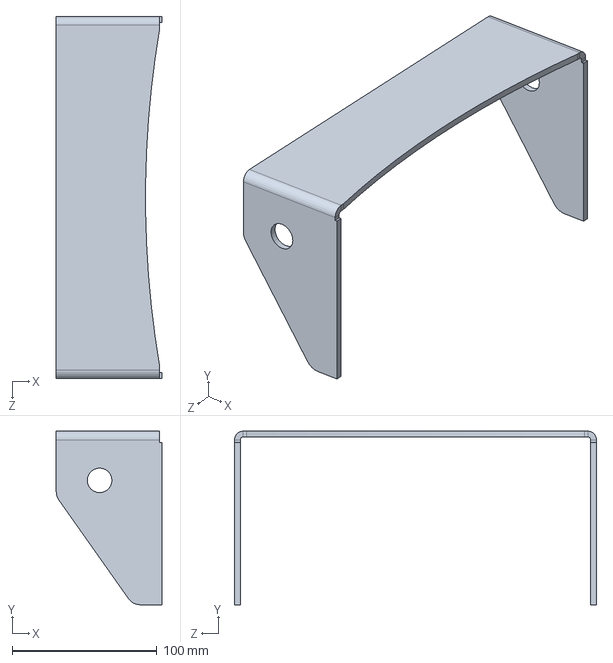
[picture p116: CAD file, 2024-10-05]
РАЗГРУЗЧИК 2.377.06.00.00 (2)/2.377.06.02.15_Кронштейн.SLDPRT
72.9 x 120.0 x 250.0 mm
