Glebjack/NDM-VOS_powder_hopper/LASER/Stainless Steel/3/mat-Stainless Steel_mm=3_ MSC 203 GRID__x15.dxf

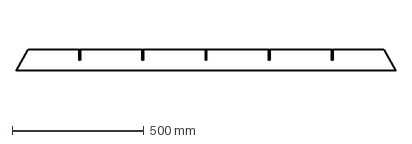
[picture p118: CAD file, 2025-01-17]
LASER/Stainless Steel/3/mat-Stainless Steel_mm=3_ MSC 203 GRID__x15.dxf
1442.3 x 80.0 mm
