Glebjack/NDM-VOS_powder_hopper/РАЗГРУЗЧИК 2.377.06.00.00 (2)/2.377.06.03.01_Труба.SLDPRT

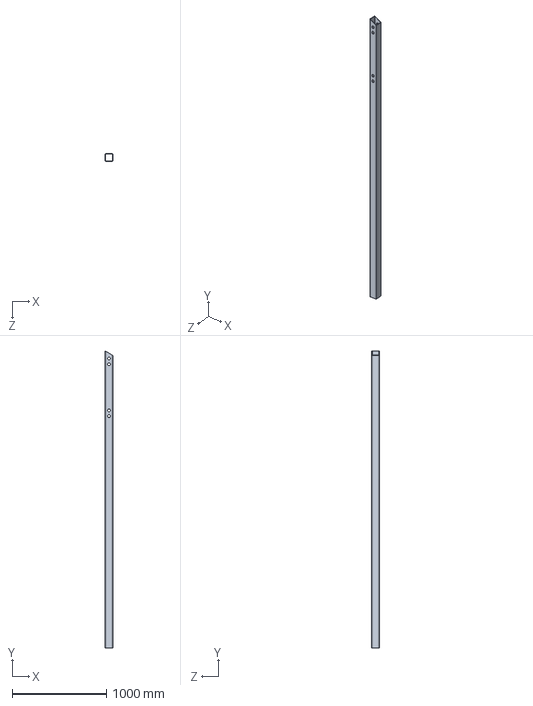
[picture p119: CAD file, 2024-10-05]
РАЗГРУЗЧИК 2.377.06.00.00 (2)/2.377.06.03.01_Труба.SLDPRT
80.0 x 3148.3 x 80.0 mm
