Glebjack/NDM-VOS_powder_hopper/LASER/Stainless Steel/3/mat-Stainless Steel_mm=3_ MSC 107 RIB CONE__x6.dxf

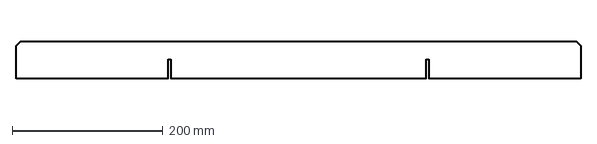
[picture p121: CAD file, 2025-01-17]
LASER/Stainless Steel/3/mat-Stainless Steel_mm=3_ MSC 107 RIB CONE__x6.dxf
750.0 x 50.0 mm
