Glebjack/NDM-VOS_powder_hopper/РАЗГРУЗЧИК 2.377.06.00.00 (2)/2.377.06.01.03_Кронштейн.SLDPRT

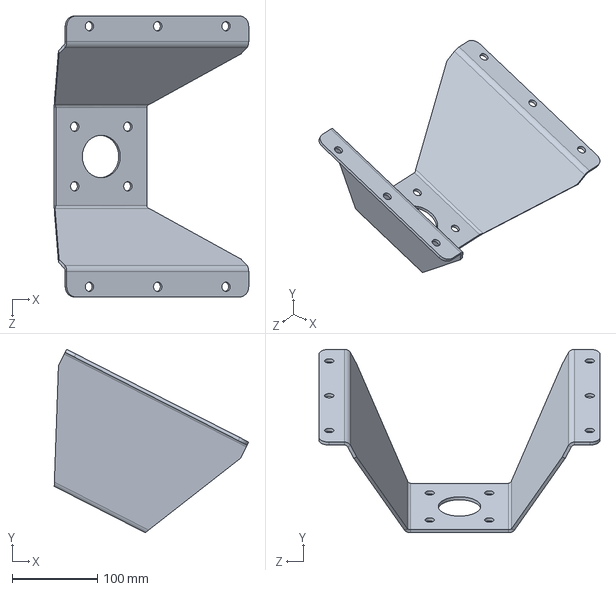
[picture p122: CAD file, 2024-10-05]
РАЗГРУЗЧИК 2.377.06.00.00 (2)/2.377.06.01.03_Кронштейн.SLDPRT
228.5 x 215.4 x 330.0 mm
