Glebjack/NDM-VOS_powder_hopper/LASER/Stainless Steel/3/mat-Stainless Steel_mm=3_ MSC 202 GRID CORNER__x24.dxf

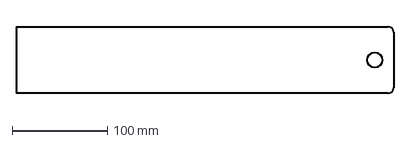
[picture p124: CAD file, 2025-01-17]
LASER/Stainless Steel/3/mat-Stainless Steel_mm=3_ MSC 202 GRID CORNER__x24.dxf
395.4 x 70.0 mm
