Glebjack/NDM-VOS_powder_hopper/LASER/Stainless Steel/3/mat-Stainless Steel_mm=3_ MSC 108 RIB CONE__x6.dxf

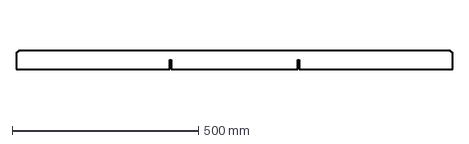
[picture p126: CAD file, 2025-01-17]
LASER/Stainless Steel/3/mat-Stainless Steel_mm=3_ MSC 108 RIB CONE__x6.dxf
1170.0 x 50.0 mm
