Glebjack/NDM-VOS_powder_hopper/РАЗГРУЗЧИК 2.377.06.00.00 (2)/2.377.06.01.02_Фланец.SLDPRT

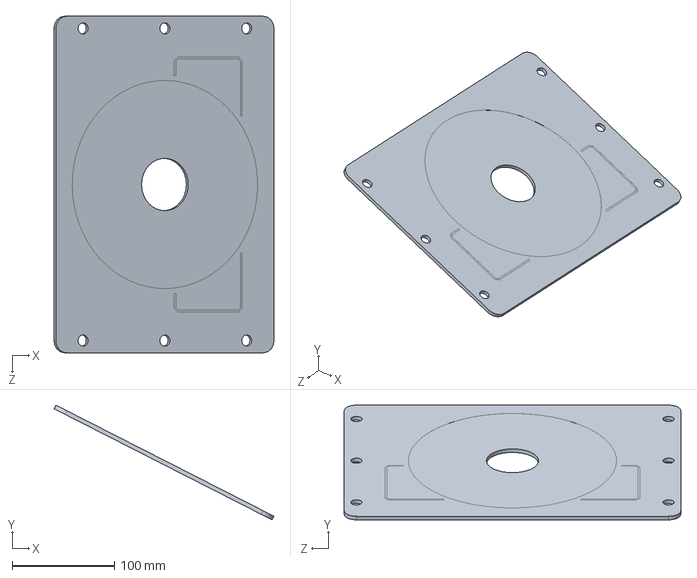
[picture p127: CAD file, 2024-10-05]
РАЗГРУЗЧИК 2.377.06.00.00 (2)/2.377.06.01.02_Фланец.SLDPRT
215.7 x 112.5 x 330.0 mm
