Glebjack/NDM-VOS_powder_hopper/LASER/Stainless Steel/3/mat-Stainless Steel_mm=3_ NDM-VOS 715 flange__x6.dxf

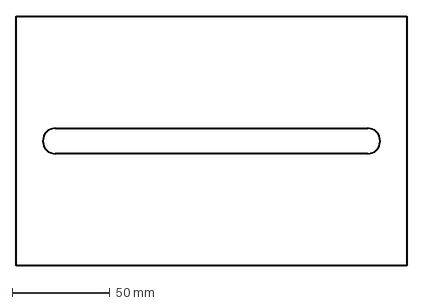
[picture p129: CAD file, 2025-01-17]
LASER/Stainless Steel/3/mat-Stainless Steel_mm=3_ NDM-VOS 715 flange__x6.dxf
200.0 x 127.9 mm
