Glebjack/NDM-VOS_powder_hopper/РАЗГРУЗЧИК 2.377.06.00.00 (2)/2.377.06.02.02_Профиль.SLDPRT

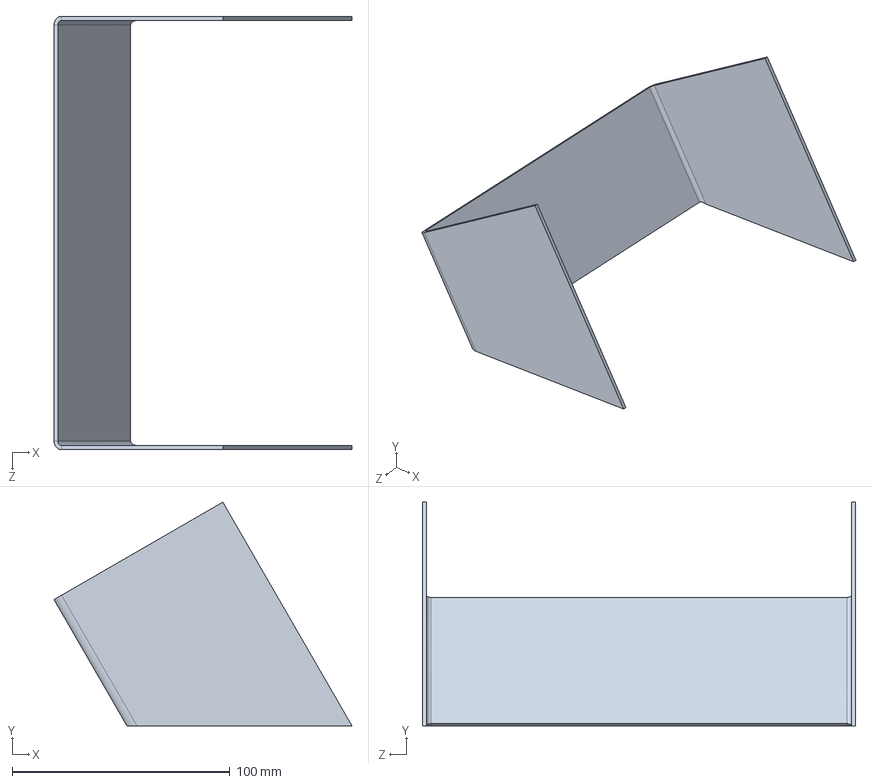
[picture p130: CAD file, 2024-10-05]
РАЗГРУЗЧИК 2.377.06.00.00 (2)/2.377.06.02.02_Профиль.SLDPRT
136.8 x 102.7 x 199.0 mm
