Glebjack/NDM-VOS_powder_hopper/LASER/Stainless Steel/3/mat-Stainless Steel_mm=3_ MSC 205 CONE BLADE__x3.dxf

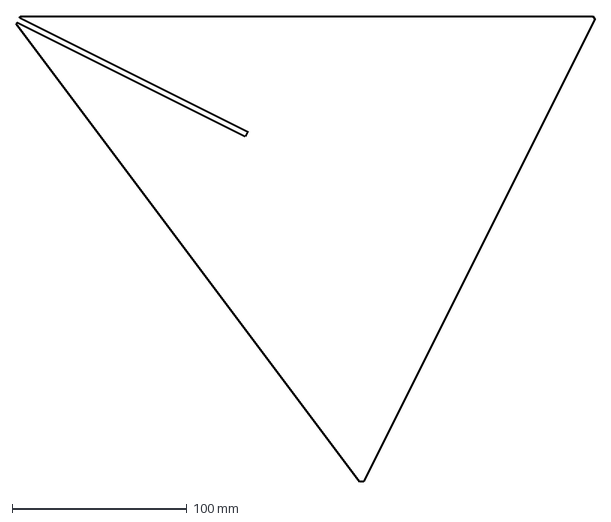
[picture p132: CAD file, 2025-01-17]
LASER/Stainless Steel/3/mat-Stainless Steel_mm=3_ MSC 205 CONE BLADE__x3.dxf
331.2 x 266.7 mm
