Glebjack/NDM-VOS_powder_hopper/РАЗГРУЗЧИК 2.377.06.00.00 (2)/2.377.06.04.04_Полуось.SLDPRT

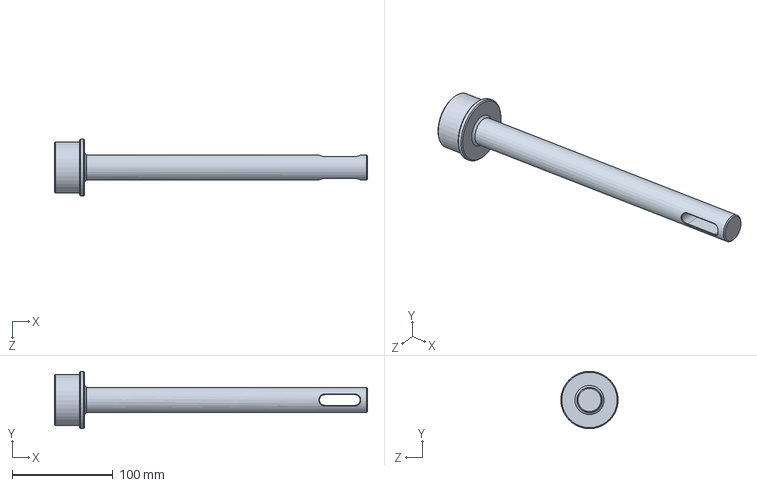
[picture p133: CAD file, 2024-10-05]
РАЗГРУЗЧИК 2.377.06.00.00 (2)/2.377.06.04.04_Полуось.SLDPRT
311.0 x 57.0 x 56.8 mm
