Glebjack/NDM-VOS_powder_hopper/LASER/Stainless Steel/3/mat-Stainless Steel_mm=3_ NDM-VOS 777 sredder wall 7__x3.dxf

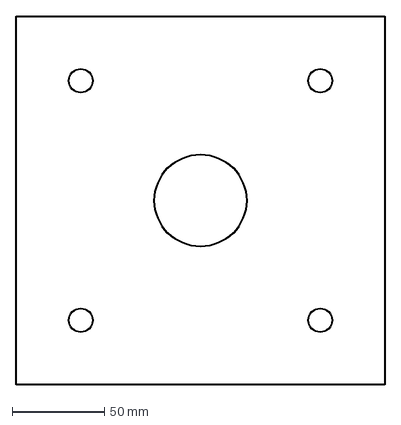
[picture p135: CAD file, 2025-01-17]
LASER/Stainless Steel/3/mat-Stainless Steel_mm=3_ NDM-VOS 777 sredder wall 7__x3.dxf
200.0 x 200.0 mm
