Glebjack/NDM-VOS_powder_hopper/РАЗГРУЗЧИК 2.377.06.00.00 (2)/2.377.06.01.15_Кронштейн.SLDPRT

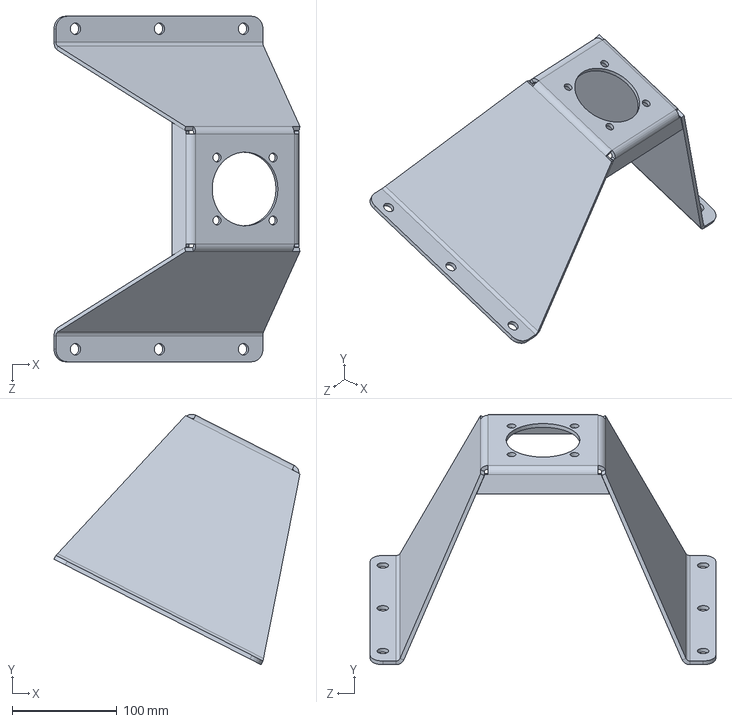
[picture p136: CAD file, 2024-10-05]
РАЗГРУЗЧИК 2.377.06.00.00 (2)/2.377.06.01.15_Кронштейн.SLDPRT
234.9 x 239.2 x 330.0 mm
