Glebjack/NDM-VOS_powder_hopper/РАЗГРУЗЧИК 2.377.06.00.00 (2)/2.377.06.01.25_Профиль.SLDPRT

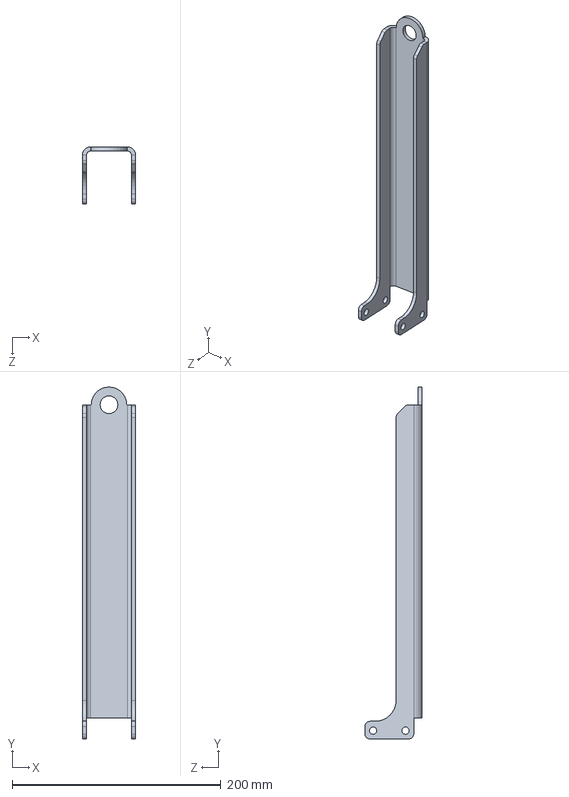
[picture p138: CAD file, 2024-10-05]
РАЗГРУЗЧИК 2.377.06.00.00 (2)/2.377.06.01.25_Профиль.SLDPRT
51.0 x 337.1 x 55.0 mm
