Glebjack/NDM-VOS_powder_hopper/РАЗГРУЗЧИК 2.377.06.00.00 (2)/2.377.06.01.14_Пластина.SLDPRT

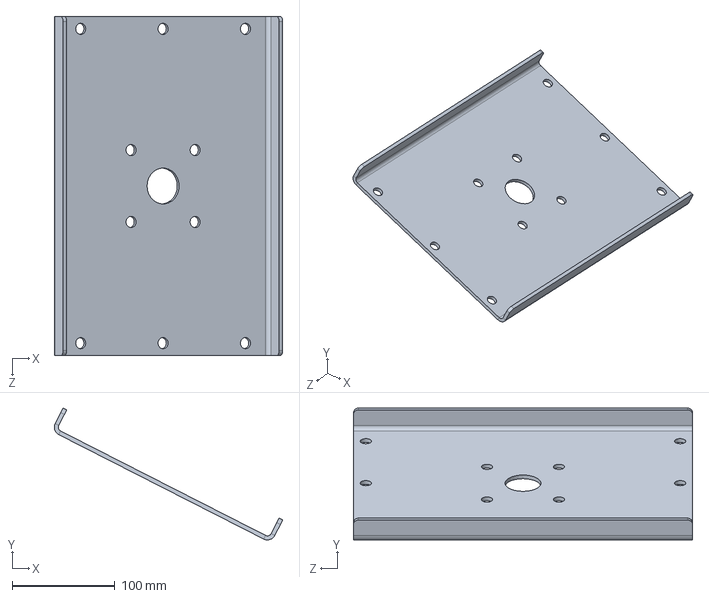
[picture p140: CAD file, 2024-10-05]
РАЗГРУЗЧИК 2.377.06.00.00 (2)/2.377.06.01.14_Пластина.SLDPRT
222.4 x 128.5 x 330.0 mm
