Glebjack/NDM-VOS_powder_hopper/РАЗГРУЗЧИК 2.377.06.00.00 (2)/2.377.06.03.02_Заглушка.SLDPRT

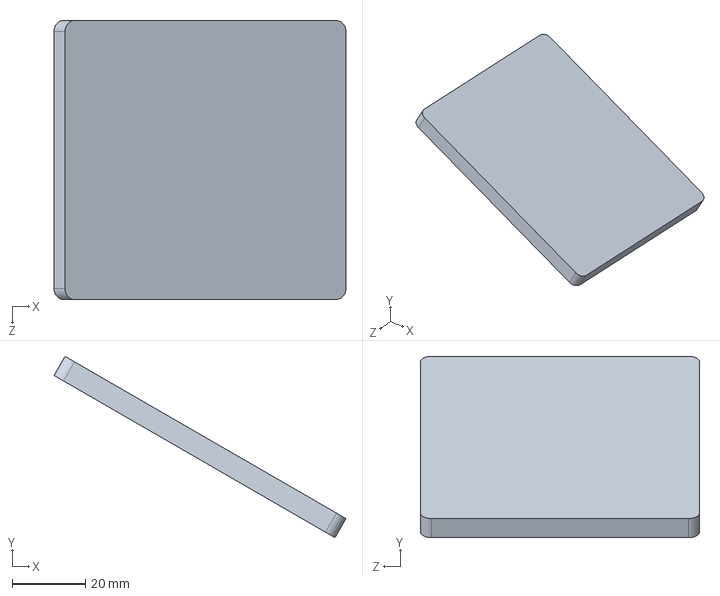
[picture p142: CAD file, 2024-10-05]
РАЗГРУЗЧИК 2.377.06.00.00 (2)/2.377.06.03.02_Заглушка.SLDPRT
79.5 x 49.4 x 76.0 mm
