Glebjack/NDM-VOS_powder_hopper/РАЗГРУЗЧИК 2.377.06.00.00 (2)/2.377.06.01.09_Профиль.SLDPRT

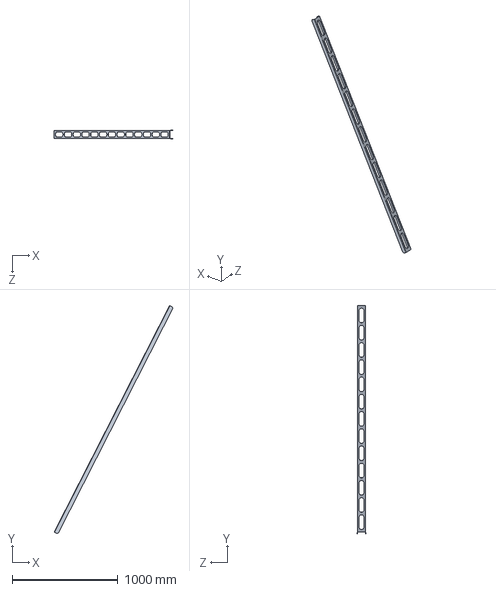
[picture p144: CAD file, 2024-10-05]
РАЗГРУЗЧИК 2.377.06.00.00 (2)/2.377.06.01.09_Профиль.SLDPRT
1120.7 x 2152.0 x 80.0 mm
