Glebjack/NDM-VOS_powder_hopper/РАЗГРУЗЧИК 2.377.06.00.00 (2)/2.377.06.01.13_Ребро.SLDPRT

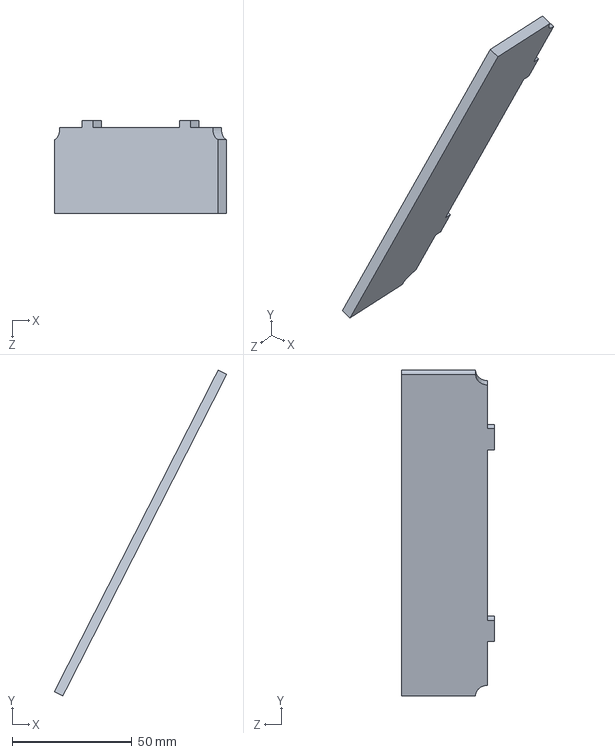
[picture p148: CAD file, 2024-10-05]
РАЗГРУЗЧИК 2.377.06.00.00 (2)/2.377.06.01.13_Ребро.SLDPRT
72.1 x 136.4 x 39.0 mm
