Glebjack/NDM-VOS_powder_hopper/РАЗГРУЗЧИК 2.377.06.00.00 (2)/2.377.06.01.11_Кольцо.SLDPRT

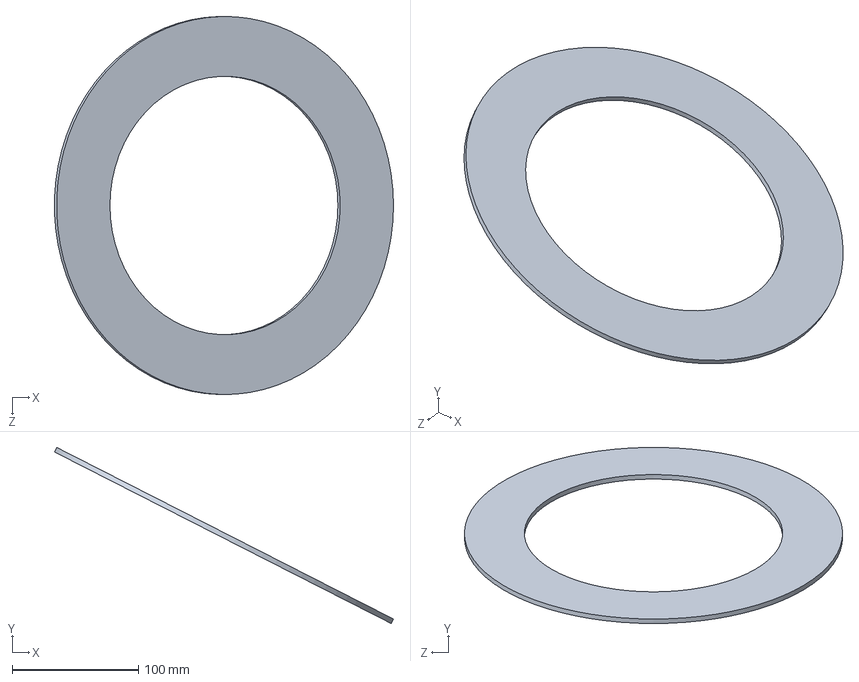
[picture p152: CAD file, 2024-10-05]
РАЗГРУЗЧИК 2.377.06.00.00 (2)/2.377.06.01.11_Кольцо.SLDPRT
269.0 x 139.7 x 299.9 mm
