Glebjack/NDM-VOS_powder_hopper/РАЗГРУЗЧИК 2.377.06.00.00 (2)/2.377.06.02.05_Обечайка.SLDPRT

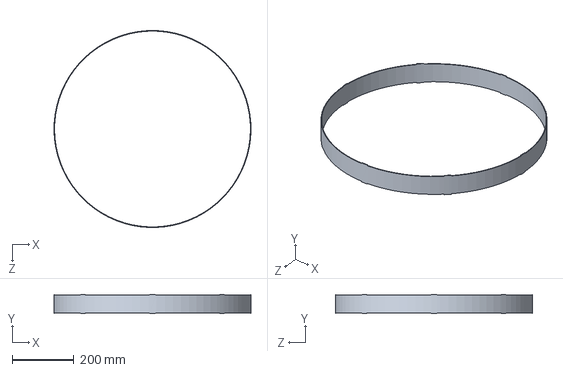
[picture p155: CAD file, 2024-10-05]
РАЗГРУЗЧИК 2.377.06.00.00 (2)/2.377.06.02.05_Обечайка.SLDPRT
639.9 x 62.0 x 639.8 mm
