Glebjack/NDM-VOS_powder_hopper/РАЗГРУЗЧИК 2.377.06.00.00 (2)/2.377.06.01.24_Профиль.SLDPRT

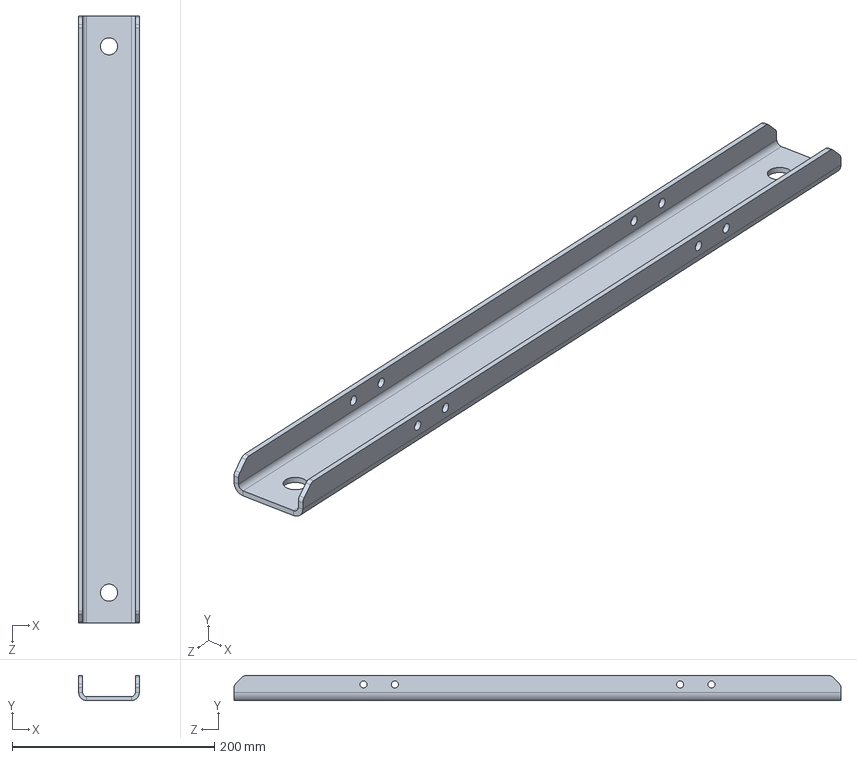
[picture p157: CAD file, 2024-10-05]
РАЗГРУЗЧИК 2.377.06.00.00 (2)/2.377.06.01.24_Профиль.SLDPRT
60.0 x 25.0 x 600.0 mm
