Glebjack/NDM-VOS_powder_hopper/РАЗГРУЗЧИК 2.377.06.00.00 (2)/2.377.06.00.03_Вал.SLDPRT

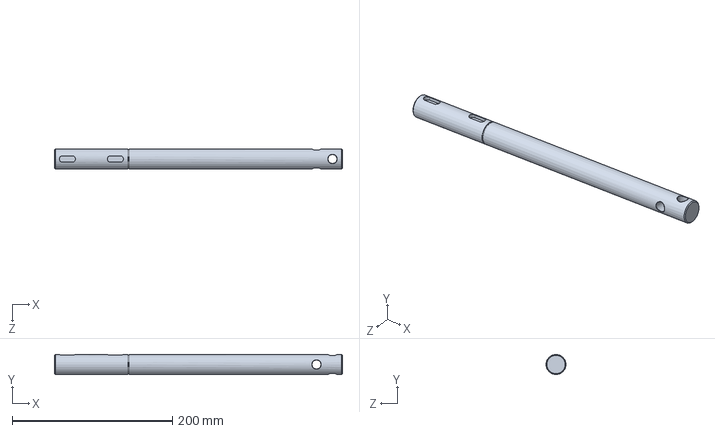
[picture p160: CAD file, 2024-10-05]
РАЗГРУЗЧИК 2.377.06.00.00 (2)/2.377.06.00.03_Вал.SLDPRT
360.0 x 25.0 x 25.0 mm
