Glebjack/NDM-VOS_powder_hopper/РАЗГРУЗЧИК 2.377.06.00.00 (2)/2.377.06.04.03_Втулка.SLDPRT

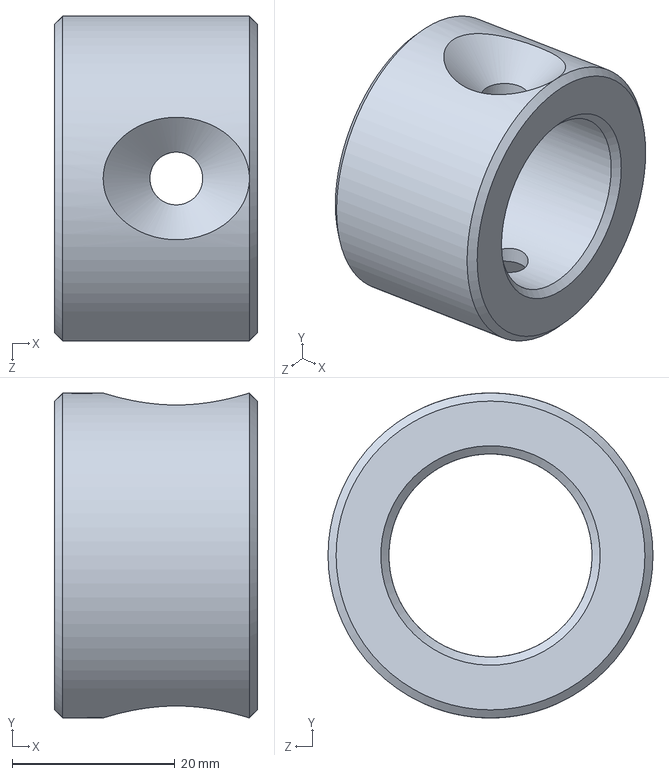
[picture p162: CAD file, 2024-10-05]
РАЗГРУЗЧИК 2.377.06.00.00 (2)/2.377.06.04.03_Втулка.SLDPRT
25.0 x 40.0 x 40.0 mm
