Glebjack/NDM-VOS_powder_hopper/РАЗГРУЗЧИК 2.377.06.00.00 (2)/2.377.06.01.26_Косынка.SLDPRT

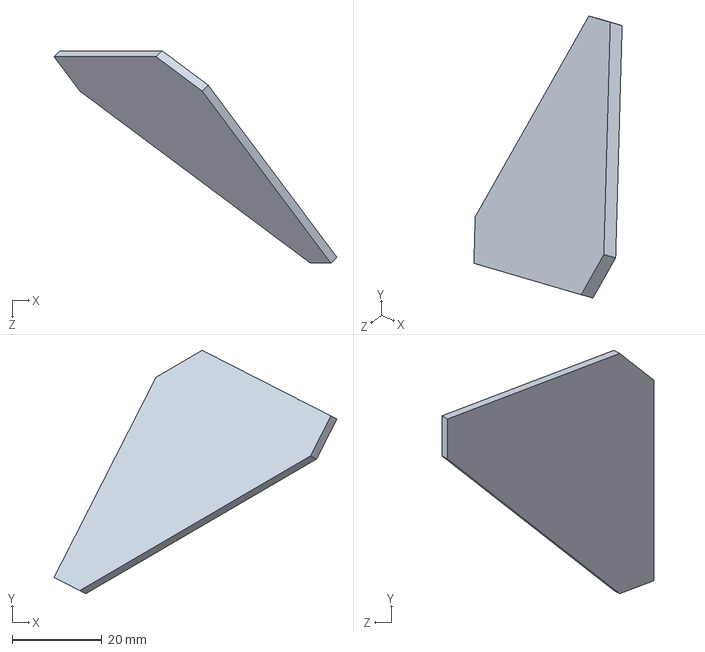
[picture p164: CAD file, 2024-10-05]
РАЗГРУЗЧИК 2.377.06.00.00 (2)/2.377.06.01.26_Косынка.SLDPRT
63.0 x 54.2 x 47.2 mm
