Glebjack/NDM-VOS_powder_hopper/РАЗГРУЗЧИК 2.377.06.00.00 (2)/2.377.06.02.09_Труба.SLDPRT

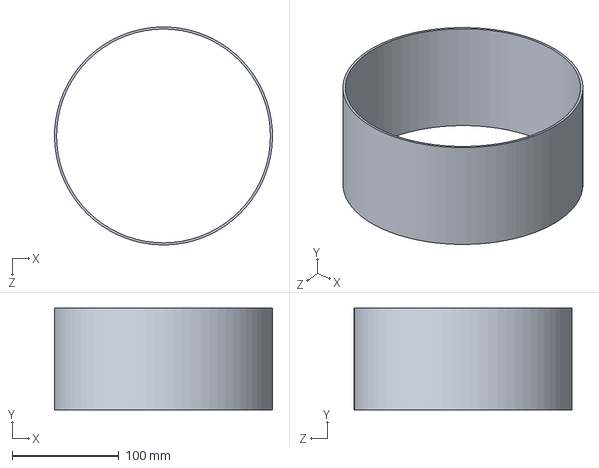
[picture p167: CAD file, 2024-10-05]
РАЗГРУЗЧИК 2.377.06.00.00 (2)/2.377.06.02.09_Труба.SLDPRT
204.0 x 95.0 x 203.9 mm
