Glebjack/NDM-VOS_powder_hopper/РАЗГРУЗЧИК 2.377.06.00.00 (2)/2.377.06.03.06_Втулка.SLDPRT

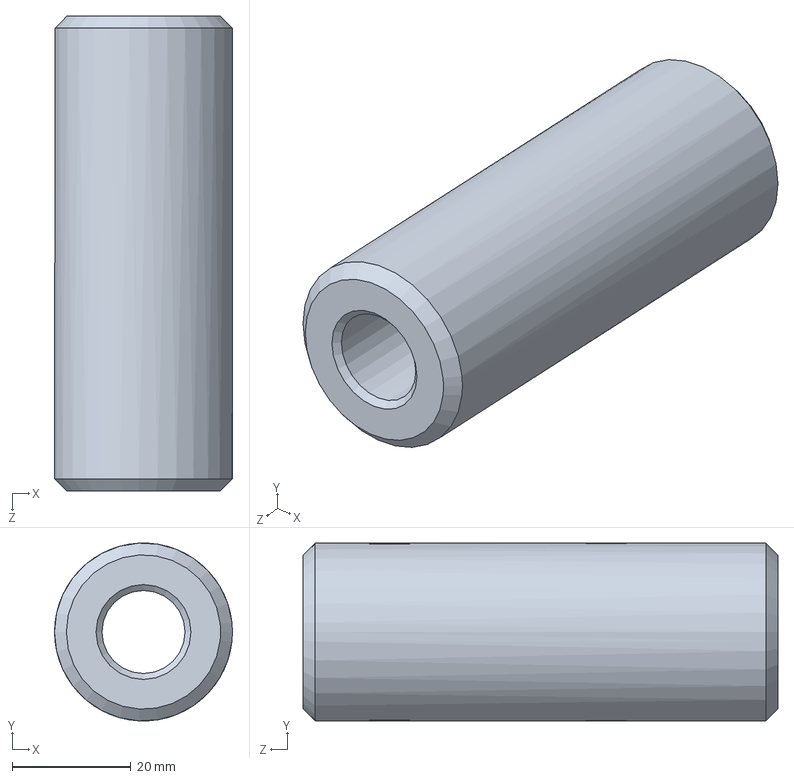
[picture p169: CAD file, 2024-10-05]
РАЗГРУЗЧИК 2.377.06.00.00 (2)/2.377.06.03.06_Втулка.SLDPRT
30.0 x 30.0 x 80.0 mm
