Glebjack/NDM-VOS_powder_hopper/(list of files, cad)

Other CAD files:
New folder/2.263.00.00.00.СБ__дробилка.STP
ref/СДР вертикальная двухкамерная.dwg
Ревит/План для Реагентного хозяйства подложка Ревит.dwg
ASY NDM-VOS_powder_hopper.dwg
Чертеж1.dwg
РАЗГРУЗЧИК 2.377.06.00.00 (2)/ВСПФ/Спираль РАЗГ СВД.SLDPRT
РАЗГРУЗЧИК 2.377.06.00.00 (2)/2.377.06.00.00_Разгрузчик_Лист1.dwg
РАЗГРУЗЧИК 2.377.06.00.00 (2)/2.377.06.01.08-01_Профиль.sldprt
РАЗГРУЗЧИК 2.377.06.00.00 (2)/2.377.06.03.00_Стойка_Лист1.dwg
3d party/Mixer 22.04.24/ASY mixer 3.iam
3d party/Mixer 22.04.24/shaft 2.ipt
3d party/Mixer 22.04.24/shaft 3.ipt
3d party/Mixer 22.04.24/Параметры.ipt
3d party/Mixer 22.04.24/втулка.ipt
3d party/Mixer 22.04.24/платик крепежный.ipt
3d party/Mixer 22.04.24/тарелка.ipt
3d party/Mixer 22.04.24/треть-кольцо.ipt
3d party/PCRV071-063SHFA_MS71B5/PCRV071-063SHFA_MS71B5/PCRV071-063SHFA_MS71B5.ipt
3d party/PCRV080-075SHFA_MS80B5/PCRV080-075SHFA_MS80B5/OldVersions/PCRV080-075SHFA_MS80B5.0001.ipt
3d party/PCRV080-075SHFA_MS80B5/PCRV080-075SHFA_MS80B5/PCRV080-075SHFA_MS80B5.ipt
3d party/motor-reductor NMRV040/OldVersions/motor-reductor NMRV040040-18 (78)alc-n.0001.ipt
3d party/motor-reductor NMRV040/OldVersions/motor-reductor NMRV04040-71 B14.0001.ipt
3d party/motor-reductor NMRV040/OldVersions/motor-reductor NMRV040ALBERO_T07114X30NO.0001.ipt
3d party/motor-reductor NMRV040/OldVersions/motor-reductor NMRV040CARCASSA_T-071IC411B1414X30NONO--.0001.ipt
3d party/motor-reductor NMRV040/OldVersions/motor-reductor NMRV040COPRIMORSETTIERA_T071A002.0001.ipt
3d party/motor-reductor NMRV040/OldVersions/motor-reductor NMRV040COPRIVENTOLA_T_071_IC411_NO_-_-_-_-_STD.0001.ipt
3d party/motor-reductor NMRV040/OldVersions/motor-reductor NMRV040FLANGIA_T071B14-.0001.ipt
3d party/motor-reductor NMRV040/OldVersions/motor-reductor NMRV040FU 40FA.0001.ipt
3d party/motor-reductor NMRV040/OldVersions/motor-reductor NMRV040Gear unit 40.0001.ipt
3d party/motor-reductor NMRV040/OldVersions/motor-reductor NMRV040PRESSACAVO_2.0001.ipt
3d party/motor-reductor NMRV040/OldVersions/motor-reductor NMRV040VB 040-14 (14).0001.ipt
3d party/motor-reductor NMRV040/motor-reductor NMRV040.iam
3d party/motor-reductor NMRV040/motor-reductor NMRV040040-18 (78)alc-n.ipt
3d party/motor-reductor NMRV040/motor-reductor NMRV04040-71 B14.ipt
3d party/motor-reductor NMRV040/motor-reductor NMRV040ALBERO_T07114X30NO.ipt
3d party/motor-reductor NMRV040/motor-reductor NMRV040CARCASSA_T-071IC411B1414X30NONO--.ipt
3d party/motor-reductor NMRV040/motor-reductor NMRV040COPRIMORSETTIERA_T071A002.ipt
3d party/motor-reductor NMRV040/motor-reductor NMRV040COPRIVENTOLA_T_071_IC411_NO_-_-_-_-_STD.ipt
3d party/motor-reductor NMRV040/motor-reductor NMRV040FLANGIA_T071B14-.ipt
3d party/motor-reductor NMRV040/motor-reductor NMRV040FU 40FA.ipt
3d party/motor-reductor NMRV040/motor-reductor NMRV040Gear unit 40.ipt
3d party/motor-reductor NMRV040/motor-reductor NMRV040PRESSACAVO_2.ipt
3d party/motor-reductor NMRV040/motor-reductor NMRV040VB 040-14 (14).ipt
3d party/motovario-nmrv_075-1.snapshot.1/NMRV-075/MNRV-075/MNRV-075/MNRV-075.iam
3d party/motovario-nmrv_075-1.snapshot.1/NMRV-075/MNRV-075/MNRV-075/NMRV075.ipt
3d party/motovario-nmrv_075-1.snapshot.1/NMRV-075/NMRV075.SLDPRT
3d party/motovario-nmrv_075-1.snapshot.1/NMRV-075/NMRV075/NMRV075/NMRV075.ipt
ASY Augur motor frame 500.iam
ASY Augur motor frame 500/Frame/Frame 1737036576661.iam
ASY Augur motor frame 500/Frame/ISO 10799-2 40x40x2 1737036577854.ipt
ASY Augur motor frame 500/Frame/ISO 10799-2 40x40x2 1737036577884.ipt
ASY Augur motor frame 500/Frame/ISO 10799-2 40x40x2 1737110128065.ipt
ASY Augur motor frame 500/Frame/ISO 10799-2 40x40x2 1737110289702.ipt
ASY Augur motor frame 500/Frame/OldVersions/Frame 1737036576661.0002.iam
ASY Augur motor frame 500/Frame/OldVersions/ISO 10799-2 40x40x2 1737036577884.0001.ipt
ASY Augur motor frame 500/Frame/OldVersions/Skeleton 1737036576662.0002.ipt
ASY Augur motor frame 500/Frame/Skeleton 1737036576662.ipt
ASY HPR 200 Frame.iam
ASY HPR 200 Frame/Frame/Frame 1730655523663.iam
ASY HPR 200 Frame/Frame/ISO 10799-2 80x80x3 1737030106794.ipt
ASY HPR 200 Frame/Frame/ISO 10799-2 80x80x3 1737030292061.ipt
ASY HPR 200 Frame/Frame/ISO 10799-2 80x80x3 1737031156394.ipt
ASY HPR 200 Frame/Frame/ISO 12633-2 80x80x3 1730740402100.ipt
ASY HPR 200 Frame/Frame/ISO 4019 60x40x2 1730655621970.ipt
ASY HPR 200 Frame/Frame/ISO 4019 80x80x3 1730655527876.ipt
ASY HPR 200 Frame/Frame/OldVersions/Frame 1730655523663.0010.iam
ASY HPR 200 Frame/Frame/OldVersions/ISO 10799-2 80x80x3 1737030106794.0004.ipt
ASY HPR 200 Frame/Frame/OldVersions/ISO 12633-2 80x80x3 1730740402100.0002.ipt
ASY HPR 200 Frame/Frame/OldVersions/ISO 4019 80x80x3 1730655527876.0001.ipt
ASY HPR 200 Frame/Frame/OldVersions/Skeleton 1730655523664.0007.ipt
ASY HPR 200 Frame/Frame/Skeleton 1730655523664.ipt
ASY HPR 300 Frame human.iam
ASY HPR 300 Frame human/Frame/Frame 1730661229799.iam
ASY HPR 300 Frame human/Frame/ISO 4019 60x40x2 1730661231430.ipt
ASY HPR 300 Frame human/Frame/ISO 4019 60x40x2 1730661231465.ipt
ASY HPR 300 Frame human/Frame/ISO 4019 60x40x2 1730661231499.ipt
ASY HPR 300 Frame human/Frame/OldVersions/Frame 1730661229799.0004.iam
ASY HPR 300 Frame human/Frame/OldVersions/Skeleton 1730661229800.0002.ipt
ASY HPR 300 Frame human/Frame/Skeleton 1730661229800.ipt
ASY HPR 340 hopper main tube.iam
ASY HPR 600 Feeder head.iam
ASY NDM-VOS_powder_hopper (2).iam
ASY NDM-VOS_powder_hopper.iam
ASY NDM-VOS_powder_hopper.idw
ASY NVPH-200 shredder shaft full.iam
ASY NVPH-300 hopper.iam
ASY NVPH-400 shredder.iam
ASY NVPH-466 joint flange.iam
ASY Лестница перила.iam
ASY Лестница перила/Frame/Frame 1737567600707.iam
ASY Лестница перила/Frame/ISO 10799-2 20x20x2 1737970147054.ipt
ASY Лестница перила/Frame/ISO 4019 40x20x2 1737567602209.ipt
ASY Лестница перила/Frame/ISO 4019 40x20x2 1737567647741.ipt
ASY Лестница перила/Frame/ISO 4019 40x20x2 1737567647798.ipt
ASY Лестница перила/Frame/ISO 4019 40x20x2 1737567647855.ipt
ASY Лестница перила/Frame/ISO 4019 40x20x2 1737567679058.ipt
ASY Лестница перила/Frame/ISO 4019 40x20x2 1737567679117.ipt
ASY Лестница перила/Frame/ISO 4019 40x20x2 1737568162013.ipt
ASY Лестница перила/Frame/ISO 4019 40x20x2 1737568162070.ipt
ASY Лестница перила/Frame/ISO 4019 40x20x2 1737568162126.ipt
ASY Лестница перила/Frame/ISO 4019 40x20x2 1737568162189.ipt
ASY Лестница перила/Frame/ISO 4019 40x20x2 1737568195724.ipt
ASY Лестница перила/Frame/ISO 4019 40x20x2 1737568195782.ipt
ASY Лестница перила/Frame/ISO 4019 40x20x2 1737568195839.ipt
ASY Лестница перила/Frame/ISO 4019 40x20x2 1737568195896.ipt
ASY Лестница перила/Frame/ISO 4019 40x20x2 1737568739619.ipt
ASY Лестница перила/Frame/OldVersions/ISO 4019 40x20x2 1737567647798.0002.ipt
ASY Лестница перила/Frame/OldVersions/ISO 4019 40x20x2 1737567647855.0002.ipt
ASY Лестница перила/Frame/OldVersions/ISO 4019 40x20x2 1737567679058.0002.ipt
ASY Лестница перила/Frame/OldVersions/ISO 4019 40x20x2 1737567679117.0002.ipt
ASY Лестница перила/Frame/OldVersions/ISO 4019 40x20x2 1737568162013.0001.ipt
ASY Лестница перила/Frame/OldVersions/ISO 4019 40x20x2 1737568162070.0001.ipt
ASY Лестница перила/Frame/OldVersions/ISO 4019 40x20x2 1737568162126.0001.ipt
ASY Лестница перила/Frame/OldVersions/ISO 4019 40x20x2 1737568162189.0001.ipt
ASY Лестница перила/Frame/OldVersions/ISO 4019 40x20x2 1737568195724.0001.ipt
ASY Лестница перила/Frame/OldVersions/ISO 4019 40x20x2 1737568195782.0001.ipt
ASY Лестница перила/Frame/OldVersions/ISO 4019 40x20x2 1737568195839.0001.ipt
ASY Лестница перила/Frame/OldVersions/ISO 4019 40x20x2 1737568195896.0001.ipt
ASY Лестница перила/Frame/OldVersions/ISO 4019 40x20x2 1737568739619.0001.ipt
ASY Лестница перила/Frame/Skeleton 1737567600708.ipt
ASY Лестница.iam
ASY Рама №1 платформа.iam
ASY Рама №1 платформа.ipt
ASY Рама №1 платформа/Frame/ASY Рама №2 платформа.iam
ASY Рама №1 платформа/Frame/ASY Рама №2 платформа.ipt
ASY Рама №1 платформа/Frame/Frame 1737397310968.iam
ASY Рама №1 платформа/Frame/ISO 4019 40x40x2 1737397313212.ipt
ASY Рама №1 платформа/Frame/ISO 4019 40x40x2 1737397360974.ipt
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
