Glebjack/NDM-VOS_powder_hopper/вал.pdf

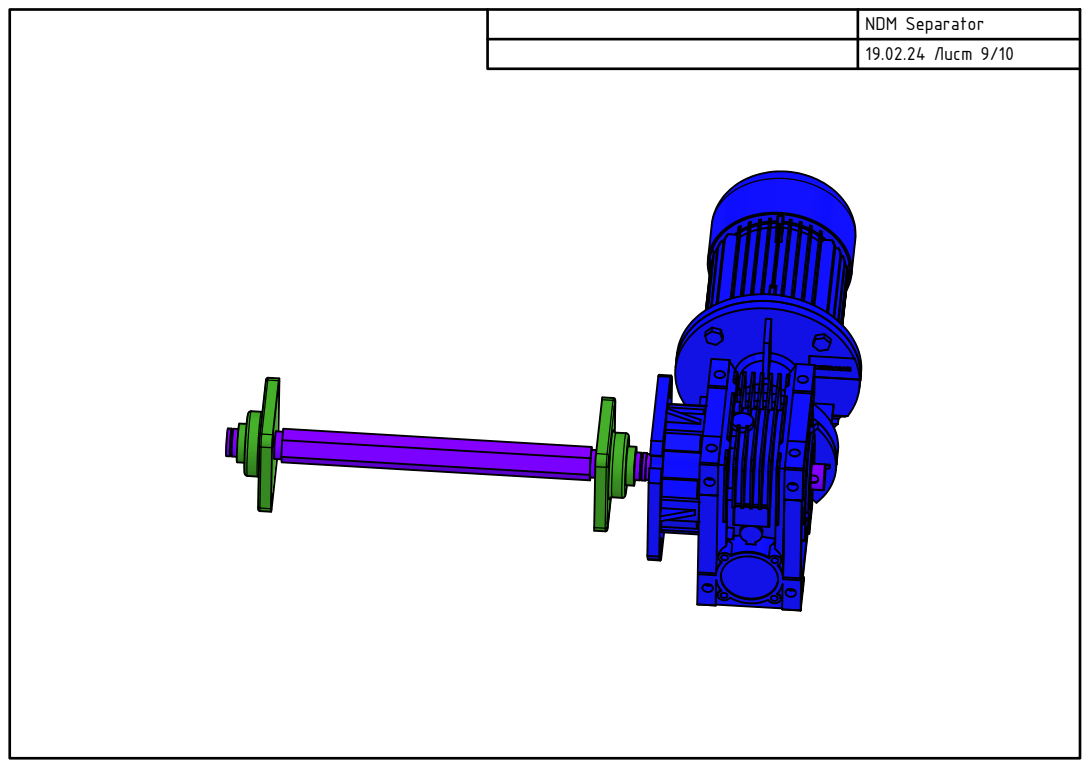
[picture p171: page 1]

NDM Separator
19.02.24 Лист 9/10

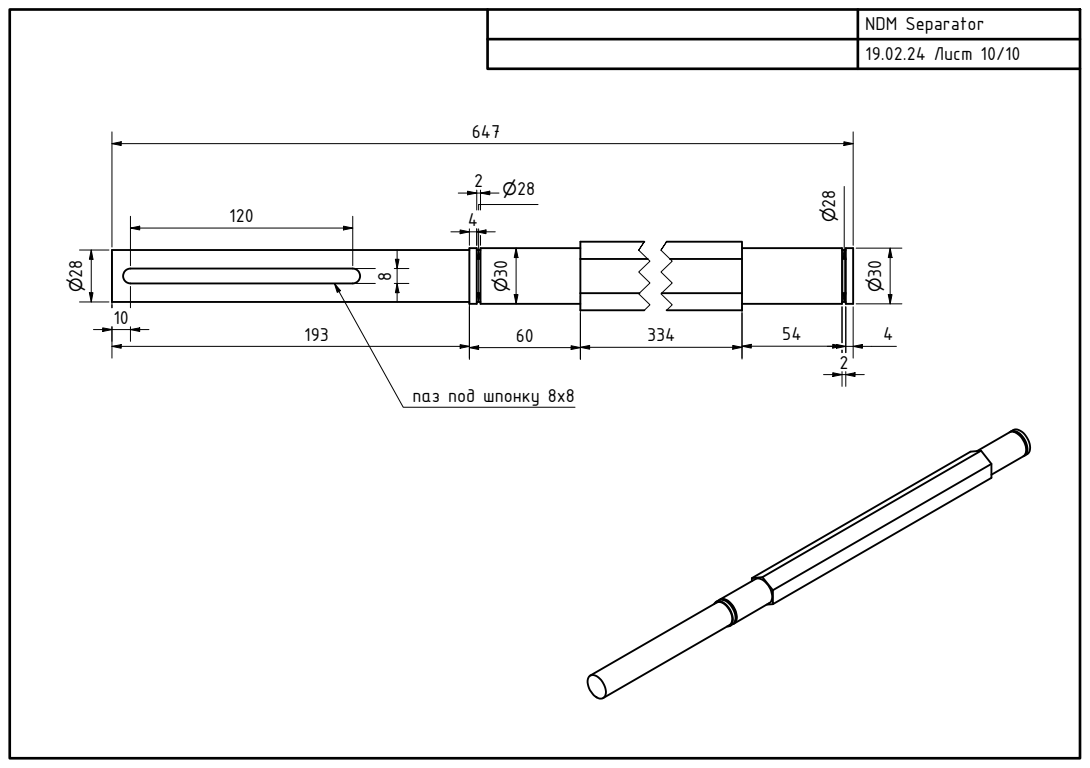
[picture p172: page 2]

N D M S e p a r a t o r
1 9.0 2.2 4 Л и с т 1 0 / 1 0
