Glebjack/NDM-VOS_powder_hopper/вал1.pdf

NDM Separator
19.02.24 Лист 9/10

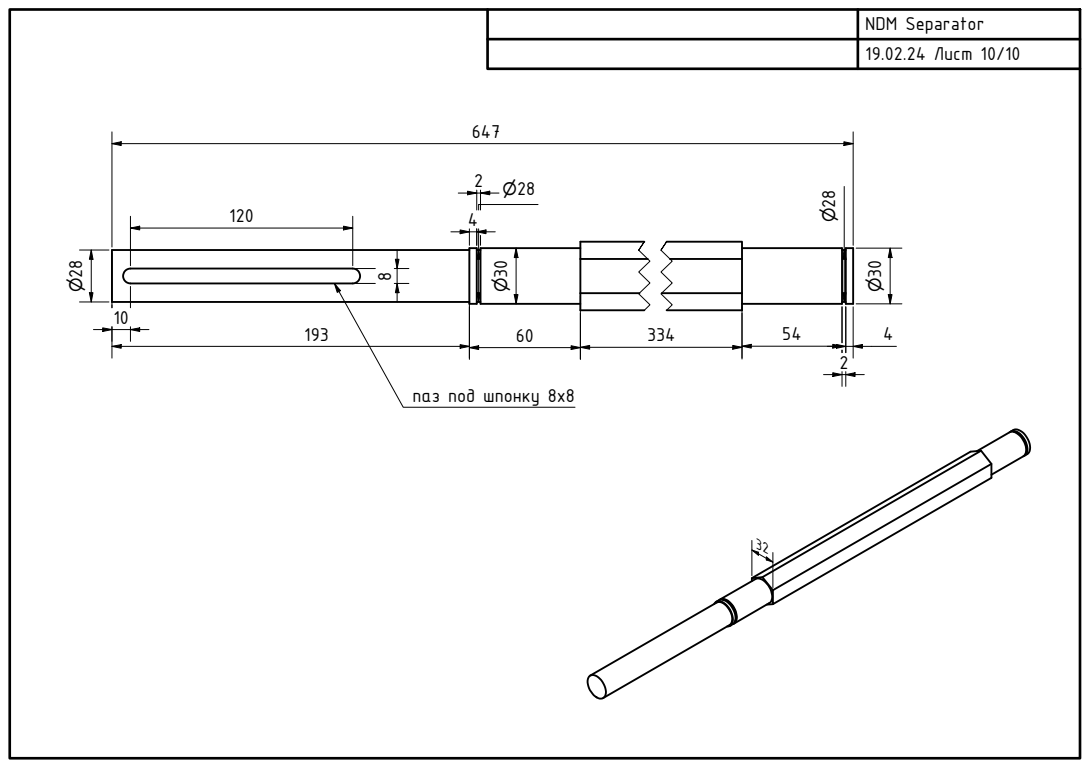
[picture p173: page 2]

NDM Separator
19.02.24 Лист 10/10

паз под шпонку 8х8
