Glebjack/NDM-VOS_powder_hopper/ASY NDM-VOS_powder_hopper.pdf

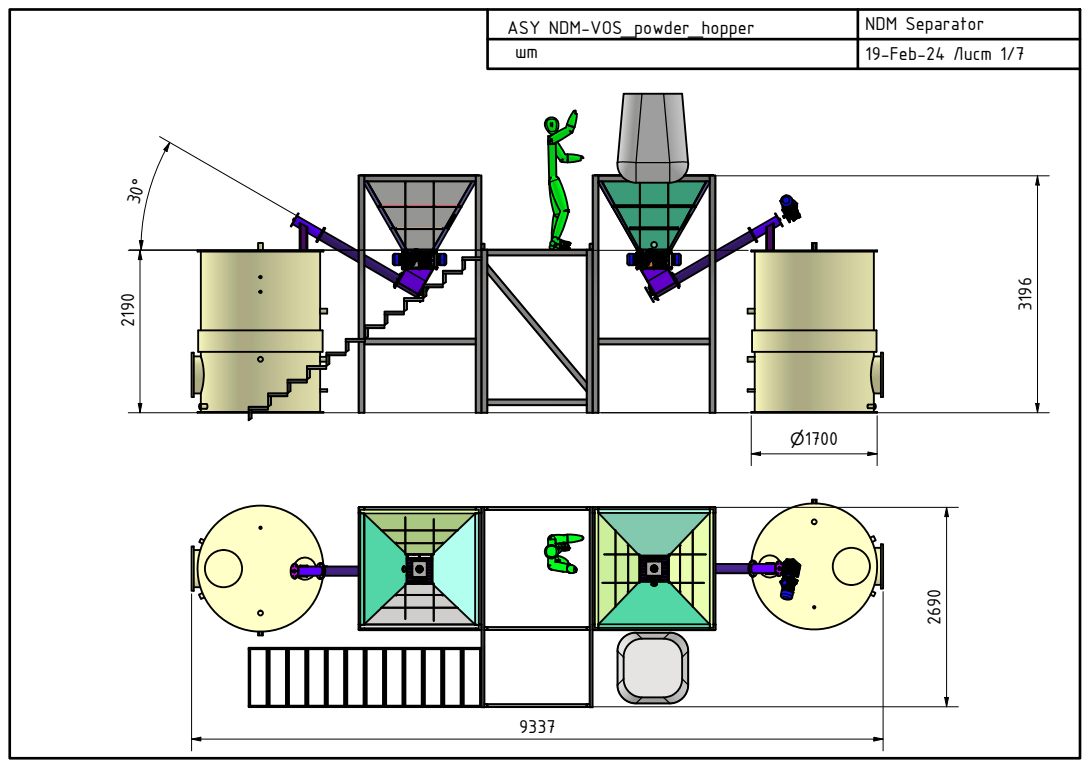
[picture p174: page 1]
NDM Separator; 19-Feb-24 Лист 1/7; ASY NDM-VOS_powder_hopper

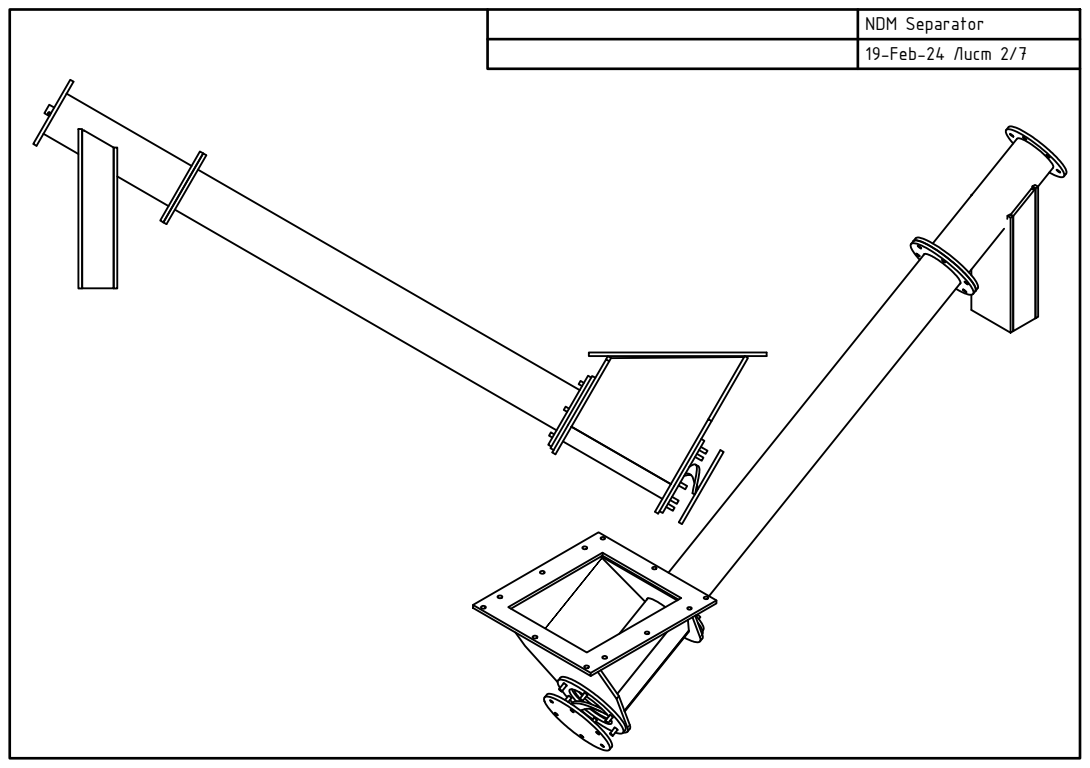
[picture p175: page 2]

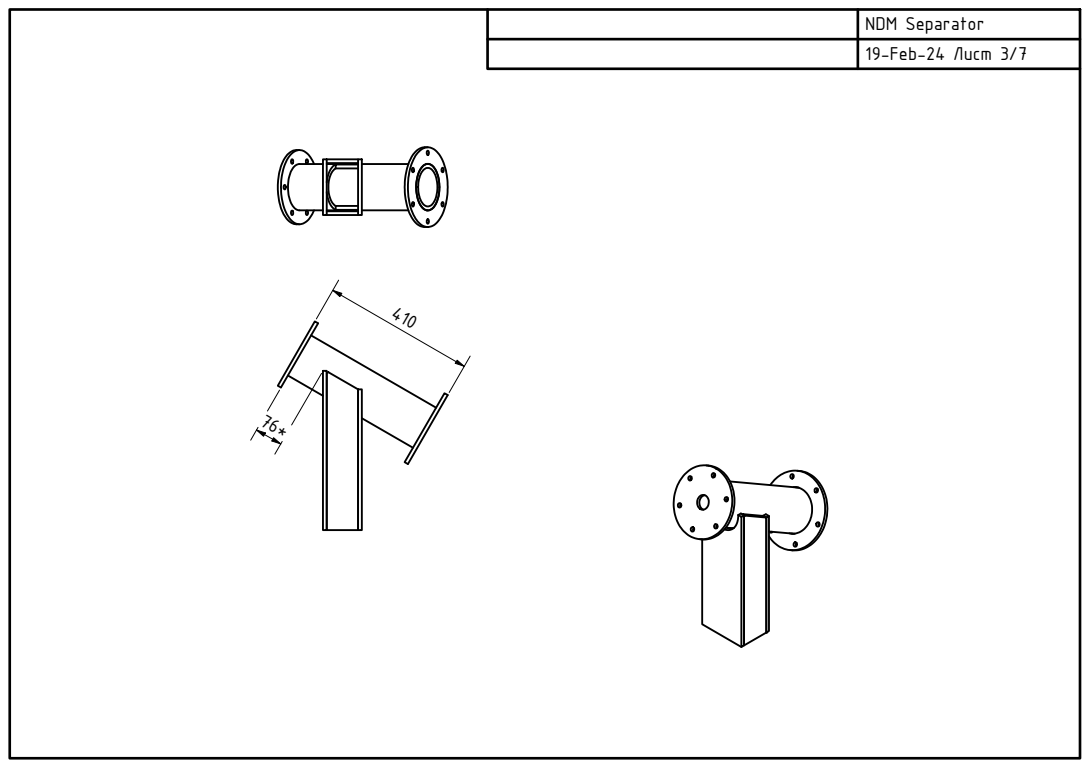
[picture p176: page 3]

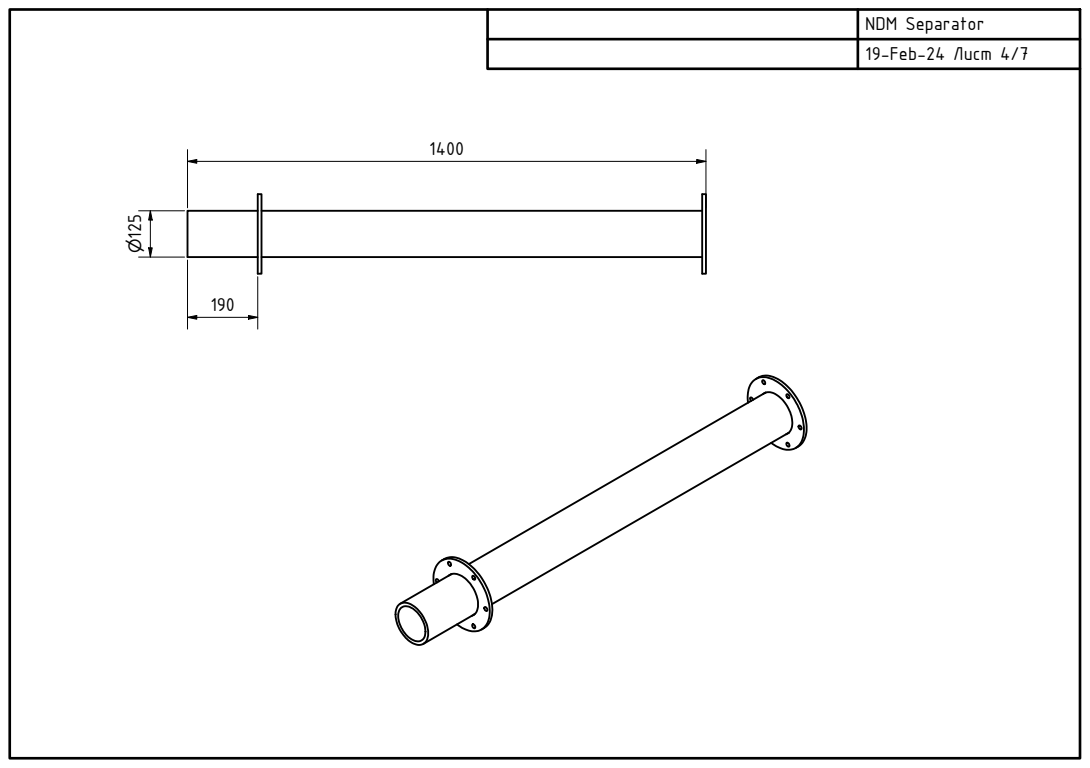
[picture p177: page 4]

N D M S e p a r a t o r
1 9 -F e b -2 4 Л и с т 4 / 7

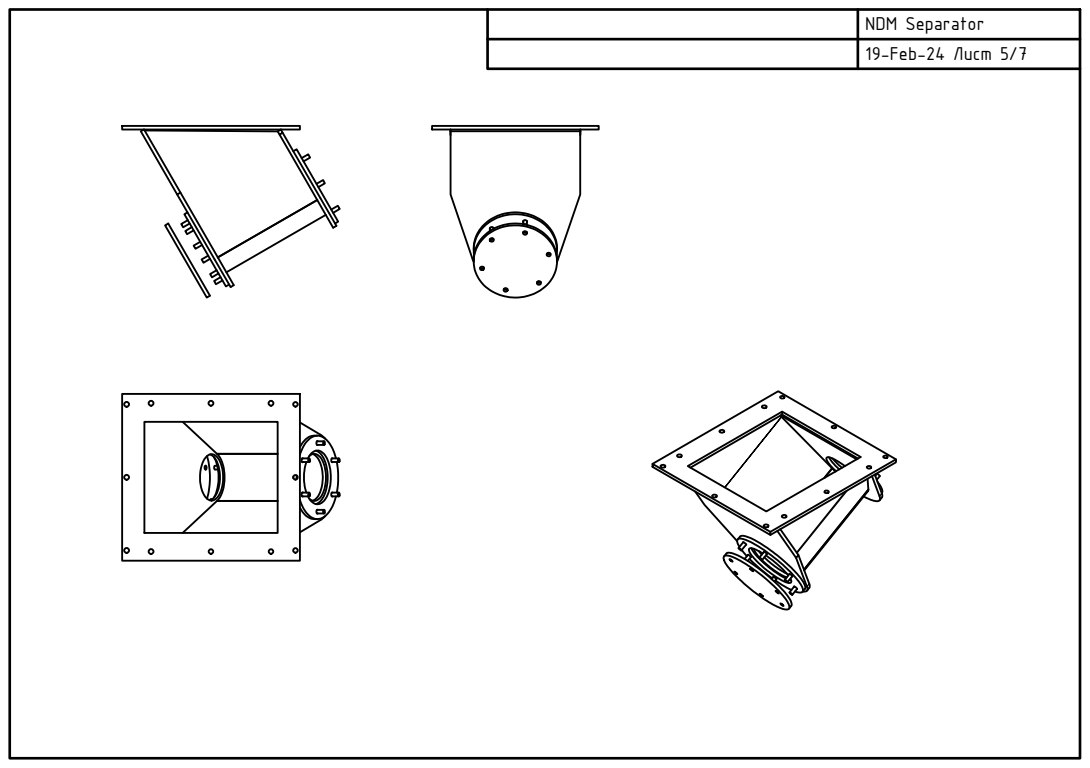
[picture p178: page 5]

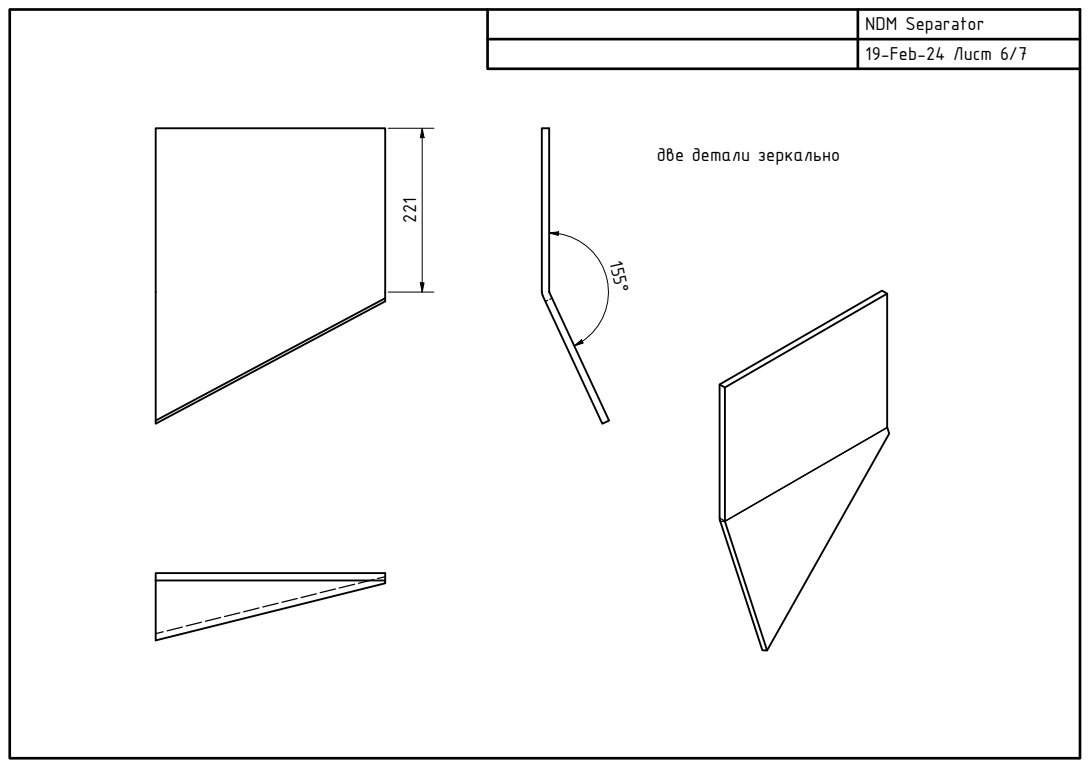
[picture p179: page 6]

две детали зеркально

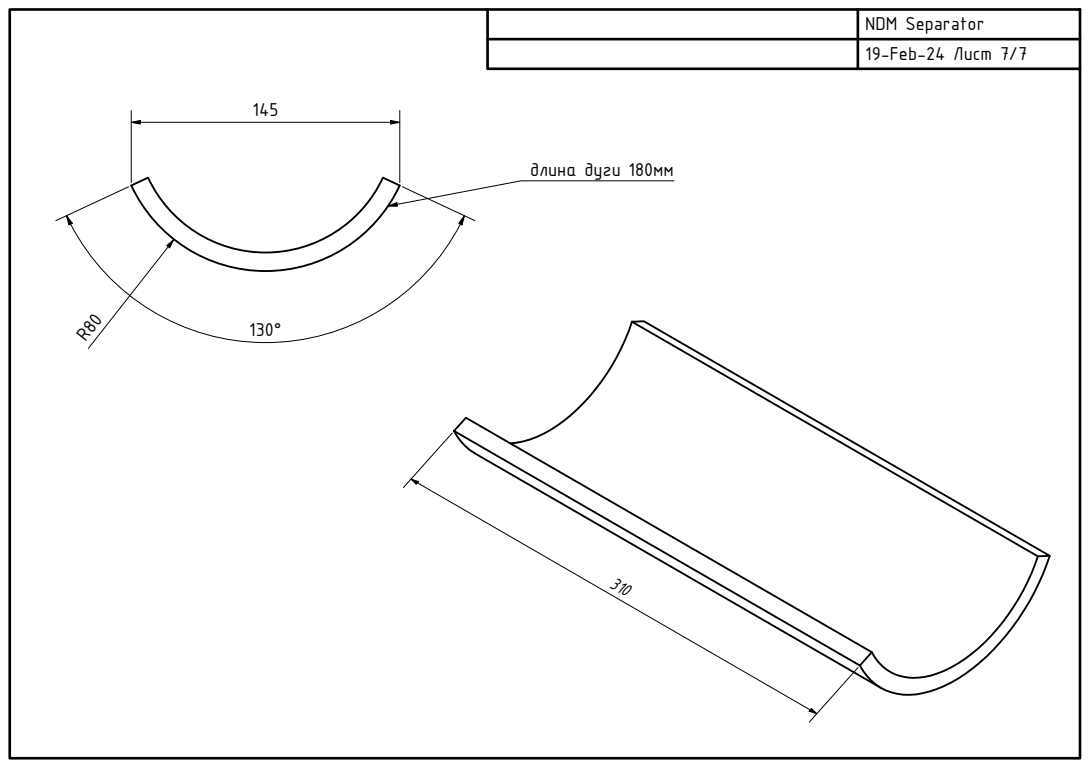
[picture p180: page 7]
длина дуги 180мм
