Glebjack/NDM-VOS_powder_hopper/РАЗГРУЗЧИК 2.377.06.00.00 (2)/2.377.06.00.00_Разгрузчик — копия.PDF

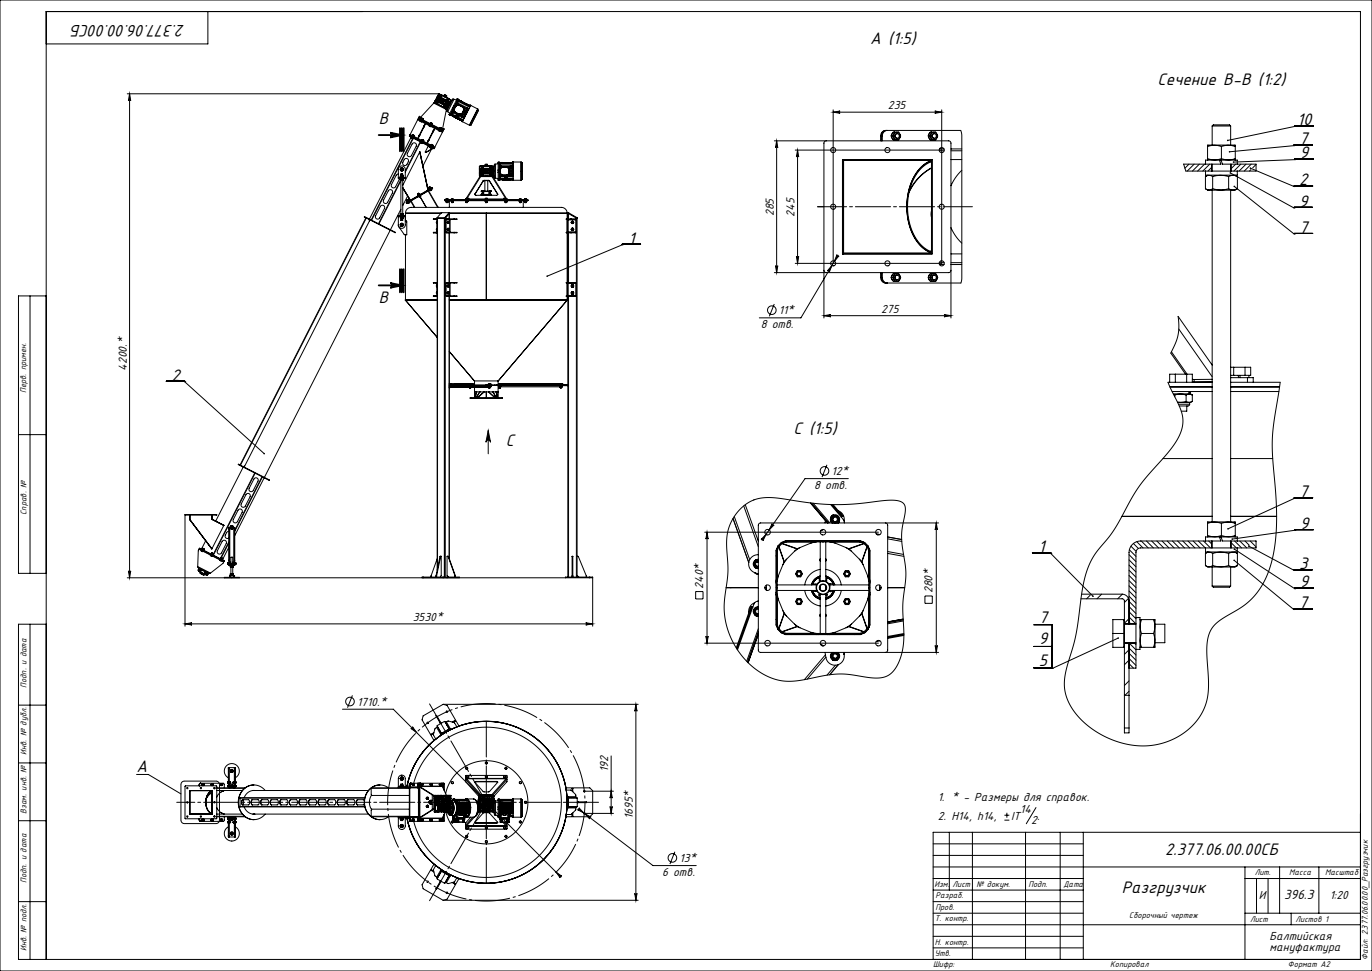
[picture p181: page 1]
6 отв.; 8 отв.; Сечение B-B (1:2); Инв. № подл.; Формат A2; Файл: 2.377.06.00.00_Разгрузчик; Шифр:; Версия 3

Подп. и дата Взам. инв. № Инв. № дубл. Подп. и дата Перв. примен. Справ. №

1. * - Размеры для справок.

Разгрузчик Сборочный чертеж | Лит. | Масса | Масштаб

Изм. Лист № докум. | Подп. | Дата | | | И | | 396.3 | 1:20
Разраб.
Пров.
Т. контр. | | | Лист | Листов 1

Балтийская мануфактура

Н. контр.
Утв.

Документация

A2 | 2.377.06.00.00СБ | Сборочный чертеж
| | Сборочные единицы
A4 | 1 | 2.377.06.00.10 | Бункер | 1
A4 | 2 | 2.377.06.01.00 | Транспортер | 1

Детали

A4 | 3 | 2.377.06.01.21 | Уолок | 2
| | | Стандартные изделия
4 | Болт М10х25 DIN 933 | 9
5 | Болт М16х35 DIN 933 | 1
6 | Гайка М10 DIN 934 | 9
7 | Гайка М16 DIN 934 | 10
8 | Шайба гр. М10 DIN127 | 9
9 | Шайба гр. М16 DIN127 | 9
10 | Штанга М16х400 DIN975 | 2

Инв. № подл. Подп. и дата Взам. инв. № Инв. № дубл. Подп. и дата Перв. примен. Справ. №

Формат А4

2.377.06.00.00

Копировал

Изм. Лист | № докум. | Подп. | Дата
| Разраб. | | | Разгрузчик | Лит. | Лист | Листов
Пров. | | | | И | | | 1

Н. контр.
Утв.

Файл: 2.377.06.00.00_Разгрузчик

Шифр: | Версия 3

Формат
Зона
Поз.
Обозначение | Наименование

Кол.

Приме-чание
