Glebjack/NDM-VOS_powder_hopper/РАЗГРУЗЧИК 2.377.06.00.00 (2)/2.377.06.00.01_Вал — копия.PDF

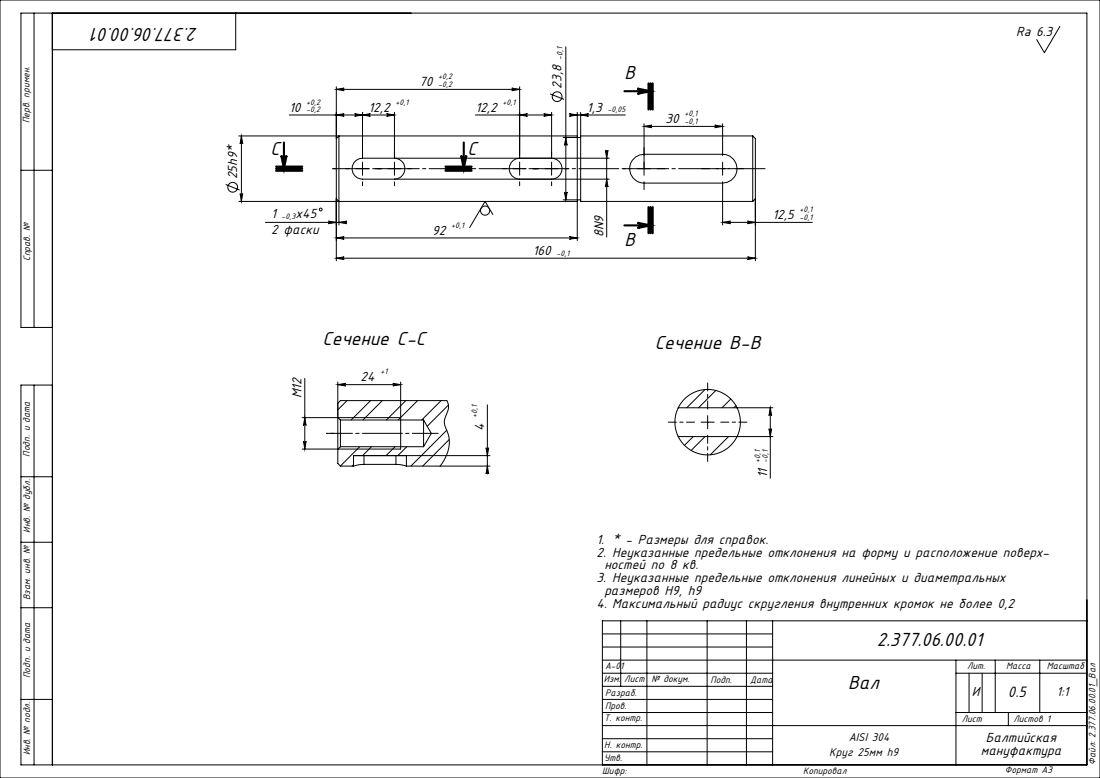
[picture p182: page 1]
1 -0,3x45 2 фаски; Сечение B-B; Сечение C-C; Формат A3; Файл: 2.377.06.00.01_Вал; Шифр:; Версия 3

Инв. № подл. Подп. и дата Взам. инв. № Инв. № дубл. Подп. и дата Перв. примен. Справ. №

1. * - Размеры для справок.
2. Неуказанные предельные отклонения на форму и расположение поверх-
ностей по 8 кв.
3. Неуказанные предельные отклонения линейных и диаметральных
размеров Н9, h9
4. Максимальный радиус скругления внутренних кромок не более 0,2

А-01 | | | Вал | Лит. | Масса | Масштаб
Изм. Лист № докум. | Подп. | Дата | | | И | | 0.5 | 1:1
Разраб.
Пров.
Т. контр. | | | Лист | Листов 1

AISI 304 Круг 25мм h9 | Балтийская мануфактура

Н. контр.
Утв.
