Glebjack/NDM-VOS_powder_hopper/РАЗГРУЗЧИК 2.377.06.00.00 (2)/2.377.06.00.02_Втулка — копия.PDF

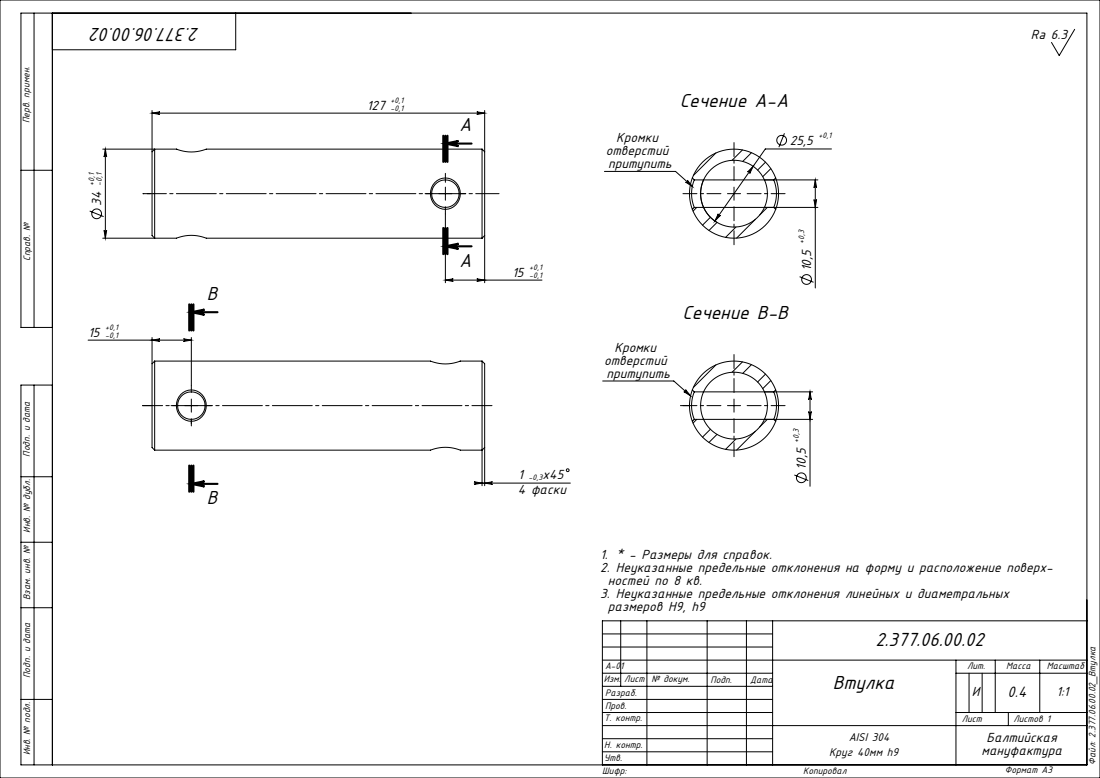
[picture p183: page 1]
4 фаски; Сечение A-A; Сечение B-B; Формат A3; Файл: 2.377.06.00.02_Втулка; Шифр:; Версия 3

Инв. № подл. Подп. и дата Взам. инв. № Инв. № дубл. Подп. и дата Перв. примен. Справ. №

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

А-01 | | | Втулка | Лит. | Масса | Масштаб
Изм. Лист № докум. | Подп. | Дата | | | И | | 0.4 | 1:1
Разраб.
Пров.
Т. контр. | | | Лист | Листов 1

AISI 304 Круг 40мм h9 | Балтийская мануфактура

Н. контр.
Утв.
