Glebjack/NDM-VOS_powder_hopper/РАЗГРУЗЧИК 2.377.06.00.00 (2)/2.377.06.00.03_Вал — копия.PDF

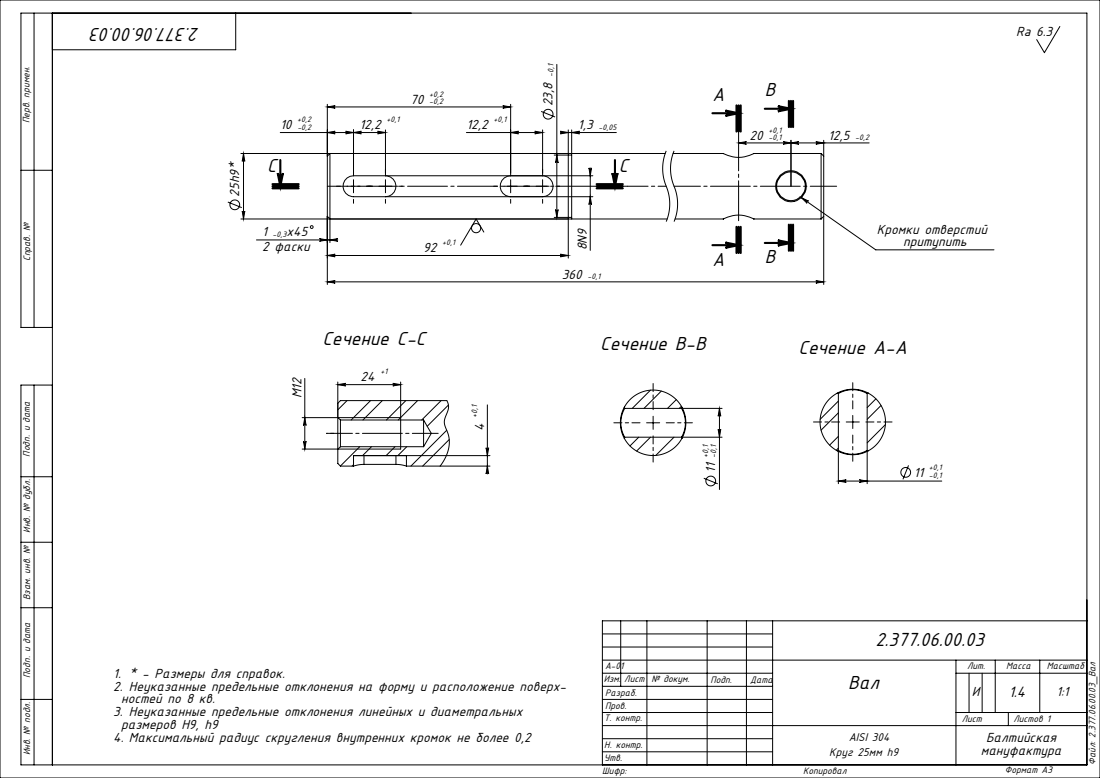
[picture p184: page 1]
1 -0,3x45 2 фаски; Кромки отверстий; Сечение B-B; Сечение C-C; Сечение A-A; 4. Максимальный радиус скругления внутренних кромок не более 0,2; Балтийская; Формат A3; Файл: 2.377.06.00.03_Вал; Шифр:; Версия 3

Инв. № подл. Подп. и дата Взам. инв. № Инв. № дубл. Подп. и дата Перв. примен. Справ. №

А-01 | | | Вал | Лит. | Масса | Масштаб
Изм. Лист № докум. | Подп. | Дата | | | И | | 1.4 | 1:1
Разраб.
Пров.
Т. контр. | | | Лист | Листов 1

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

AISI 304 Круг 25мм h9 | мануфактура

Н. контр.
Утв.
