Glebjack/NDM-VOS_powder_hopper/РАЗГРУЗЧИК 2.377.06.00.00 (2)/2.377.06.00.09_Кронштейн — копия.PDF

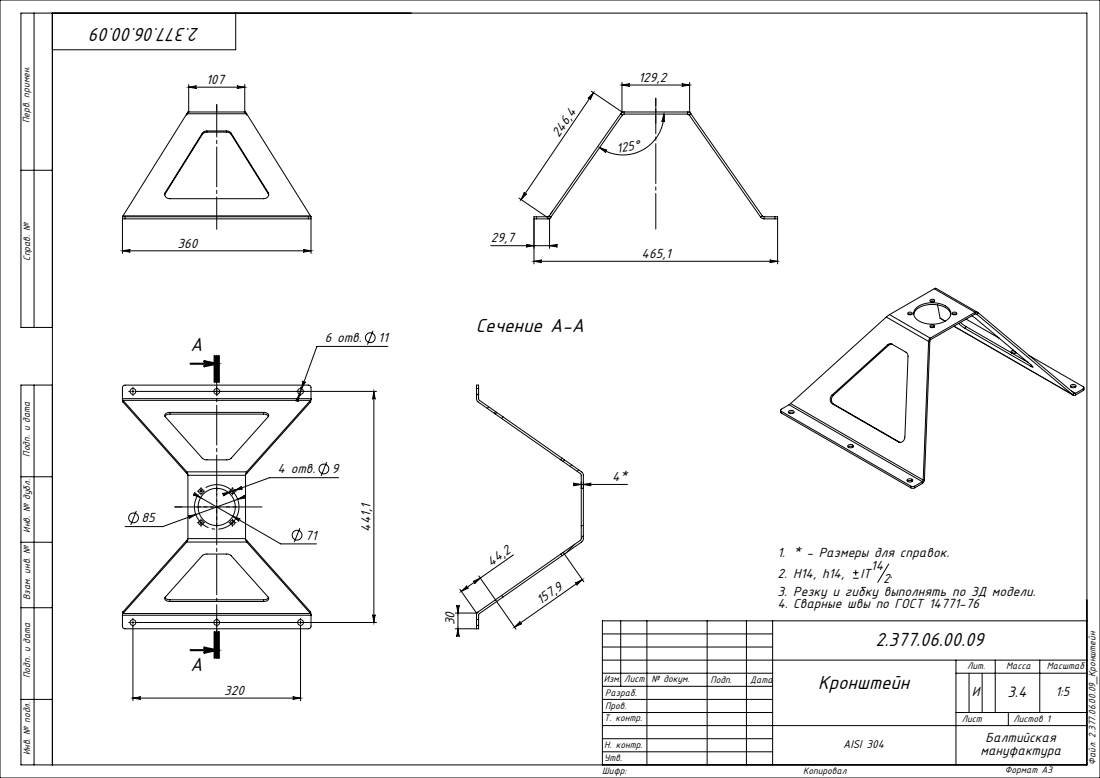
[picture p186: page 1]
4 отв. 9; 6 отв. 11; Сечение A-A; Инв. № подл.; Формат A3; Файл: 2.377.06.00.09_Кронштейн; Шифр:; Версия 3

Подп. и дата Взам. инв. № Инв. № дубл. Подп. и дата Перв. примен. Справ. №

1. * - Размеры для справок.
3. Резку и гибку выполнять по 3Д модели.
4. Сварные швы по ГОСТ 14771-76

Кронштейн | Лит. | Масса | Масштаб

Изм. Лист № докум. | Подп. | Дата | | | И | | 3.4 | 1:5
Разраб.
Пров.
Т. контр. | | | Лист | Листов 1

AISI 304 | Балтийская мануфактура

Н. контр.
Утв.
