Glebjack/NDM-VOS_powder_hopper/РАЗГРУЗЧИК 2.377.06.00.00 (2)/2.377.06.01.01_Труба — копия.PDF

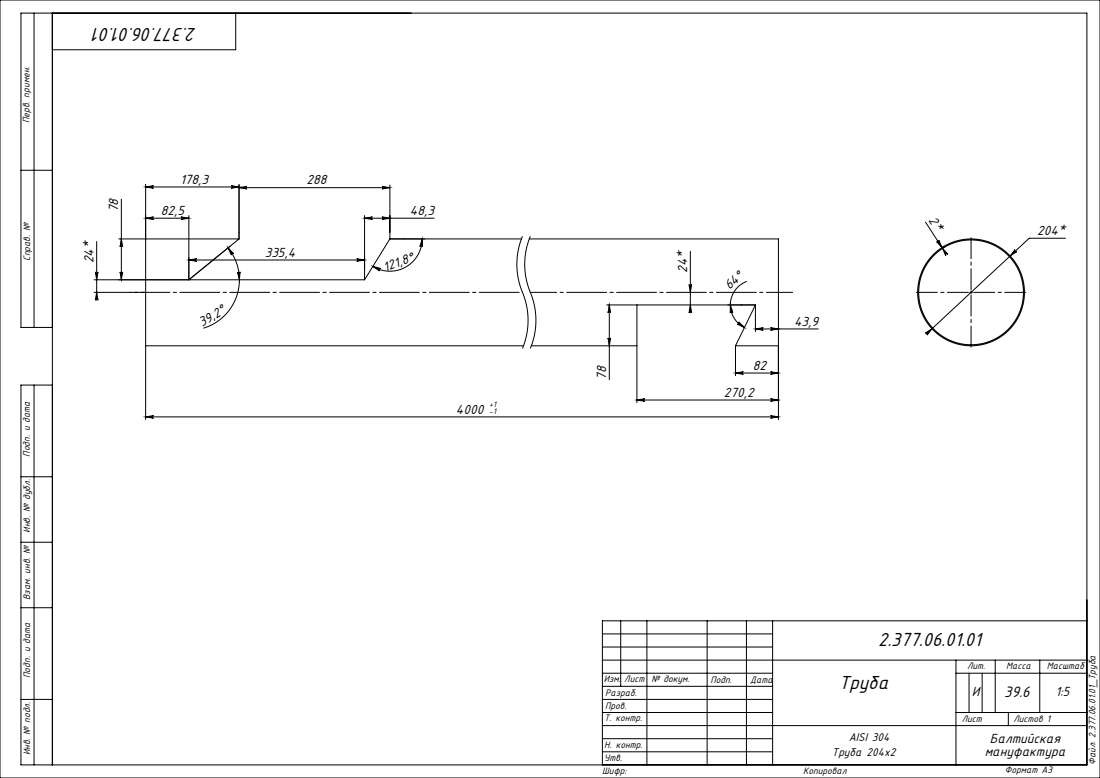
[picture p187: page 1]
Инв. № подл.; Формат A3; Файл: 2.377.06.01.01_Труба; Шифр:; Версия 3

Подп. и дата Взам. инв. № Инв. № дубл. Подп. и дата Перв. примен. Справ. №

Труба | Лит. | Масса | Масштаб

Изм. Лист № докум. | Подп. | Дата | | | И | | 39.6 | 1:5
Разраб.
Пров.
Т. контр. | | | Лист | Листов 1

AISI 304 Труба 204х2 | Балтийская мануфактура

Н. контр.
Утв.
