Glebjack/NDM-VOS_powder_hopper/РАЗГРУЗЧИК 2.377.06.00.00 (2)/2.377.06.01.02_Фланец — копия.PDF

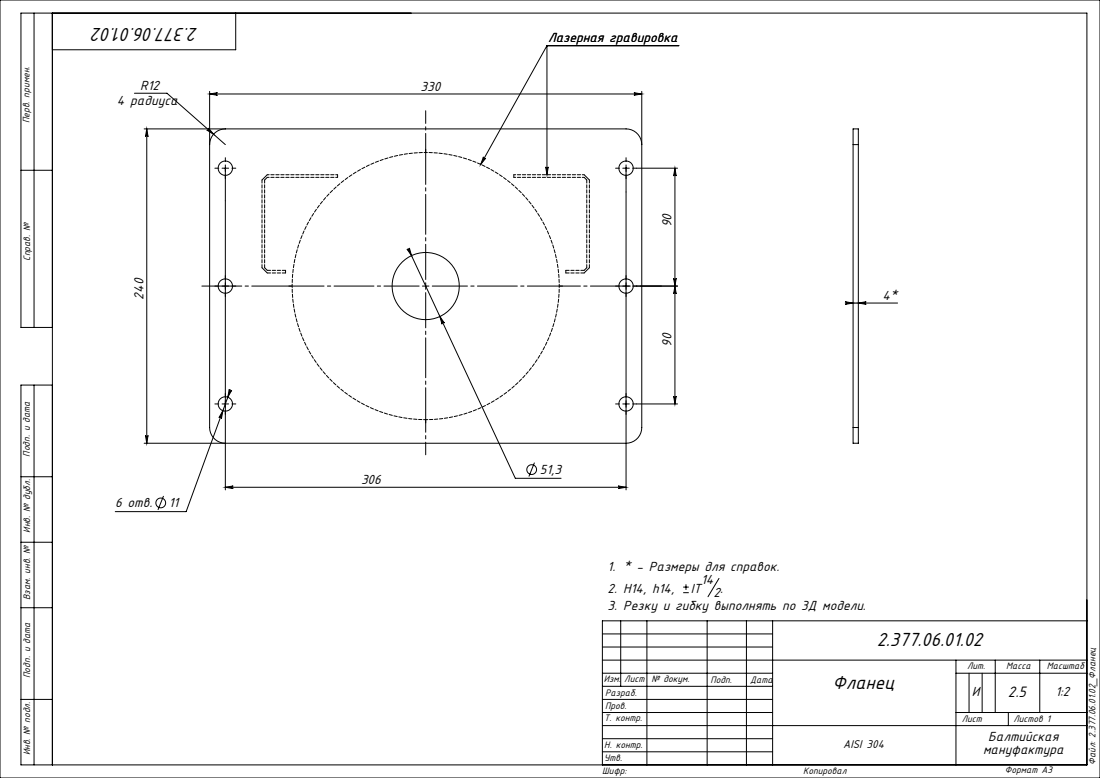
[picture p188: page 1]
4 радиуса; 6 отв. 11; Лазерная гравировка; Инв. № подл.; Формат A3; Файл: 2.377.06.01.02_Фланец; Шифр:; Версия 3

Подп. и дата Взам. инв. № Инв. № дубл. Подп. и дата Перв. примен. Справ. №

1. * - Размеры для справок.
3. Резку и гибку выполнять по 3Д модели.

Фланец | Лит. | Масса | Масштаб

Изм. Лист № докум. | Подп. | Дата | | | И | | 2.5 | 1:2
Разраб.
Пров.
Т. контр. | | | Лист | Листов 1

AISI 304 | Балтийская мануфактура

Н. контр.
Утв.
