Glebjack/NDM-VOS_powder_hopper/РАЗГРУЗЧИК 2.377.06.00.00 (2)/2.377.06.01.04_Стенка — копия.PDF

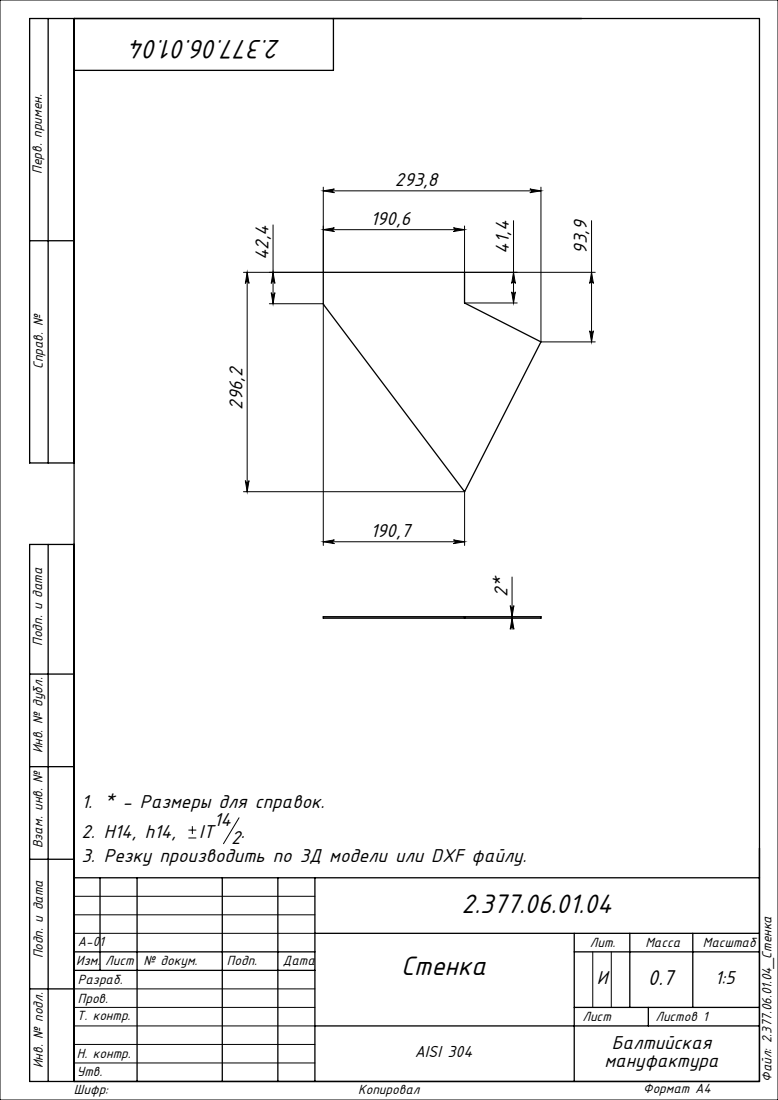
[picture p190: page 1]
Формат A4; Файл: 2.377.06.01.04_Стенка; Шифр:; Версия 3

Инв. № подл. Подп. и дата Взам. инв. № Инв. № дубл. Подп. и дата Перв. примен. Справ. №

1. * - Размеры для справок.
3. Резку производить по 3Д модели или DXF файлу.

А-01 | | | | Стенка | Лит. | Масса | Масштаб
Изм. Лист № докум. | | Подп. | Дата | | | И | | 0.7 | 1:5
Разраб.
Пров.
Т. контр. | | | | Лист | Листов 1

AISI 304 | Балтийская мануфактура

Н. контр.
Утв.
