Glebjack/NDM-VOS_powder_hopper/РАЗГРУЗЧИК 2.377.06.00.00 (2)/2.377.06.01.07_Фланец — копия.PDF

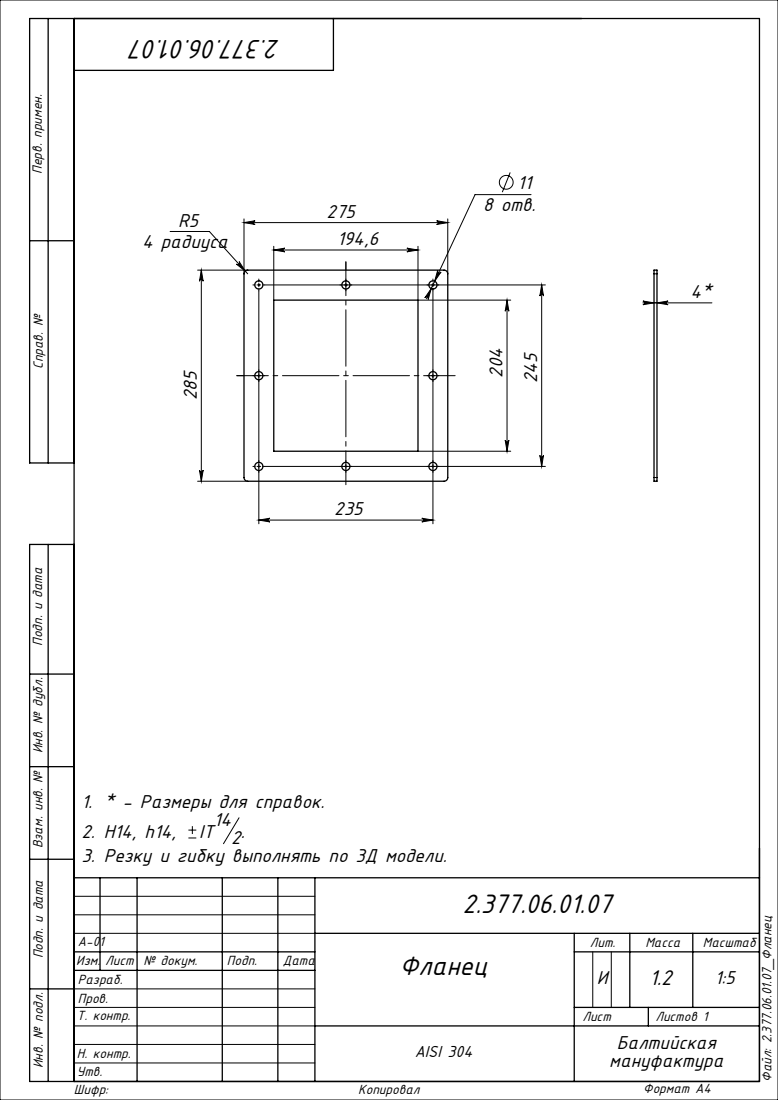
[picture p192: page 1]
8 отв.; 4 радиуса; Инв. № подл.; Формат A4; Файл: 2.377.06.01.07_Фланец; Шифр:; Версия 3

Подп. и дата Взам. инв. № Инв. № дубл. Подп. и дата Перв. примен. Справ. №

1. * - Размеры для справок.
3. Резку и гибку выполнять по 3Д модели.

А-01 | | | | Фланец | Лит. | Масса | Масштаб
Изм. Лист № докум. | | Подп. | Дата | | | И | | 1.2 | 1:5
Разраб.
Пров.
Т. контр. | | | | Лист | Листов 1

AISI 304 | Балтийская мануфактура

Н. контр.
Утв.
