Glebjack/NDM-VOS_powder_hopper/РАЗГРУЗЧИК 2.377.06.00.00 (2)/2.377.06.01.08_Профиль — копия.PDF

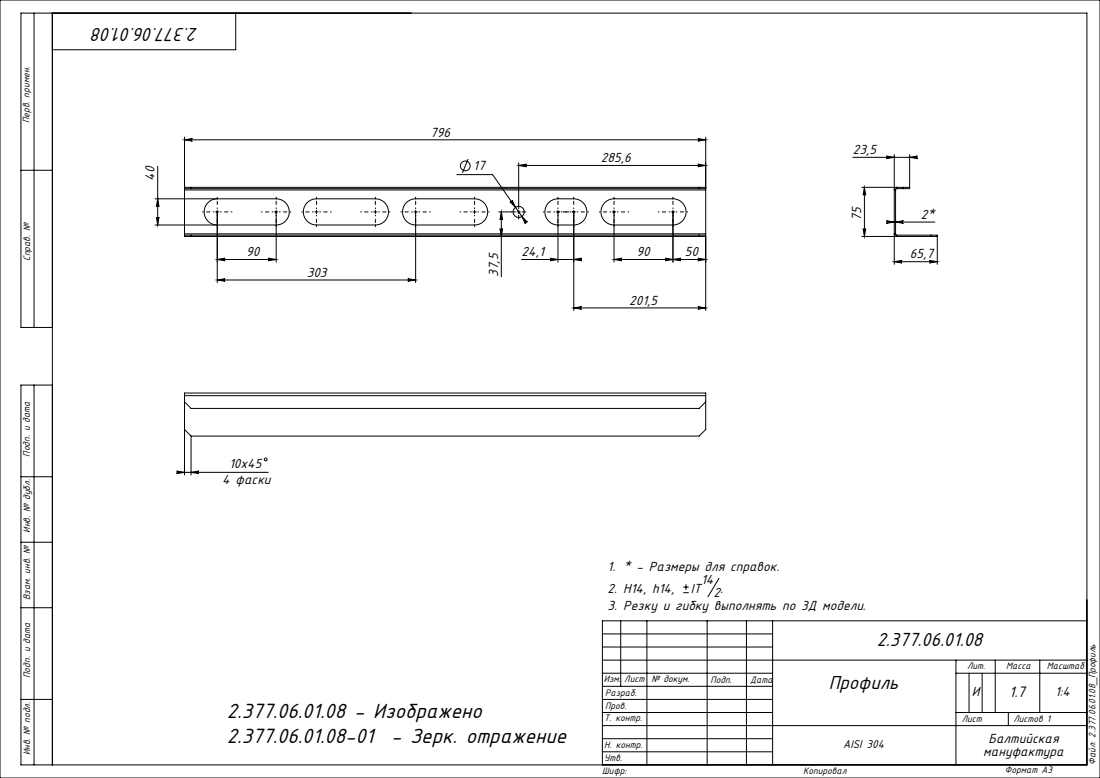
[picture p193: page 1]
4 фаски; 2.377.06.01.08 - Изображено 2.377.06.01.08-01 - Зерк. отражение; Формат A3; Файл: 2.377.06.01.08_Профиль; Шифр:; Версия 3

Инв. № подл. Подп. и дата Взам. инв. № Инв. № дубл. Подп. и дата Перв. примен. Справ. №

1. * - Размеры для справок.
3. Резку и гибку выполнять по 3Д модели.

Профиль | Лит. | Масса | Масштаб

Изм. Лист № докум. | Подп. | Дата | | | И | | 1.7 | 1:4
Разраб.
Пров.
Т. контр. | | | Лист | Листов 1

AISI 304 | Балтийская мануфактура

Н. контр.
Утв.
