Glebjack/NDM-VOS_powder_hopper/РАЗГРУЗЧИК 2.377.06.00.00 (2)/2.377.06.01.09_Профиль — копия.PDF

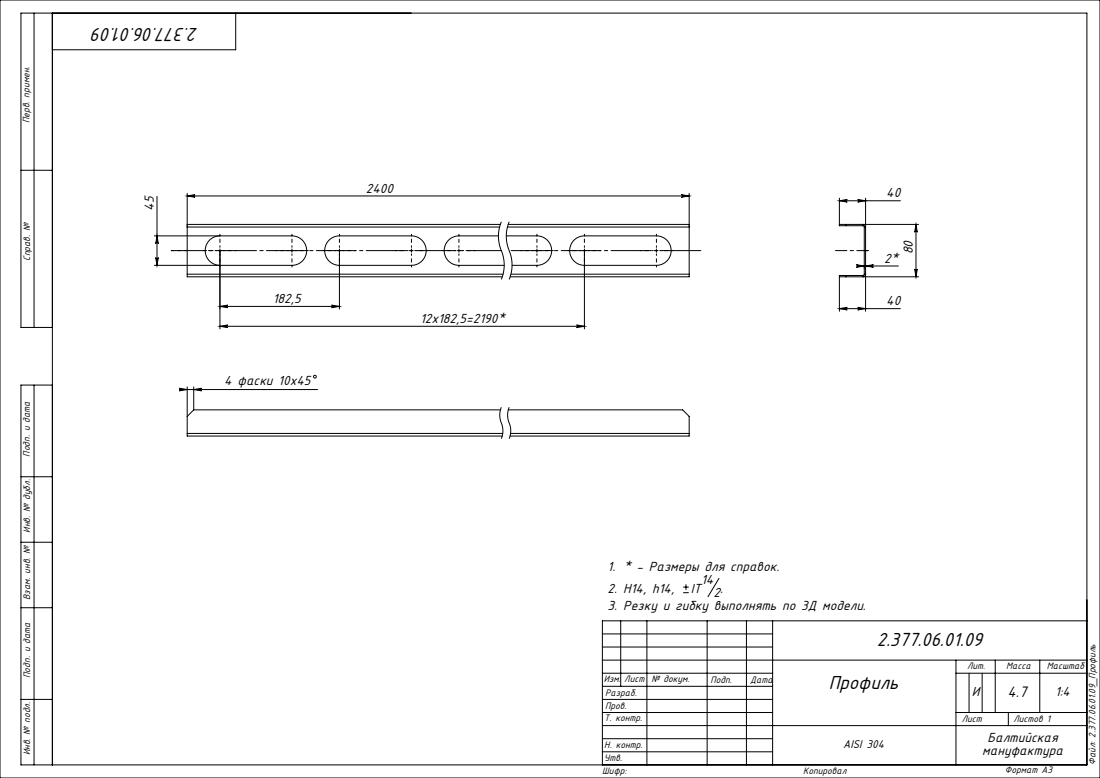
[picture p194: page 1]
4 фаски 10x45; Инв. № подл.; Формат A3; Файл: 2.377.06.01.09_Профиль; Шифр:; Версия 3

Подп. и дата Взам. инв. № Инв. № дубл. Подп. и дата Перв. примен. Справ. №

1. * - Размеры для справок.
3. Резку и гибку выполнять по 3Д модели.

Профиль | Лит. | Масса | Масштаб

Изм. Лист № докум. | Подп. | Дата | | | И | | 4.7 | 1:4
Разраб.
Пров.
Т. контр. | | | Лист | Листов 1

AISI 304 | Балтийская мануфактура

Н. контр.
Утв.
