Glebjack/NDM-VOS_powder_hopper/РАЗГРУЗЧИК 2.377.06.00.00 (2)/2.377.06.01.10_Корпус — копия.PDF

Документация

A2 | 2.377.06.01.10СБ | Сборочный чертеж
| | Детали
A4 | 1 | 2.377.05.03.04 | Труба | 1
A4 | 2 | 2.377.05.03.05 | Фланец | 1
A4 | 3 | 2.377.05.03.06 | Кольцо | 1
A3 | 4 | 2.377.06.01.01 | Труба | 1
A3 | 5 | 2.377.06.01.02 | Фланец | 1
A4 | 6 | 2.377.06.01.04 | Стенка | 2
A4 | 7 | 2.377.06.01.05 | Стенка | 1
A4 | 8 | 2.377.06.01.06 | Стенка | 1
A4 | 9 | 2.377.06.01.07 | Фланец | 1
A3 | 10 2.377.06.01.08 | | Профиль | 2
| 11 2.377.06.01.08-01 | | Профиль | 2
A3 | 12 2.377.06.01.09 | | Профиль | 1
A4 | 13 2.377.06.01.11 | | Кольцо | 2
A4 | 14 2.377.06.01.16 | | Стенка | 2
A4 | 15 2.377.06.01.17 | | Стенка | 1
A4 | 16 2.377.06.01.18 | | Стенка | 1
A3 | 17 2.377.06.01.19 | | Фланец | 1
A4 | 18 2.377.06.01.26 | | Косынка | 2
A3 | 19 2.377.06.01.27 | | Фланец | 1

Инв. № подл. Подп. и дата Взам. инв. № Инв. № дубл. Подп. и дата Перв. примен. Справ. №

Формат А4

2.377.06.01.10

Копировал

Изм. Лист | № докум. | Подп. | Дата
| Разраб. | | | Корпус | Лит. | Лист | Листов
Пров. | | | | И | | 1 | 2

Н. контр.
Утв.

Файл: 2.377.06.01.10_Корпус

Шифр: | Версия 3

Формат
Зона
Поз.
Обозначение | Наименование

Кол.

Приме-чание

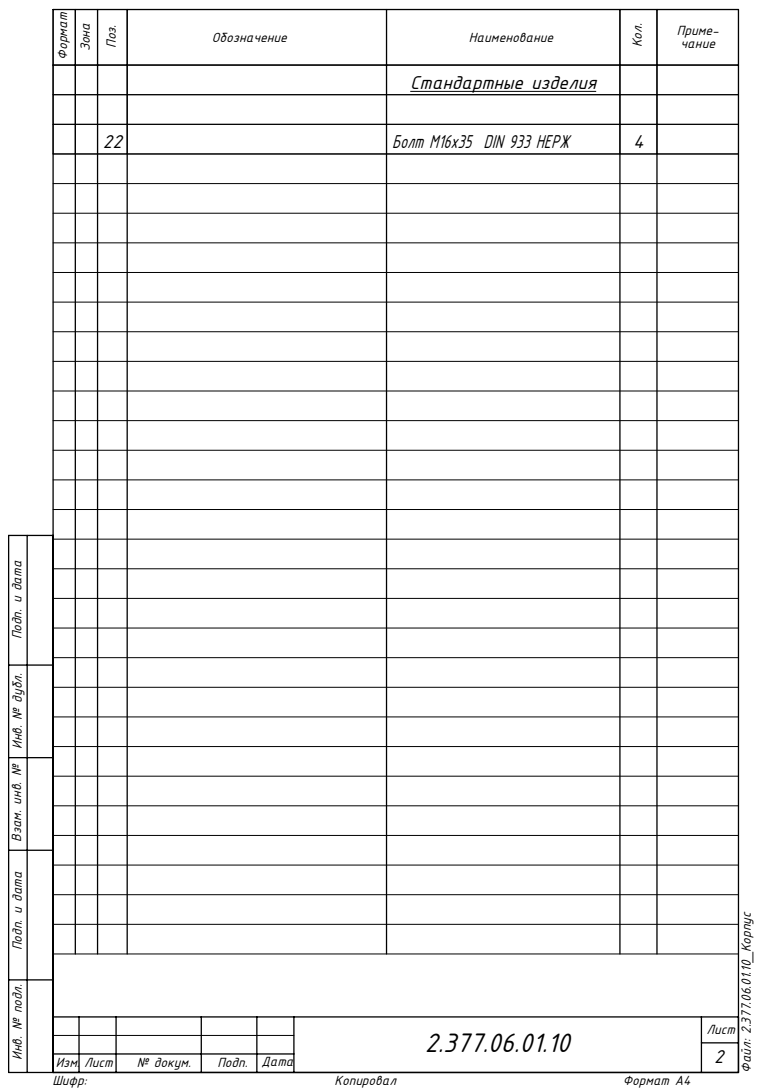
[picture p195: page 2]
Болт М16х35 DIN 933 НЕРЖ; Копировал; Формат А4; Изм. Лист; № докум.; Подп.; Дата; Файл: 2.377.06.01.10_Корпус

Наименование | Приме-чание Обозначение

Стандартные изделия

Инв. № подл. Подп. и дата Взам. инв. № Инв. № дубл. Подп. и дата

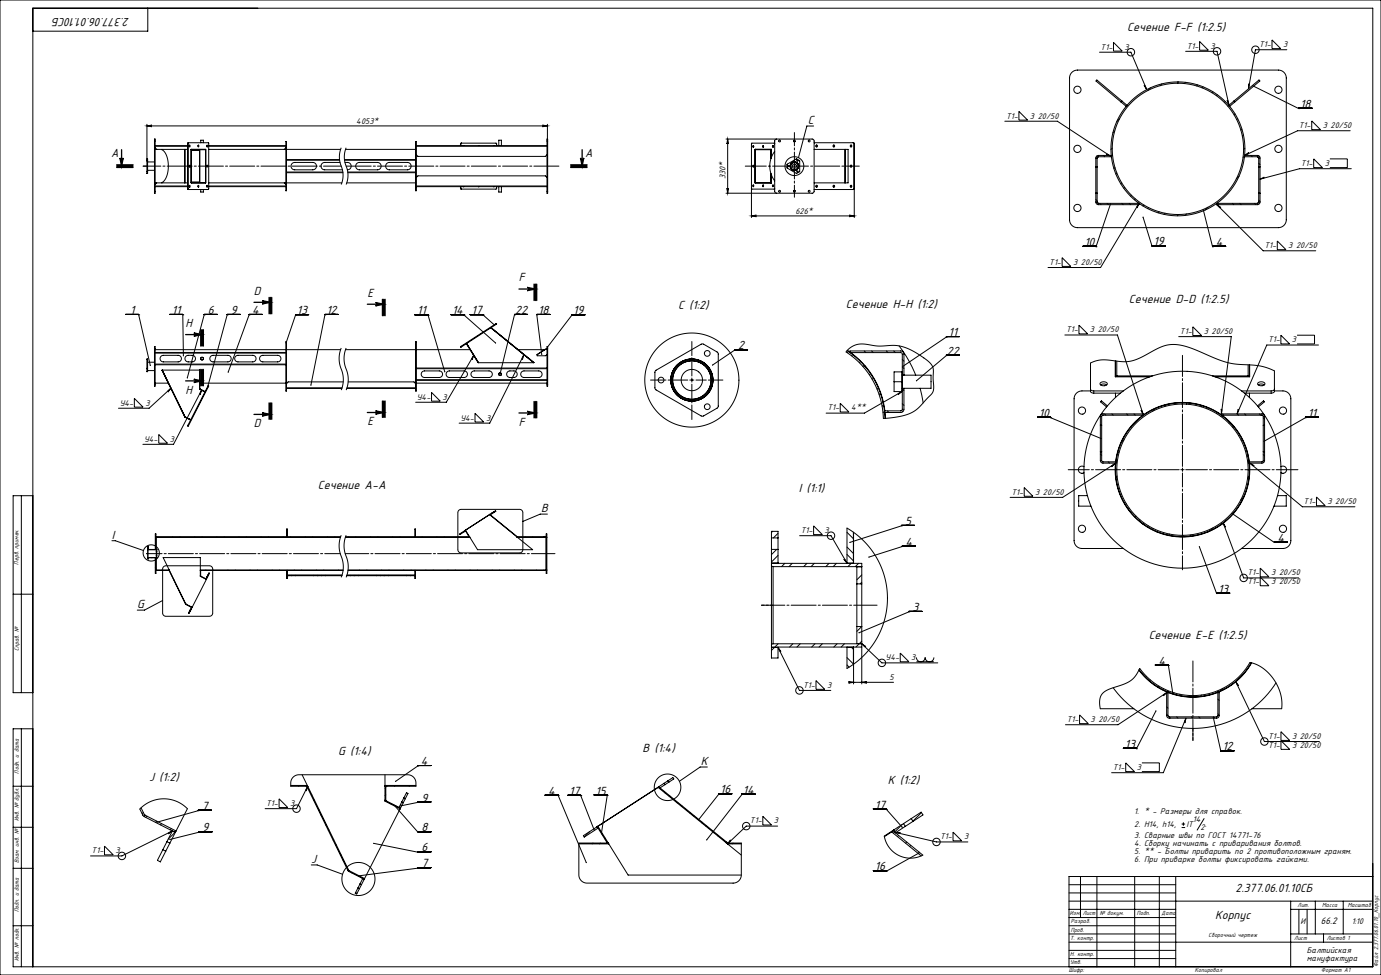
[picture p196: page 3]
Сечение A-A; Сечение D-D (1:2.5); Сечение E-E (1:2.5); Сечение F-F (1:2.5); Сечение H-H (1:2); Инв. № подл.; Формат A1; Файл: 2.377.06.01.10_Корпус

Подп. и дата Взам. инв. № Инв. № дубл. Подп. и дата Перв. примен. Справ. №

1. * - Размеры для справок.
3. Сварные швы по ГОСТ 14771-76
4. Сборку начинать с приваривания болтов.
5. ** - Болты приварить по 2 противоположным граням.
6. При приварке болты фиксировать гайками.

Корпус Сборочный чертеж | Лит. | Масса | Масштаб

Изм. Лист № докум. | Подп. | Дата | | | И | | 66.2 | 1:10
Разраб.
Пров.
Т. контр. | | | Лист | Листов 1

Балтийская мануфактура

Н. контр.
Утв.
