Glebjack/NDM-VOS_powder_hopper/РАЗГРУЗЧИК 2.377.06.00.00 (2)/2.377.06.01.12_Профиль — копия.PDF

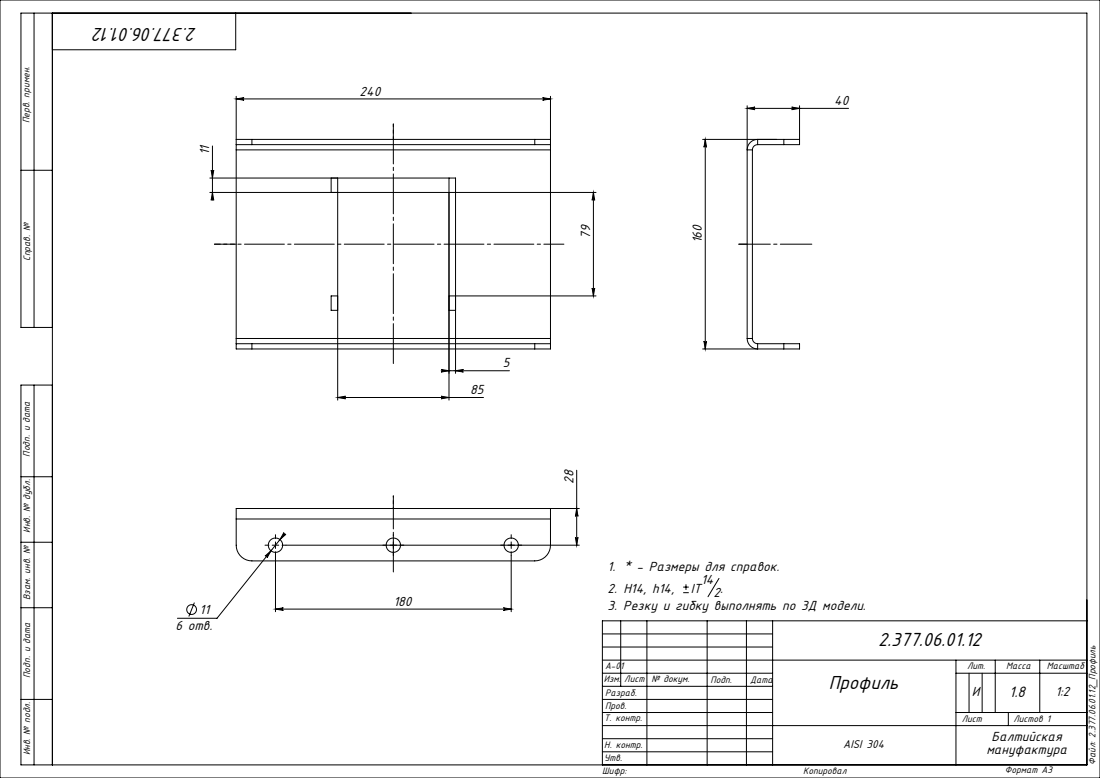
[picture p197: page 1]
180 11 6 отв.; Инв. № подл.; Формат A3; Файл: 2.377.06.01.12_Профиль; Шифр:; Версия 3

Подп. и дата Взам. инв. № Инв. № дубл. Подп. и дата Перв. примен. Справ. №

1. * - Размеры для справок.
3. Резку и гибку выполнять по 3Д модели.

А-01 | | | Профиль | Лит. | Масса | Масштаб
Изм. Лист № докум. | Подп. | Дата | | | И | | 1.8 | 1:2
Разраб.
Пров.
Т. контр. | | | Лист | Листов 1

AISI 304 | Балтийская мануфактура

Н. контр.
Утв.
