Glebjack/NDM-VOS_powder_hopper/РАЗГРУЗЧИК 2.377.06.00.00 (2)/2.377.06.01.13_Ребро — копия.PDF

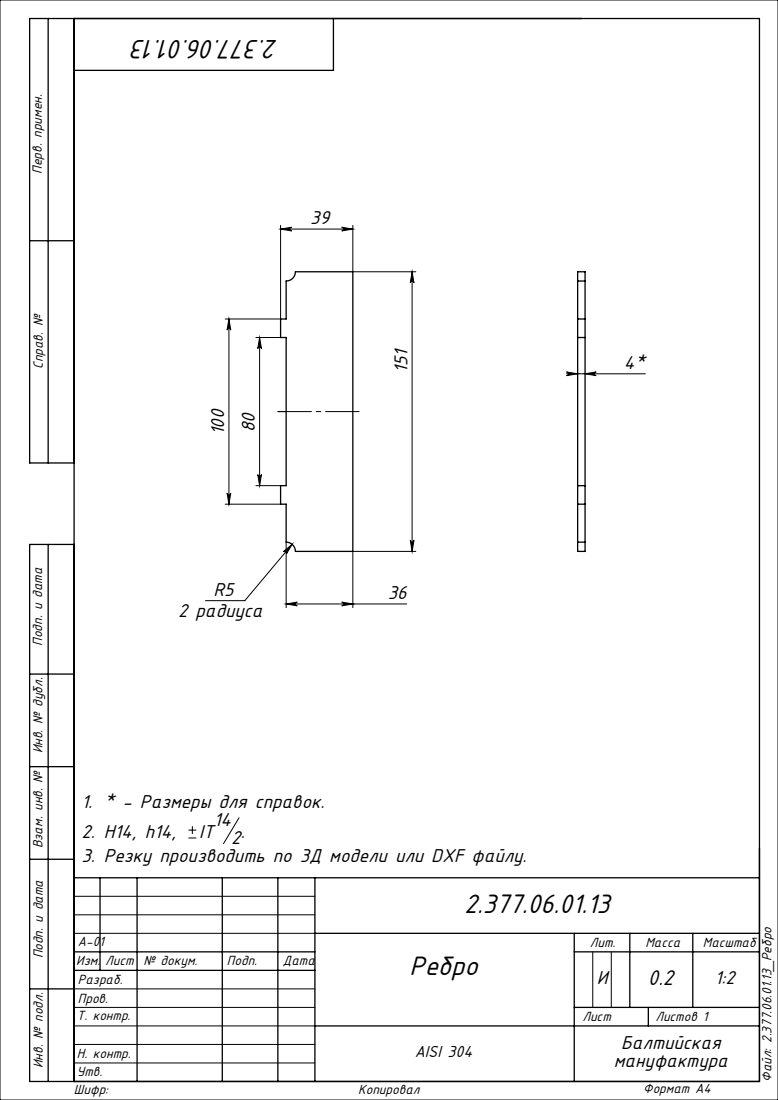
[picture p198: page 1]
2 радиуса; Инв. № подл.; Формат A4; Файл: 2.377.06.01.13_Ребро; Шифр:; Версия 3

Подп. и дата Взам. инв. № Инв. № дубл. Подп. и дата Перв. примен. Справ. №

1. * - Размеры для справок.
3. Резку производить по 3Д модели или DXF файлу.

А-01 | | | | Ребро | Лит. | Масса | Масштаб
Изм. Лист № докум. | | Подп. | Дата | | | И | | 0.2 | 1:2
Разраб.
Пров.
Т. контр. | | | | Лист | Листов 1

AISI 304 | Балтийская мануфактура

Н. контр.
Утв.
