Glebjack/NDM-VOS_powder_hopper/РАЗГРУЗЧИК 2.377.06.00.00 (2)/2.377.06.01.19_Фланец — копия.PDF

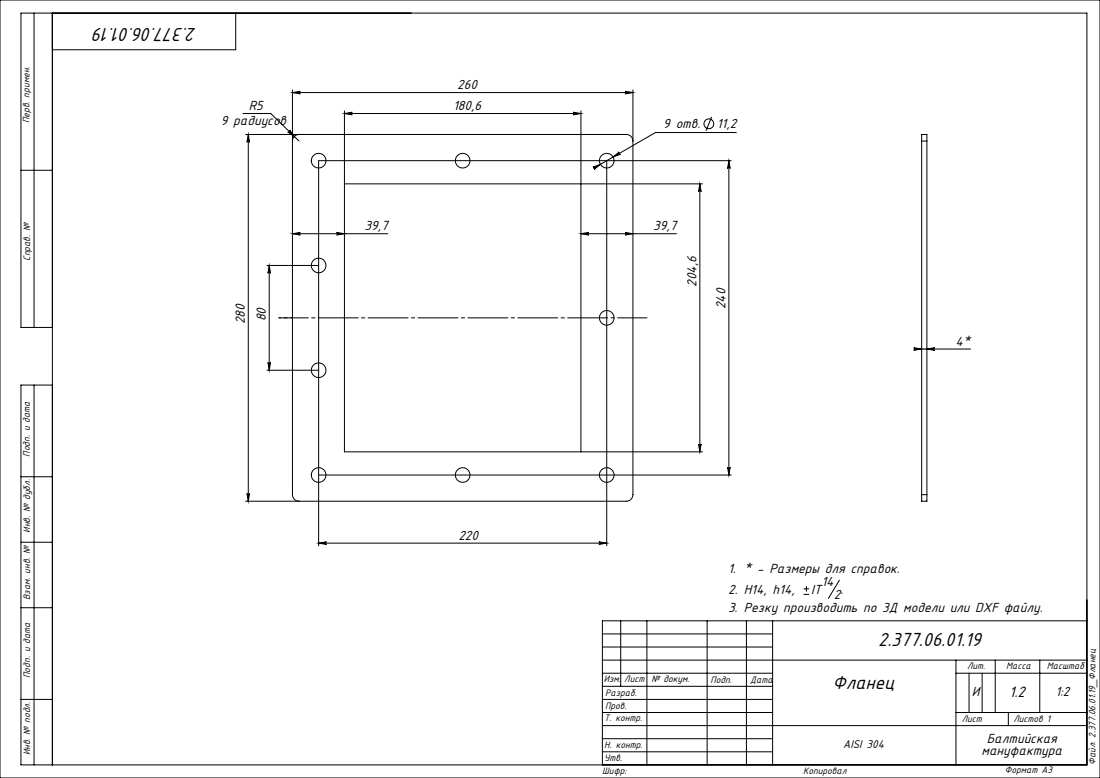
[picture p200: page 1]
9 отв. 11,2; 9 радиусов; Инв. № подл.; Формат A3; Файл: 2.377.06.01.19_Фланец; Шифр:; Версия 3

Подп. и дата Взам. инв. № Инв. № дубл. Подп. и дата Перв. примен. Справ. №

1. * - Размеры для справок.
3. Резку производить по 3Д модели или DXF файлу.

Фланец | Лит. | Масса | Масштаб

Изм. Лист № докум. | Подп. | Дата | | | И | | 1.2 | 1:2
Разраб.
Пров.
Т. контр. | | | Лист | Листов 1

AISI 304 | Балтийская мануфактура

Н. контр.
Утв.
