Glebjack/NDM-VOS_powder_hopper/РАЗГРУЗЧИК 2.377.06.00.00 (2)/2.377.06.01.20_Опора — копия.PDF

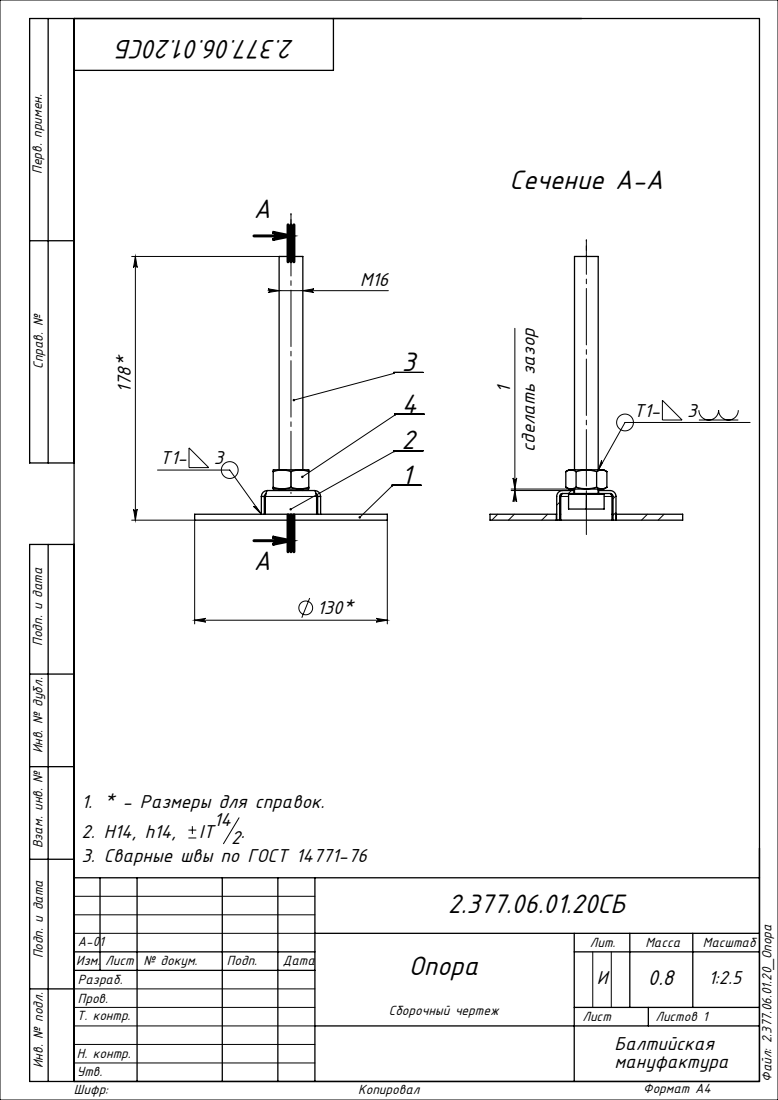
[picture p201: page 1]
сделать зазор; Сечение A-A; Инв. № подл.; Формат A4; Файл: 2.377.06.01.20_Опора; Шифр:; Версия 3

Подп. и дата Взам. инв. № Инв. № дубл. Подп. и дата Перв. примен. Справ. №

1. * - Размеры для справок.
3. Сварные швы по ГОСТ 14771-76

А-01 | | | | Опора Сборочный чертеж | Лит. | Масса | Масштаб
Изм. Лист № докум. | | Подп. | Дата | | | И | | 0.8 | 1:2.5
Разраб.
Пров.
Т. контр. | | | | Лист | Листов 1

Балтийская мануфактура

Н. контр.
Утв.

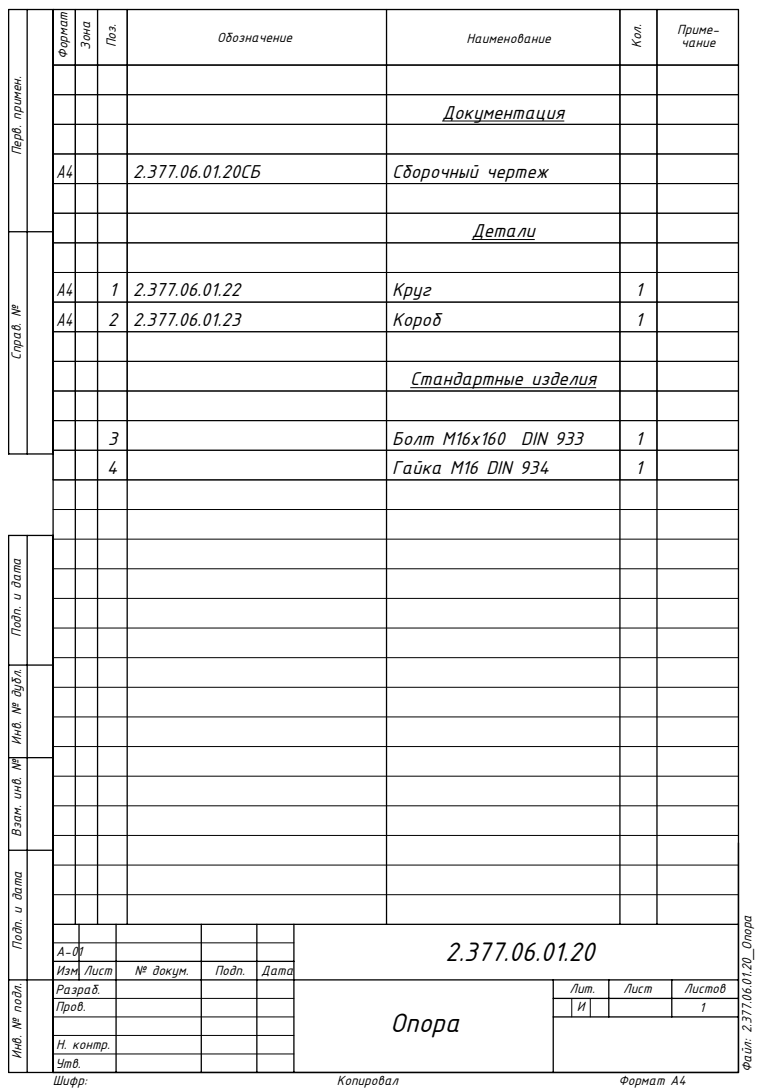
[picture p202: page 2]
Сборочный чертеж; Стандартные изделия; Формат А4; Файл: 2.377.06.01.20_Опора; Шифр:; Версия 3

Инв. № подл. Подп. и дата Взам. инв. № Инв. № дубл. Подп. и дата Перв. примен. Справ. №

A4 | 1 | 2.377.06.01.22 | Круг | 1
A4 | 2 | 2.377.06.01.23 | Короб | 1

3 | Болт М16х160 DIN 933 | 1
4 | Гайка М16 DIN 934 | 1

А-01
Изм. Лист | № докум. | Подп. | Дата
Разраб. | | | Опора | Лит. | Лист | Листов
Пров. | | | | И | | | 1

Н. контр.
Утв.
