Glebjack/NDM-VOS_powder_hopper/РАЗГРУЗЧИК 2.377.06.00.00 (2)/2.377.06.01.21_Уолок — копия.PDF

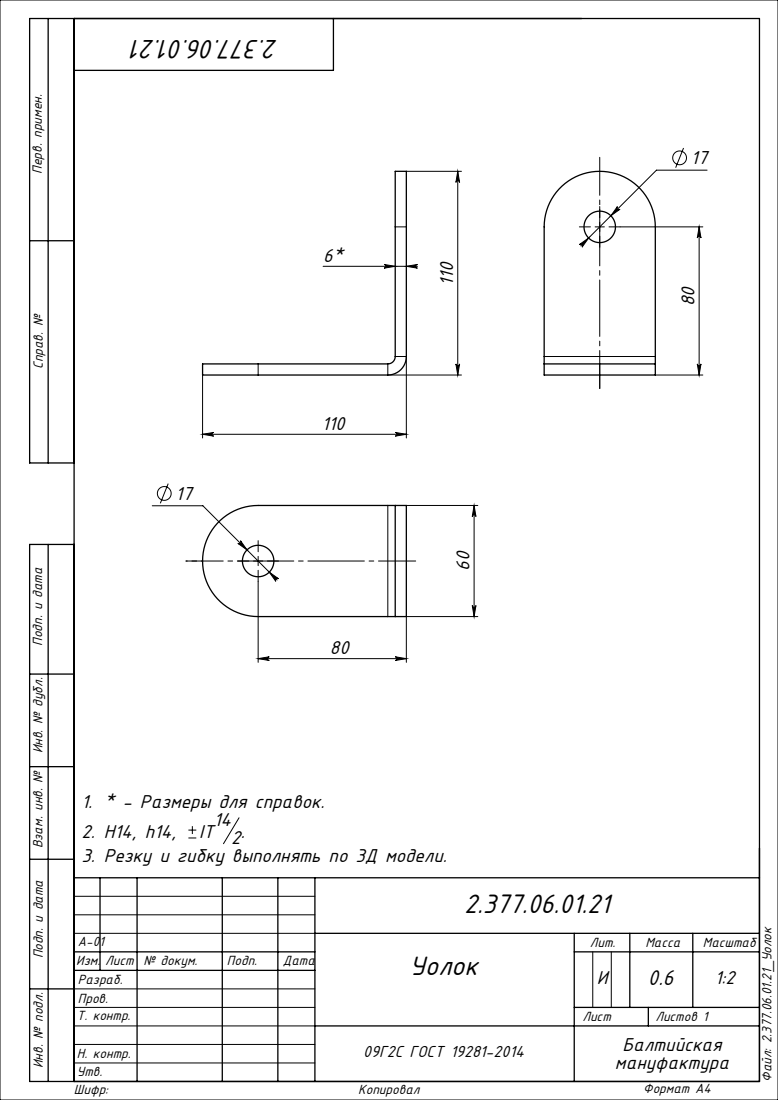
[picture p203: page 1]
Инв. № подл.; Формат A4; Файл: 2.377.06.01.21_Уолок; Шифр:; Версия 3

Подп. и дата Взам. инв. № Инв. № дубл. Подп. и дата Перв. примен. Справ. №

1. * - Размеры для справок.
3. Резку и гибку выполнять по 3Д модели.

А-01 | | | | Уолок | Лит. | Масса | Масштаб
Изм. Лист № докум. | | Подп. | Дата | | | И | | 0.6 | 1:2
Разраб.
Пров.
Т. контр. | | | | Лист | Листов 1

09Г2С ГОСТ 19281-2014 | Балтийская мануфактура

Н. контр.
Утв.
