Glebjack/NDM-VOS_powder_hopper/РАЗГРУЗЧИК 2.377.06.00.00 (2)/2.377.06.01.26_Косынка — копия.PDF

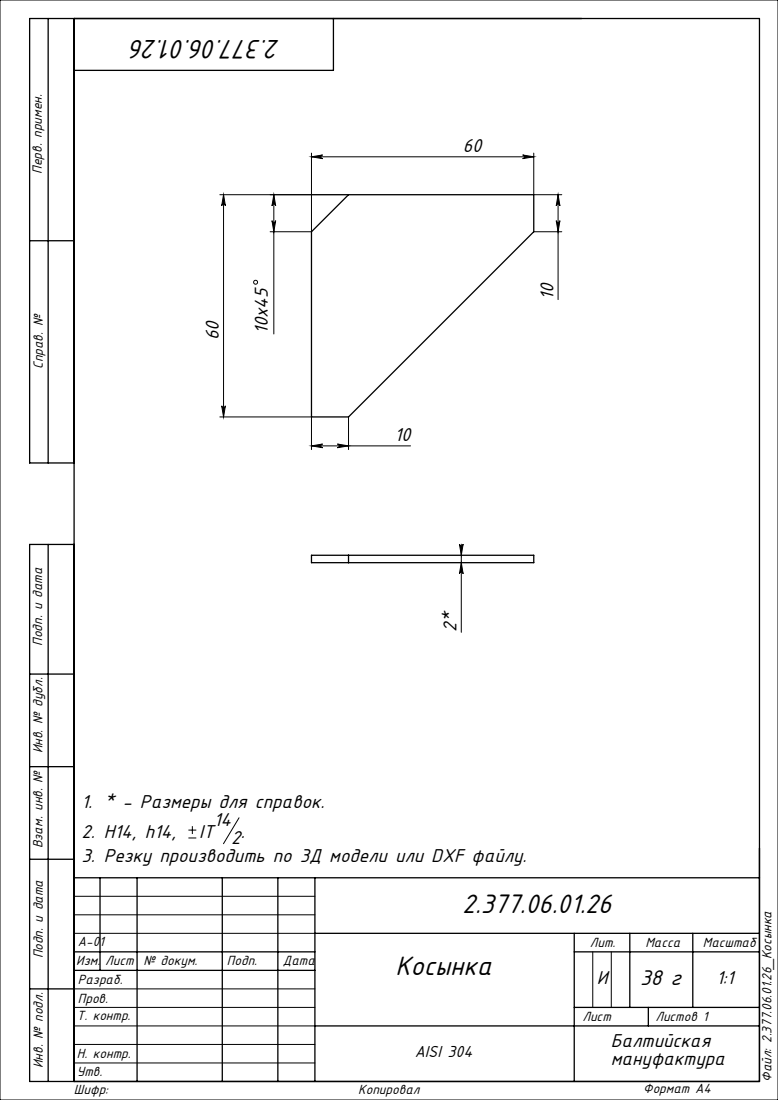
[picture p208: page 1]
Инв. № подл.; Формат A4; Файл: 2.377.06.01.26_Косынка; Шифр:; Версия 3

Подп. и дата Взам. инв. № Инв. № дубл. Подп. и дата Перв. примен. Справ. №

1. * - Размеры для справок.
3. Резку производить по 3Д модели или DXF файлу.

А-01 | | | | Косынка | Лит. | Масса | Масштаб
Изм. Лист № докум. | | Подп. | Дата | | | И | | 38 г | 1:1
Разраб.
Пров.
Т. контр. | | | | Лист | Листов 1

AISI 304 | Балтийская мануфактура

Н. контр.
Утв.
