Glebjack/NDM-VOS_powder_hopper/РАЗГРУЗЧИК 2.377.06.00.00 (2)/2.377.06.01.30_Фланец — копия.PDF

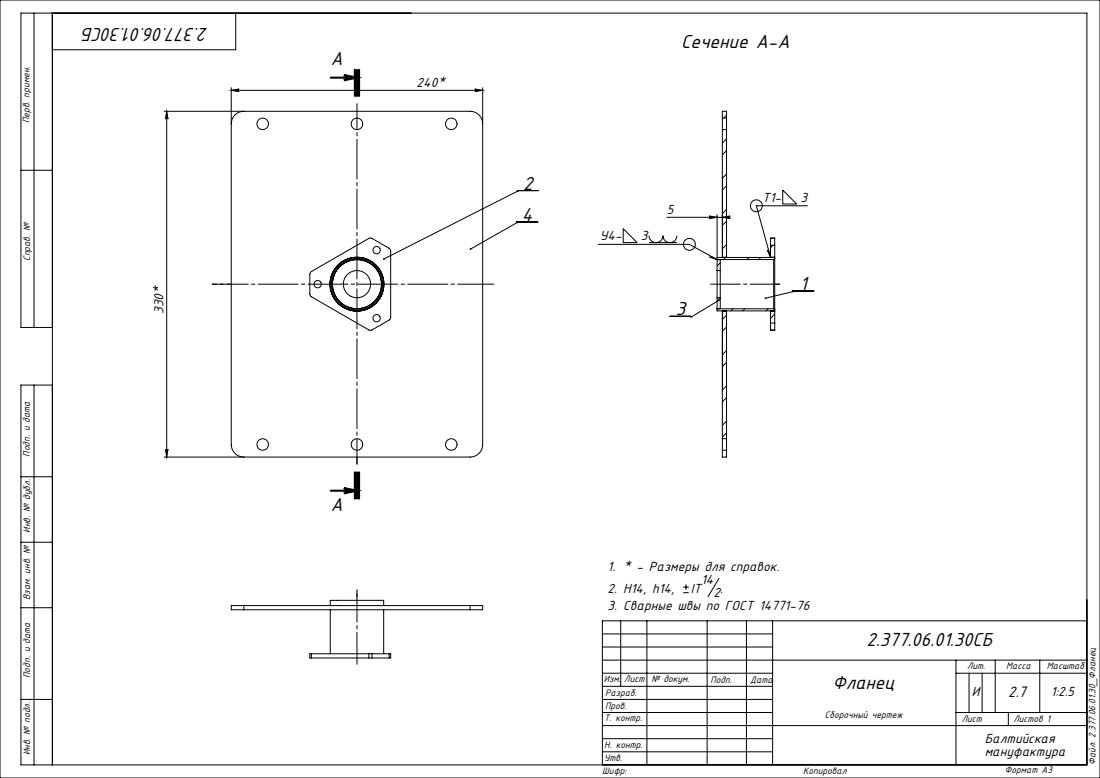
[picture p209: page 1]
Сечение A-A 3; Инв. № подл.; Формат A3; Файл: 2.377.06.01.30_Фланец; Шифр:; Версия 3

Подп. и дата Взам. инв. № Инв. № дубл. Подп. и дата Перв. примен. Справ. №

1. * - Размеры для справок.
3. Сварные швы по ГОСТ 14771-76

Фланец Сборочный чертеж | Лит. | Масса | Масштаб

Изм. Лист № докум. | Подп. | Дата | | | И | | 2.7 | 1:2.5
Разраб.
Пров.
Т. контр. | | | Лист | Листов 1

Балтийская мануфактура

Н. контр.
Утв.

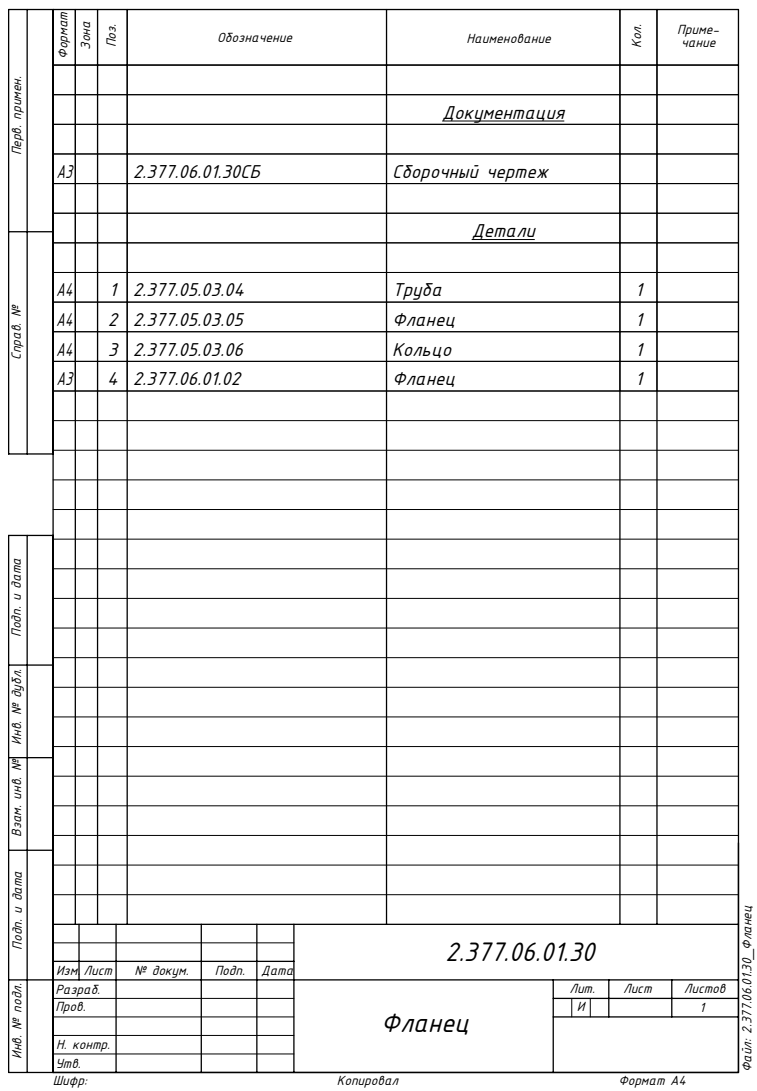
[picture p210: page 2]
Сборочный чертеж; Формат А4; Файл: 2.377.06.01.30_Фланец; Шифр:; Версия 3

Инв. № подл. Подп. и дата Взам. инв. № Инв. № дубл. Подп. и дата Перв. примен. Справ. №

A4 | 1 | 2.377.05.03.04 | Труба | 1
A4 | 2 | 2.377.05.03.05 | Фланец | 1
A4 | 3 | 2.377.05.03.06 | Кольцо | 1
A3 | 4 | 2.377.06.01.02 | Фланец | 1

Изм. Лист | № докум. | Подп. | Дата
Разраб. | | | Фланец | Лит. | Лист | Листов
Пров. | | | | И | | | 1

Н. контр.
Утв.
