Glebjack/NDM-VOS_powder_hopper/РАЗГРУЗЧИК 2.377.06.00.00 (2)/2.377.06.01.40_Проставка — копия.PDF

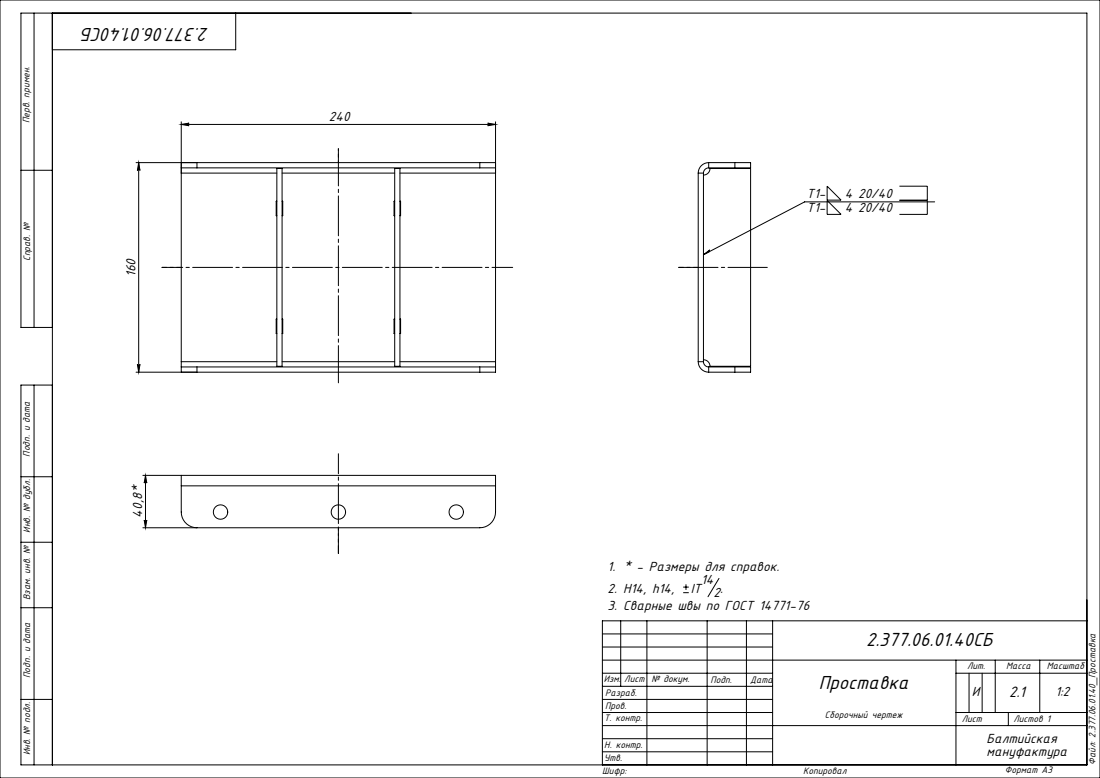
[picture p211: page 1]
Инв. № подл.; Формат A3; Файл: 2.377.06.01.40_Проставка; Шифр:; Версия 3

Подп. и дата Взам. инв. № Инв. № дубл. Подп. и дата Перв. примен. Справ. №

1. * - Размеры для справок.
3. Сварные швы по ГОСТ 14771-76

Проставка Сборочный чертеж | Лит. | Масса | Масштаб

Изм. Лист № докум. | Подп. | Дата | | | И | | 2.1 | 1:2
Разраб.
Пров.
Т. контр. | | | Лист | Листов 1

Балтийская мануфактура

Н. контр.
Утв.

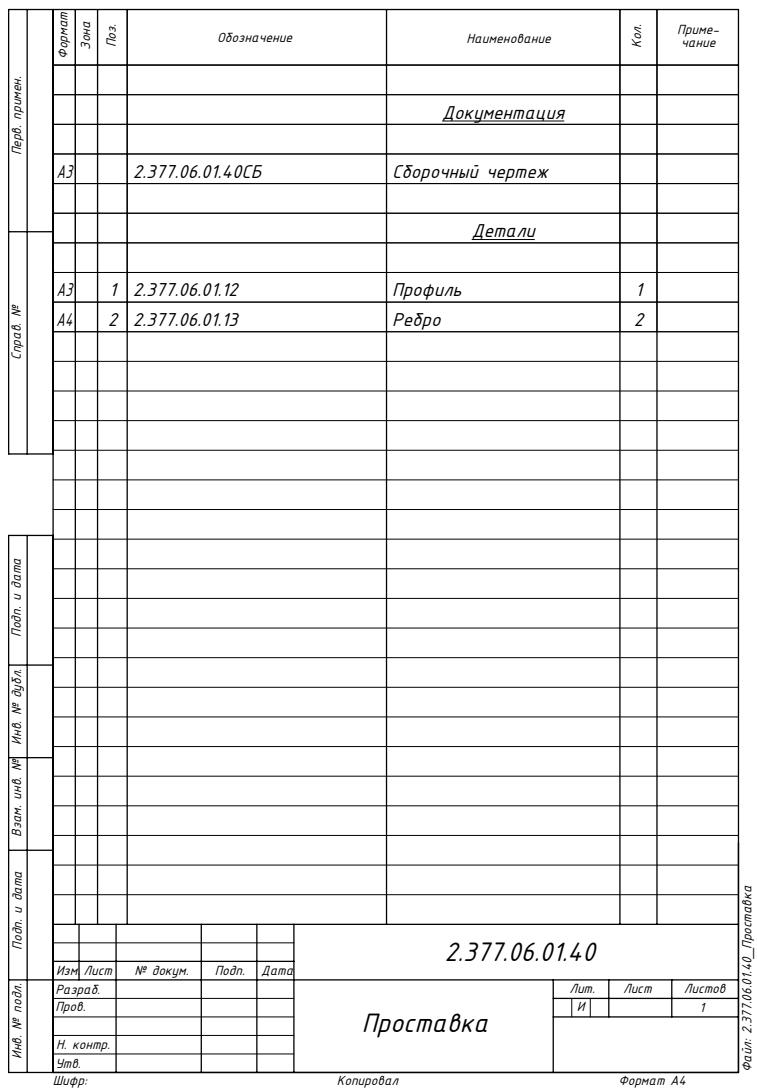
[picture p212: page 2]
Сборочный чертеж; Формат А4; Файл: 2.377.06.01.40_Проставка; Шифр:; Версия 3

Инв. № подл. Подп. и дата Взам. инв. № Инв. № дубл. Подп. и дата Перв. примен. Справ. №

A3 | 1 | 2.377.06.01.12 | Профиль | 1
A4 | 2 | 2.377.06.01.13 | Ребро | 2

Изм. Лист | № докум. | Подп. | Дата
Разраб. | | | Проставка | Лит. | Лист | Листов
Пров. | | | | И | | | 1

Н. контр.
Утв.
