Glebjack/NDM-VOS_powder_hopper/(commit log)

2024-09-25 начало
    [ASY NDM-VOS_powder_hopper.0003.iam, ASY NDM-VOS_powder_hopper.iam, Dimensions_sketch.0011.ipt, Dimensions_sketch.ipt, Dummy 3.ipt, Elbow.0004.ipt, Elbow.ipt, Forearm.0004.ipt]
2024-09-27 новая бочка
    [NDM-VOS dummy3.0003.ipt, NDM-VOS dummy3.ipt]
2024-09-30 Глеб
    [Frame 1727705277523.iam, Frame 1727706296946.iam, Frame 1727706676305.iam, ISO 4019 60x60x4 1727705278580.ipt, ISO 4019 60x60x4 1727705278629.ipt, ISO 4019 60x60x4 1727705278679.ipt, ISO 4019 60x60x4 1727705278728.ipt, ISO 4019 60x60x4 1727705278779.ipt]
2024-10-01 Глеб 2
    [ASY NDM-VOS_powder_hopper.0003.iam, ASY NDM-VOS_powder_hopper.0004.iam, ASY NDM-VOS_powder_hopper.iam, Frame 1727706296946.0001.iam, Frame 1727706296946.iam, ISO 4019 60x60x4 1727706298262.0001.ipt, ISO 4019 60x60x4 1727706298262.ipt, ISO 4019 60x60x4 1727706298312.0001.ipt]
2024-10-02 Глеб 3
2024-10-04 Глеб 4
2024-10-04 Глеб 4.1
2024-10-05 болванка шредера
    добавил файлы старого шнека с бункером
    [2.377.06.00.00_Разгрузчик.DWG, 2.377.06.00.00_Разгрузчик.SLDASM, 2.377.06.00.00_Разгрузчик.SLDDRW, 2.377.06.00.00_Разгрузчик.iam, 2.377.06.00.00_Разгрузчик_Лист1.dwg, 2.377.06.00.01_Вал.SLDDRW, 2.377.06.00.01_Вал.SLDPRT, 2.377.06.00.02_Втулка.SLDDRW]
2024-10-05 Докоммит
    [ASY NDM-VOS_powder_hopper.0007.iam, ASY NDM-VOS_powder_hopper.0008.iam, ASY NDM-VOS_powder_hopper.iam, NDM-VOS dummy2.0002.ipt, NDM-VOS dummy2.0003.ipt, NDM-VOS dummy2.ipt, NDM-VOS dummy5.0002.ipt, NDM-VOS dummy5.0003.ipt]
2024-10-05 Глеб 5
2024-10-11 Расстановка 0.1
    [ASY NDM-VOS_powder_hopper.0008.iam, ASY NDM-VOS_powder_hopper.0009.iam, ASY NDM-VOS_powder_hopper.iam]
2024-10-30 Расстановка 1.0
    [ASY NDM-VOS_powder_hopper.0009.iam, ASY NDM-VOS_powder_hopper.iam, ASY NDM-VOS_powder_hopper.idw, Frame 1727706296946.0001.iam, Frame 1727706296946.iam, ISO 4019 60x60x4 1727706298262.0001.ipt, ISO 4019 60x60x4 1727706298262.ipt, ISO 4019 60x60x4 1727706298361.0001.ipt]
2024-10-30 Глеб дробилка
    [ASY NDM-VOS_powder_hopper.0020.iam, ASY NDM-VOS_powder_hopper.iam, Измельчитель комков.0001.ipt, Измельчитель комков.ipt, Рама осн..0001.iam, Рама осн..0002.iam, Рама осн..iam, Рама.0008.iam]
2024-12-05 ОГРОМНЫЙ КОММИТ
    [2.263.00.00.00.СБ__дробилка.STP, 2.263.00.00.00.СБ__дробилка_TOP.iam, ASY HPR 200 Frame.0004.iam, ASY HPR 200 Frame.iam, ASY HPR 300 Frame human.0003.iam, ASY HPR 300 Frame human.iam, ASY MSC 100 cone.0172.iam, ASY MSC 100 cone.iam]
2024-12-20 Глобальный коммит
    [AQUA 304 mm=10_ NVPH-322 joint HDPE ring__x2.dxf, AQUA 304 mm=10_ NVPH-301 back side__x1.dxf, AQUA 304 mm=10_ NVPH-302 front side__x1.dxf, AQUA 304 mm=10_ NVPH-304 right side__x2.dxf, AQUA 304 mm=10_ NVPH-305 main flange__x1.dxf, AQUA 304 mm=10_ NVPH-306 revision cup__x1.dxf, AQUA 304 mm=10_ NVPH-319 conductor__x2.dxf, AQUA 304 mm=10_ NVPH-332 tube flange 1__x3.dxf]
2025-01-14 шредер + увеличение конуса
    [AQUA 3mm MSC 815 wall inner joint _x10.dxf, AQUA 3mm MSC 923 step _x.dxf, AQUA 3mm NVPH-413 revision steel circle _x6.dxf, ASY Augur motor frame 500.0001.iam, ASY Augur motor frame 500.iam, ASY HPR 600 Feeder head.0007.iam, ASY HPR 600 Feeder head.iam, ASY MSC 100 cone.0179.iam]
2025-01-14 Глеб
    Ребра + решетка
    [ASY MSC 100 cone.0177.iam, ASY MSC 100 cone.0179.iam, ASY MSC 100 cone.0181.iam, ASY MSC 100 cone.iam, ASY NDM-VOS_powder_hopper.0061.iam, ASY NDM-VOS_powder_hopper.0067.iam, ASY NDM-VOS_powder_hopper.0068.iam, ASY NDM-VOS_powder_hopper.iam]
2025-01-15 Шредер готов. колосник
    [ASY MSC 100 cone.0181.iam, ASY MSC 100 cone.0187.iam, ASY MSC 100 cone.iam, ASY NDM-VOS_powder_hopper.0002.idw, ASY NDM-VOS_powder_hopper.0005.idw, ASY NDM-VOS_powder_hopper.0007.idw, ASY NDM-VOS_powder_hopper.0068.iam, ASY NDM-VOS_powder_hopper.0070.iam]
2025-01-15 Глеб
    Дособрал сетку+растариватель
    [ASY MSC 100 cone.0187.iam, ASY MSC 100 cone.0188.iam, ASY MSC 100 cone.iam, ASY NDM-VOS_powder_hopper.0070.iam, ASY NDM-VOS_powder_hopper.0071.iam, ASY NDM-VOS_powder_hopper.iam, MSC 201 GRID.0007.ipt, MSC 201 GRID.0008.ipt]
2025-01-16 финал очка
    [ASY Augur motor frame 500.0001.iam, ASY Augur motor frame 500.0002.iam, ASY Augur motor frame 500.iam, ASY HPR 200 Frame.0005.iam, ASY HPR 200 Frame.0015.iam, ASY HPR 200 Frame.iam, ASY HPR 600 Feeder head.0006.iam, ASY HPR 600 Feeder head.0007.iam]
2025-01-17 верхняя рама на бочке
    [AQUA 304 mm=10_ NVPH-322 joint HDPE ring__x2.dxf, AQUA 304 mm=10_ NVPH-301 back side__x1.dxf, AQUA 304 mm=10_ NVPH-302 front side__x1.dxf, AQUA 304 mm=10_ NVPH-304 right side__x2.dxf, AQUA 304 mm=10_ NVPH-305 main flange__x1.dxf, AQUA 304 mm=10_ NVPH-306 revision cup__x1.dxf, AQUA 304 mm=10_ NVPH-319 conductor__x2.dxf, AQUA 304 mm=10_ NVPH-332 tube flange 1__x3.dxf]
2025-01-17 Auto stash before rebase of "main" onto "Glebjack/main"
    [MNT-CDF-601 CAP.0001.ipt, MNT-CDF-601 CAP.ipt, MNT-CDF-602 CAP.0001.ipt, MNT-CDF-602 CAP.ipt, MNT-CDF-603 CAP.ipt, MNT-CDF-604 CAP.0001.ipt, MNT-CDF-604 CAP.ipt, MNT-CDF-605 CAP.0001.ipt]
2025-01-19 Глеб
    Платформа+лестница
    [ASY NDM-VOS_powder_hopper.0085.iam, ASY NDM-VOS_powder_hopper.0089.iam, ASY NDM-VOS_powder_hopper.iam, ASY NVPH-300 hopper.0028.iam, ASY NVPH-300 hopper.0032.iam, ASY NVPH-300 hopper.iam, ASY платформа.0003.iam, ASY платформа.iam]
2025-01-20 Пределать перила
    [ASY NDM-VOS_powder_hopper.0007.idw, ASY NDM-VOS_powder_hopper.0008.idw, ASY NDM-VOS_powder_hopper.0089.iam, ASY NDM-VOS_powder_hopper.0091.iam, ASY NDM-VOS_powder_hopper.iam, ASY NDM-VOS_powder_hopper.idw, ASY NVPH-300 hopper.0032.iam, ASY NVPH-300 hopper.0034.iam]
2025-01-20 Глеб
    Сделал платформу
    [ASY NDM-VOS_powder_hopper.0092.iam, ASY NDM-VOS_powder_hopper.0095.iam, ASY NDM-VOS_powder_hopper.iam, ASY NVPH-300 hopper.0035.iam, ASY NVPH-300 hopper.0038.iam, ASY NVPH-300 hopper.iam, ASY Рама №1 платформа.0001.ipt, ASY Рама №1 платформа.0003.iam]
2025-01-21 Глеб
    Частично сделал лестницу
    [ASY NDM-VOS_powder_hopper.0095.iam, ASY NDM-VOS_powder_hopper.0096.iam, ASY NDM-VOS_powder_hopper.iam, ASY NVPH-300 hopper.0038.iam, ASY NVPH-300 hopper.0039.iam, ASY NVPH-300 hopper.iam, ASY Лестница перила.iam, ASY Лестница.0001.iam]
2025-01-22 Глеб
    Доделал задания по лестнице и платформе
    [ASY NDM-VOS_powder_hopper.0096.iam, ASY NDM-VOS_powder_hopper.0101.iam, ASY NDM-VOS_powder_hopper.iam, ASY NVPH-300 hopper.0039.iam, ASY NVPH-300 hopper.0043.iam, ASY NVPH-300 hopper.iam, ASY Лестница перила.0006.iam, ASY Лестница перила.iam]
2025-01-24 Начинаем чертежи
    [ASY Augur motor frame 500.0004.iam, ASY HPR 200 Frame.0017.iam, ASY HPR 200 Frame.iam, ASY HPR 300 Frame human.0004.iam, ASY HPR 340 hopper main tube.0001.iam, ASY HPR 600 Feeder head.0010.iam, ASY NDM-VOS_powder_hopper.0008.idw, ASY NDM-VOS_powder_hopper.0101.iam]
2025-01-24 Глеб
    Частично сделал чертежи
    [ASY MSC 100 cone.0195.iam, ASY MSC 100 cone.0196.iam, ASY MSC 100 cone.iam, ASY NDM-VOS_powder_hopper.0103.iam, ASY NDM-VOS_powder_hopper.iam, ASY NVPH-300 hopper.0045.iam, ASY NVPH-300 hopper.iam, ASY NVPH-400 shredder.0027.iam]
2025-01-26 Глеб
    Сделал чертежи
    [ASY Augur motor frame 500.0005.iam, ASY Augur motor frame 500.iam, ASY Лестница перила.0007.iam, ASY Лестница перила.iam, ASY Лестница.0003.iam, ASY Лестница.iam, ASY Рама №1 платформа.0004.iam, ASY Рама №1 платформа.iam]
2025-01-27 мелочи
    [ASY NDM-VOS_powder_hopper.0103.iam, ASY NDM-VOS_powder_hopper.iam, ASY NVPH-200 shredder shaft full.iam, ASY NVPH-300 hopper.0045.iam, ASY NVPH-300 hopper.iam, ASY NVPH-400 shredder.0027.iam, ASY NVPH-400 shredder.iam, ASY Лестница перила.0007.iam]
2025-10-29 Глеб
    Создал ревит АР
    [План для Реагентного хозяйства подложка Ревит.dwg]
2025-10-30 Глеб
    Рисую ТХ в АР
